stanford-ssi/Aerolotl_AV/floorplan_before_after.png

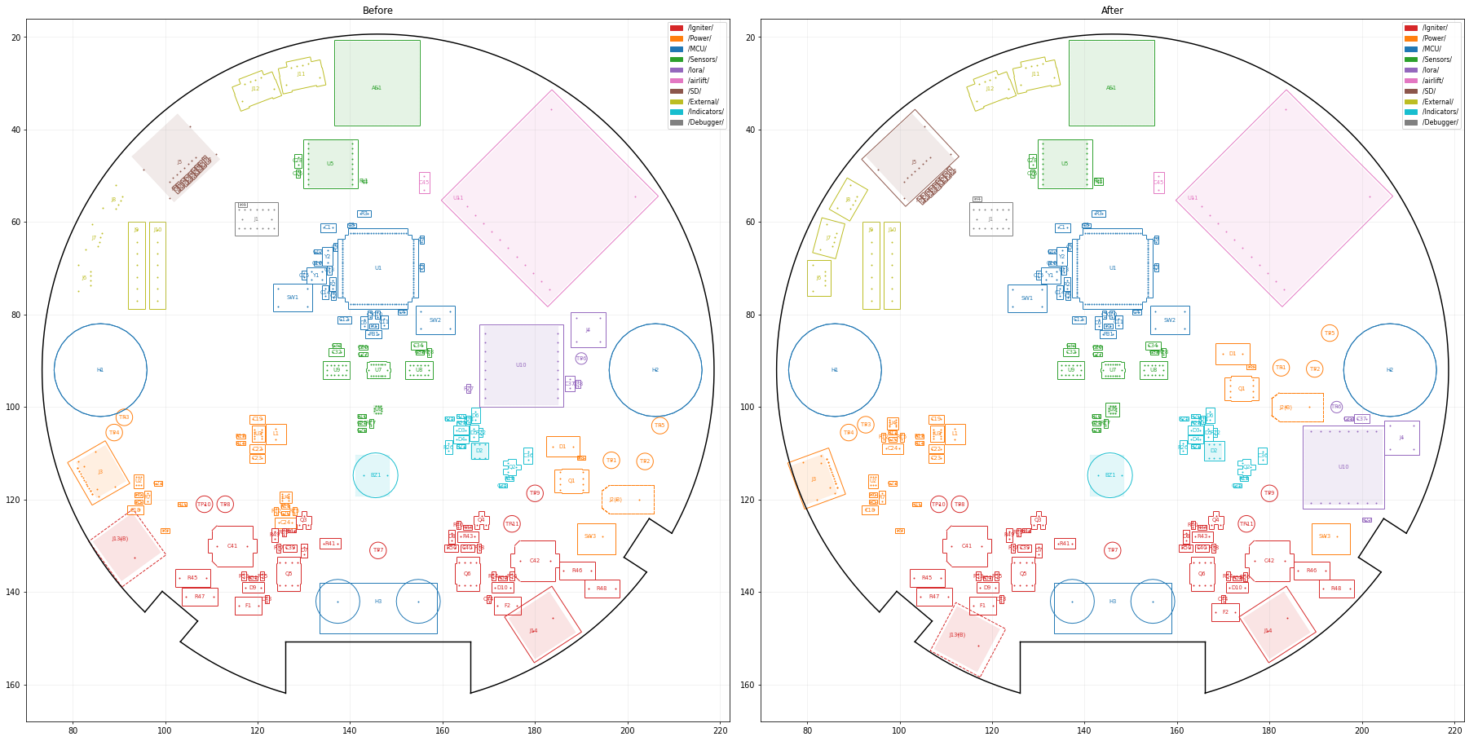
floorplan_before_after.png
