stanford-ssi/Aerolotl_AV/routing_overview.png

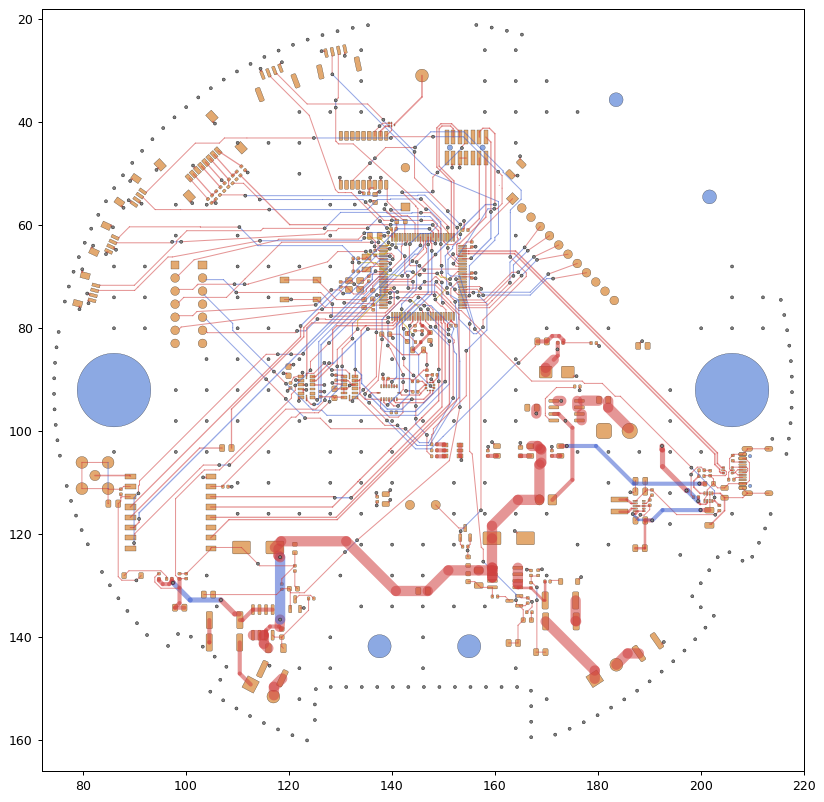
routing_overview.png
