stanford-ssi/Aerolotl_AV/aerolotl_av_BOM.xlsx

Sheet: BOM
Designators | Qty | Value | Footprint | LCSC Part | MPN | Manufacturer | Voltage | Dielectric | Tolerance | ESR / DCR | Power | JLC library | JLC stock (checked 2026-10-02 / 10-06) | Assembly | Side | Sheet | Notes / datasheet check
BZ1 |  | HNB09A03 | BUZ-TH_BD9.0-P5.00-D0.6-FD | C96102 | HNB09A03 | Huaneng |  |  |  |  |  | Extended | 44983 | JLC THT | Top | indicators | Active buzzer (internal oscillator): drive it on/off. PWM is only useful for beep patterns
C1 |  | 4u7 | C_0805_2012Metric | C98195 | CL21B475KAFNNNE | Samsung Electro-Mechanics | 25V | X7R | 10% |  |  | Extended | 311410 | JLC SMT | Top | mcu | STM32G474 DS12288 Fig.16: VDD n x 100nF + 1 x 4.7uF
C2, C3, C4, C5, C7, C8, C9, C25, C26, C27, C29, C30, C31, C33, C35, C38, C43, C44 |  | 100n | C_0402_1005Metric | C1525 | CL05B104KO5NNNC | Samsung Electro-Mechanics | 16V | X7R | 10% |  |  | Basic | 21581667 | JLC SMT | Top | mcu | ADXL345 DS: 0.1uF ceramic at VDD I/O; ADXL375 DS: 0.1uF ceramic at VDD I/O; Ra-01H supply decoupling (TX burst ~120mA); place at module pin 3; STM32G474 DS12288 Fig.16: VREF+ 100nF + 1uF
C6, C11, C12 |  | 1u | C_0603_1608Metric | C29936 | CL10B105KA8NNNC | Samsung Electro-Mechanics | 25V | X7R | 10% |  |  | Extended | 266599 | JLC SMT | Top | mcu | STM32G474 DS12288 Fig.16: VDDA 1uF; STM32G474 DS12288 Fig.16: VREF+ 100nF + 1uF
C10 |  | 10n | C_0402_1005Metric | C15195 | CL05B103KB5NNNC | Samsung Electro-Mechanics | 50V | X7R | 10% |  |  | Basic | 4033054 | JLC SMT | Top | mcu | STM32G474 DS12288 Fig.16: VDDA = 10nF + 1uF (was 100nF)
C13, C15 |  | 15p | C_0402_1005Metric | C1548 | 0402CG150J500NT | FH (Guangdong Fenghua) | 50V | C0G | 5% |  |  | Basic | 1431860 | JLC SMT | Top | mcu | HSE load cap, 12pF crystal: 2 x (12pF - ~4.5pF stray) = ~15pF
C14 |  | 100n | C_0603_1608Metric | C14663 | CC0603KRX7R9BB104 | YAGEO | 50V | X7R | 10% |  |  | Basic | 58141193 | JLC SMT | Top | mcu
C16, C17 |  | 4.7p | C_0402_1005Metric | C1569 | 0402CG4R7C500NT | FH (Guangdong Fenghua) | 50V | C0G | 0.25pF |  |  | Extended (preferred) | 597482 | JLC SMT | Top | mcu | LSE load cap for 6pF crystal: CL = C/2 + Cs (Cs ~3.5-4pF)
C18, C19, C37 |  | 10u | C_0805_2012Metric | C15850 | CL21A106KAYNNNE | Samsung Electro-Mechanics | 25V | X5R | 10% |  |  | Basic | 4951626 | JLC SMT | Top | power | Ra-01H supply decoupling (TX burst ~120mA); place at module pin 3; TPS63802 CIN: 10uF X5R/X7R at VIN-GND (DS 10.2.2.4). 25V 0805 keeps >5uF at 5V bias.; USB 2.0 allows at most 10uF on VBUS at attach (was 22uF)
C20, C21 |  | 1u | C_0402_1005Metric | C52923 | CL05A105KA5NQNC | Samsung Electro-Mechanics | 25V | X5R | 10% |  |  | Basic | 5613299 | JLC SMT | Top | power | TPS2116 VIN1 (VBUS) bypass; TPS2116 VIN2 (+VBAT) bypass
C22, C23, C36 |  | 22u | C_0805_2012Metric | C45783 | CL21A226MAQNNNE | Samsung Electro-Mechanics | 25V | X5R | 20% |  |  | Basic | 3990887 | JLC SMT | Top | power | TPS63802 COUT (DS 10.2.2.3: 22uF nominal, effective >= 10uF after DC bias). Two 0805 25V parts give ~24uF effective at 3.3V.
C24 |  | 100u | C_1206_3216Metric | C15008 | CL31A107MQHNNNE | Samsung Electro-Mechanics | 6.3V | X5R | 20% |  |  | Basic | 1940643 | JLC SMT | Top | power | TPS2116 DS 7.3.4: bulk on VOUT (VSYS) rides through the break-before-make switchover. Also the TPS63802 input bulk.
C28 |  | 10u | C_0603_1608Metric | C19702 | CL10A106KP8NNNC | Samsung Electro-Mechanics | 10V | X5R | 10% |  |  | Basic | 10315650 | JLC SMT | Top | sensors
C32, C34 |  | 1u | CP_EIA-2012-12_Kemet-R | C444768 | TAJR105K010RNJ | Kyocera AVX | 10V | Tantalum (MnO2) | 10% | 25R @100kHz |  | Extended | 2570 | JLC SMT | Top | sensors | ADXL345 DS p.28: 1uF tantalum at VS; ADXL375 DS: 1uF tantalum at VS
C39, C40 |  | 150n | C_0603_1608Metric | C513735 | CC0603KRX7R9BB154 | YAGEO | 50V | X7R | 10% |  |  | Extended | 607110 | JLC SMT | Top | igniter | PMOS gate slow-turn-on cap across +VBAT_ARM (gate-source): 50V part, >10x margin
C41, C42 |  | 330u | CP_Elec_8x10 | C970701 | RVT1E331M0810 | DMBJ | 25V | Aluminum electrolytic | 20% | not specified (standard 105C SMD Al-El) |  | Extended | 1527 | JLC SMT | Top | igniter | Igniter reservoir on +VBAT_ARM (1S, 4.2V max). 25V part kept (already on order list); 6.3V+ would do.
C45 |  | 47u | C_1206_3216Metric | C96123 | CL31A476MPHNNNE | Samsung Electro-Mechanics | 10V | X5R | 20% |  |  | Basic | 296901 | JLC SMT | Top | airlift | Bulk for AirLift (ESP32) Wi-Fi TX current spikes. Place at U11 pin 1 (VIN) / pin 3 (GND). 10V 1206 keeps ~25uF at 3.3V.
D1 |  | SMBJ5.0A | D_SMB | C78423 | SMBJ5.0A | Brightking |  |  |  |  |  | Extended | 113601 | JLC SMT | Top | power | ESD / small-transient TVS only. Breakdown 6.4-7.07V is ABOVE the 6V abs max of U3/U4, so it does not protect them from a surge or a wrong (2S/3S) pack; a wrong pack makes it conduct continuously. Real over-voltage protection needs an OVP switch (open item).
D2 |  | RS-3535MWAR-2JYJY-J | LED-SMD_RS-3535MWAR-2JYJY-J | C110402 | RS-3535MWAR | NATIONSTAR |  |  |  |  |  | Extended | 460049 | JLC SMT | Top | indicators | RS-3535MWAR common anode on +3V3. Resistors set from the datasheet V-I curve: R 270R, G 330R, B 100R
D3 |  | STM LED | LED_0805_2012Metric | C2296 | KT-0805Y | Hubei KENTO |  |  |  |  |  | Basic | 389526 | JLC SMT | Top | indicators
D4 |  | 3V3 LED | LED_0805_2012Metric | C2296 | KT-0805Y | Hubei KENTO |  |  |  |  |  | Basic | 389526 | JLC SMT | Top | indicators
D5 |  | USB LED | LED_0805_2012Metric | C2296 | KT-0805Y | Hubei KENTO |  |  |  |  |  | Basic | 389526 | JLC SMT | Top | indicators
D6 |  | ARM LED | LED_0805_2012Metric | C2296 | KT-0805Y | Hubei KENTO |  |  |  |  |  | Basic | 389526 | JLC SMT | Top | indicators
D7, D8 |  | LED red | LED_0603_1608Metric | C2286 | KT-0603R | Hubei KENTO |  |  |  |  |  | Basic | 4815898 | JLC SMT | Top | igniter
D9, D10 |  | 1N4148W | D_SOD-123 | C81598 | 1N4148W | ST(Semtech) |  |  |  |  |  | Basic | 5168664 | JLC SMT | Top | igniter
F1, F2 |  | 1812L150/24MR | Fuse_1812_4532Metric | C142805 | 1812L150/24MR | Littelfuse |  |  |  |  |  | Extended | 14071 | JLC SMT | Top | igniter
FB1 |  | 100 | L_0805_2012Metric | C1015 | GZ2012D101TF | Sunlord |  |  |  |  |  | Basic | 2341388 | JLC SMT | Top | mcu
FL1 |  | B39162B4300F210 | FILTER-SMD_5P-L1.4-W1.1_RSFPXXXXD | C2650962 | B39162B4300F210 | Qualcomm (RF360) |  |  |  |  |  | Extended | 4559 | JLC SMT | Top | sensors
J1 |  | FTSH-107-STDC14 | STDC14_SAMTEC_FTSH-107-01-L-DV-K-A | C5563894 | FTSH-107-01-L-DV-K-A | Samtec |  |  |  |  |  | Extended | 540 | JLC SMT | Top | swd
J2 |  | Battery (ext.) | AMASS_XT30UPB-M_1x02_P5.0mm_Vertical | C428721 | XT30UPB-M | Changzhou Amass Elec |  |  |  |  |  | Extended | re-check | Hand-solder (bottom side) | Bottom | power | External 1S battery (+BATT pin 1 / GND pin 2), bottom side, hand-solder. AMASS XT30UPB-M vertical male PCB connector, 15A continuous. Mates XT30U-F on the battery lead. Check +/- marking on the housing matches pin 1 = +BATT before soldering.
J3 |  | USB_C_Receptacle_USB2.0_16P | USB_C_Receptacle_HRO_TYPE-C-31-M-12 | C165948 | TYPE-C-31-M-12 | Korean Hroparts |  |  |  |  |  | Extended | 426143 | JLC THT | Top | power
J4 |  | SMA | SMA_BAT-Wireless_BWSMA-KE-Z001_Vertical | C496549 | BWSMA-KE-Z001 | BAT WIRELESS |  |  |  |  |  | Extended | 137898 | JLC THT | Top | lora | 50 ohm. Route ANT-SMA as a short 50R coplanar trace over solid GND.
J5 |  | TF-102-15_SD_read | TF-SMD_TF-102-15 | C266609 | TF-102-15 | XUNPU |  |  |  |  |  | Extended | 19063 | JLC SMT | Top | sd
J6, J8 |  | StemmaQT | StemmaQT | C160390 | BM04B-SRSS-TB(LF)(SN) | JST |  |  |  |  |  | Extended | 52346 | JLC SMT | Top | external
J7 |  | Conn_01x04_Pin | JST_GH_BM04B-GHS-TBT_1x04-1MP_P1.25mm_Vertical | C161692 | BM04B-GHS-TBT(LF)(SN) | JST |  |  |  |  |  | Extended | 14065 | JLC SMT | Top | external
J9 |  | GPIO_PE2-PE6 | PinHeader_1x07_P2.54mm_Vertical | C492406 | PZ254V-11-07P | XFCN |  |  |  |  |  | Extended | 50677 | JLC THT | Top | external
J10 |  | GPIO_PE7-PE11 | PinHeader_1x07_P2.54mm_Vertical | C492406 | PZ254V-11-07P | XFCN |  |  |  |  |  | Extended | 50677 | JLC THT | Top | external
J11 |  | USART3 | JST_GH_BM04B-GHS-TBT_1x04-1MP_P1.25mm_Vertical | C161692 | BM04B-GHS-TBT(LF)(SN) | JST |  |  |  |  |  | Extended | 14065 | JLC SMT | Top | external
J12 |  | LPUART1 | JST_GH_BM04B-GHS-TBT_1x04-1MP_P1.25mm_Vertical | C161692 | BM04B-GHS-TBT(LF)(SN) | JST |  |  |  |  |  | Extended | 14065 | JLC SMT | Top | external
J13 |  | Screw_Terminal_01x02 | TerminalBlock_Kangnex_WJ128V-5.0-2P_C8269 | C8269 | WJ128V-5.0-02P-14-00A | KANGNEX |  |  |  |  |  | Unverified |  | Hand-solder (bottom side) | Bottom | igniter | DROGUE (CH0), bottom side, hand-solder. Fixed 2-pin screw terminal, 5.0 mm pitch; no mating plug. Datasheet: https://www.lcsc.com/datasheet/C8269.pdf
J14 |  | Screw_Terminal_01x02 | TerminalBlock_Kangnex_WJ128V-5.0-2P_C8269 | C8269 | WJ128V-5.0-02P-14-00A | KANGNEX |  |  |  |  |  | Unverified |  | JLC THT | Top | igniter | MAIN (CH1), top side. Fixed 2-pin screw terminal, 5.0 mm pitch; no mating plug. Datasheet: https://www.lcsc.com/datasheet/C8269.pdf
L1 |  | 0.47u | L_Coilcraft_XxL4020 | C18221164 | XFL4015-471MEC | Coilcraft |  |  | 20% | 7.6mR |  | Extended | 2804 | JLC SMT | Top | power | TI-recommended inductor (TPS63802 DS Table 10-2): 0.47uH, Isat 5.4A, 7.6mR, 4x4x1.5mm
Q1, Q5, Q6 |  | DMP2022LSS-13 | SOIC-8_3.9x4.9mm_P1.27mm | C154919 | DMP2022LSS-13 | Diodes Incorporated |  |  |  |  |  | Extended | 651 | JLC SMT | Top | power | High-side igniter PMOS. 1S: Vgs = -VBAT (3.0-4.2V), so Rds(on) must be specified at -2.5V (22mR). FDS6673BZ is specified from -4.5V.; Reverse-polarity PMOS. 1S: Vgs only -3.0 to -4.2V, so a part with Rds(on) specified at -2.5V (22mR) is needed. AO4407A is specified from -4.5V.
Q2, Q3, Q4 |  | AO3400A | SOT-23 | C20917 | AO3400A | AOS |  |  |  |  |  | Basic | 958459 | JLC SMT | Top | indicators
R1 |  | 47 | R_0402_1005Metric | C25118 | 0402WGF470JTCE | UNI-ROYAL | 50V |  | 1% |  | 62.5mW | Extended (preferred) | 391677 | JLC SMT | Top | mcu
R2, R3 |  | 10k | R_0603_1608Metric | C25804 | 0603WAF1002T5E | UNI-ROYAL | 75V |  | 1% |  | 100mW | Basic | 23037967 | JLC SMT | Top | mcu
R4, R22, R42, R44 |  | 100 | R_0402_1005Metric | C25076 | 0402WGF1000TCE | UNI-ROYAL | 50V |  | 1% |  | 62.5mW | Basic | 4080693 | JLC SMT | Top | swd | RGB blue: ~5.5mA typ, 9.5mA worst-case low Vf (<25mA max)
R5, R6 |  | 5k1 | R_0402_1005Metric | C25905 | 0402WGF5101TCE | UNI-ROYAL | 50V |  | 1% |  | 62.5mW | Basic | 6009635 | JLC SMT | Top | power
R7 |  | 0R | R_0603_1608Metric | C21189 | 0603WAF0000T5E | UNI-ROYAL | 75V |  | 1% |  | 100mW | Basic | 23746831 | JLC SMT | Top | power
R8 |  | 100k | R_0402_1005Metric | C25741 | 0402WGF1003TCE | UNI-ROYAL | 50V |  | 1% |  | 62.5mW | Basic | 8233229 | JLC SMT | Top | power
R9, R12, R15, R27, R32, R33, R34, R35, R36, R51, R52, R55, R56 |  | 10k | R_0402_1005Metric | C25744 | 0402WGF1002TCE | UNI-ROYAL | 50V |  | 1% |  | 62.5mW | Basic | 21738660 | JLC SMT | Top | power | Keeps the radio deselected before firmware runs; PR1 divider bottom; VOLT_SENSE divider top
R10 |  | 22k | R_0402_1005Metric | C25768 | 0402WGF2202TCE | UNI-ROYAL | 50V |  | 1% |  | 62.5mW | Basic | 799355 | JLC SMT | Top | power | VOLT_SENSE = VBAT x 22k/32k: 4.2V -> 2.89V, 3.0V -> 2.06V
R11 |  | 33k | R_0402_1005Metric | C25779 | 0402WGF3302TCE | UNI-ROYAL | 50V |  | 1% |  | 62.5mW | Basic | 1209063 | JLC SMT | Top | power | PR1 divider top (from VBUS). VBUS x 10k/43k crosses VREF 1.0V (0.92-1.08) at 4.3V (3.96-4.64V).
R13 |  | 511k | R_0402_1005Metric | C64042 | 0402WGF5113TCE | UNI-ROYAL | 50V |  | 1% |  | 62.5mW | Extended | 175055 | JLC SMT | Top | power | FB top. VOUT = 0.5V x (1 + 511k/91k) = 3.31V (TI DS Table 10-1 values for 3.3V)
R14 |  | 91k | R_0402_1005Metric | C4147 | 0402WGF9102TCE | UNI-ROYAL | 50V |  | 1% |  | 62.5mW | Extended | 12190 | JLC SMT | Top | power | FB bottom
R16, R17, R18, R28, R29, R30, R31 |  | 10 | R_0402_1005Metric | C25077 | 0402WGF100JTCE | UNI-ROYAL | 50V |  | 1% |  | 62.5mW | Basic | 1753546 | JLC SMT | Top | sensors
R19 |  | 3k3 | R_0402_1005Metric | C25890 | 0402WGF3301TCE | UNI-ROYAL | 50V |  | 1% |  | 62.5mW | Basic | 2084377 | JLC SMT | Top | indicators
R20 |  | 270 | R_0402_1005Metric | C25099 | 0402WGF2700TCE | UNI-ROYAL | 50V |  | 1% |  | 62.5mW | Extended | 39060 | JLC SMT | Top | indicators | RGB red: ~5mA (Vf ~1.85V at 5mA, 3.3V anode, MCU sink)
R21, R37, R38 |  | 330 | R_0402_1005Metric | C25104 | 0402WGF3300TCE | UNI-ROYAL | 50V |  | 1% |  | 62.5mW | Basic | 1195841 | JLC SMT | Top | indicators | RGB green: ~2.6mA (green is ~4x brighter than blue per datasheet)
R23, R24 |  | 470 | R_0402_1005Metric | C25117 | 0402WGF4700TCE | UNI-ROYAL | 50V |  | 1% |  | 62.5mW | Basic | 840845 | JLC SMT | Top | indicators
R25 |  | 910 | R_0402_1005Metric | C44933 | 0402WGF9100TCE | UNI-ROYAL | 50V |  | 1% |  | 62.5mW | Extended | 60782 | JLC SMT | Top | indicators
R26 |  | 330 | R_0603_1608Metric | C23138 | 0603WAF3300T5E | UNI-ROYAL | 75V |  | 1% |  | 100mW | Basic | 3256483 | JLC SMT | Top | indicators | ARM LED from +VBAT_ARM: (4.2-2.0)/330 = 6.7mA, 3.0V -> 3mA
R39, R40 |  | 8k2 | R_0402_1005Metric | C25924 | 0402WGF8201TCE | UNI-ROYAL | 50V |  | 1% |  | 62.5mW | Extended (preferred) | 54795 | JLC SMT | Top | igniter
R41, R43 |  | 10k | R_1206_3216Metric | C17902 | 1206W4F1002T5E | UNI-ROYAL | 200V |  | 1% |  | 250mW | Basic | 3041326 | JLC SMT | Top | igniter | PMOS gate pull-up to +VBAT_ARM. 10k: 0.42mA while firing (4.2V). 1206 kept so the footprint does not change.
R45, R46, R47, R48 |  | 1 | R_2512_6332Metric | C840604 | CRM2512-FX-1R00ELF | Bourns | 300V |  | 1% |  | 2W (pulse: ~6W/1s) | Extended | 1117 | JLC SMT | Top | igniter | Igniter series current limit, 2 x 1R in series per channel (3R total with the 1R e-match: ~0.86A at 3.0V, ~1.27A at 4.2V; MJG BP starter all-fire 0.60A, recommended 0.75-1.0A). Per resistor: 1.6W while the match is intact (ms), 3.4W into a shorted output (4.2V/2.3R = 1.83A). Bourns CRM2512 pulse curve (>=1R): ~6W for a 1s single pulse, ~27W for 0.1s. Limit firmware fire time to <= 1s.
R49, R50 |  | 3k3 | R_0603_1608Metric | C22978 | 0603WAF3301T5E | UNI-ROYAL | 75V |  | 1% |  | 100mW | Basic | 5690986 | JLC SMT | Top | igniter | Bleeder: 4.2V^2/3.3k = 5mW
R53, R54 |  | 4.7k | R_0402_1005Metric | C25900 | 0402WGF4701TCE | UNI-ROYAL | 50V |  | 1% |  | 62.5mW | Basic | 15376968 | JLC SMT | Top | igniter | Sense divider top. Firing at 4.2V -> 4.2 x 10k/14.7k = 2.86V at the ADC (was 33k for 12.6V).
SW1 |  | SW_Push | SW_SPST_TL3342 | C2886898 | TL3342F160QG | E-Switch |  |  |  |  |  | Extended | 1892 | JLC SMT | Top | mcu
SW2 |  | SW_SPST | SW_SPST_TL3342 | C2886898 | TL3342F160QG | E-Switch |  |  |  |  |  | Extended | 1892 | JLC SMT | Top | mcu
SW3 |  | SW_SPST | JST_XH_B2B-XH-A_1x02_P2.50mm_Vertical | C158012 | B2B-XH-A(LF)(SN) | JST |  |  |  |  |  | Extended | 305696 | JLC THT | Top | power
U1 |  | STM32G473VET6 | LQFP-100_14x14mm_P0.5mm | C730122 | STM32G473VET6 | STMicroelectronics |  |  |  |  |  | Extended | 99 | JLC SMT | Top | mcu | STM32G473VET6 = G474 without HRTIM (not used here); same die/pinout/LQFP-100. 99 at JLC (G474: 39). Same symbol (STM32G474VETx) is used for the pin map.
U2 |  | USBLC6-2P6 | SOT-666 | C15999 | USBLC6-2P6 | STMicroelectronics |  |  |  |  |  | Extended | 2734 | JLC SMT | Top | power
U3 |  | TPS63802DLAR | TI_VSON-HR-10_2x3mm_P0.5mm_DLA0010A | C2845237 | TPS63802DLAR | Texas Instruments |  |  |  |  |  | Extended | 16686 | JLC SMT | Top | power | 1S buck-boost, VIN 1.3-5.5V, 2A. EN and MODE tied to VIN (always on, forced PWM: lowest ripple for the radio/GPS). Layout per TI DS sec. 12: CIN/COUT next to VIN/VOUT-GND, short L1/L2 loop.
U4 |  | TPS2116DRL | SOT-583-8 | C3235557 | TPS2116DRLR | Texas Instruments |  |  |  |  |  | Extended | 79374 | JLC SMT | Top | power
U5 |  | MAX-M10S | ublox_MAX | C4153167 | MAX-M10S-00B | u-blox |  |  |  |  |  | Extended | 661 | JLC SMT | Top | sensors
U6 |  | BMP581 | LGA-10_L2.0-W2.0-P0.50-TL_BMP581 | C5362283 | BMP581 | Bosch Sensortec |  |  |  |  |  | Extended | 3323 | JLC SMT | Top | sensors
U7 |  | BMI088 | Bosch_LGA-16_4.5x3mm_P0.5mm_LayoutBorder7x1y_ClockwisePinNumbering | C194919 | BMI088 | Bosch Sensortec |  |  |  |  |  | Extended | 4466 | JLC SMT | Top | sensors
U8 |  | ADXL345BCCZ-RL7 | ADI_LGA-14_3x5mm_P0.8mm | C9667 | ADXL345BCCZ-RL7 | Analog Devices |  |  |  |  |  | Extended | 10579 | JLC SMT | Top | sensors
U9 |  | ADXL375BCCZ-RL7 | ADI_LGA-14_3x5mm_P0.8mm | C481898 | ADXL375BCCZ-RL7 | Analog Devices |  |  |  |  |  | Extended | 74 | JLC SMT | Top | sensors | Low stock (74 at JLC)
U10 |  | Ra-01H | Ai-Thinker_Ra-01H_SMD-16_17x16mm | C503593 | Ra-01H | Ai-Thinker |  |  |  |  |  | Extended | 835 | JLC SMT | Top | lora | SX1276 LoRa, 803-930MHz. IREC SRAD band 913.0-917.0MHz, <=500mW, no hopping. Keep NSS high / put in sleep if unused; never TX without an antenna or 50R load. RESET is open-drain (drive low or Hi-Z only).
U11 |  | Airlift | Ada_Airlift | C2897375 | PM254-1-12-Z-8.5 | HCTL |  |  |  |  |  | Extended | 9922 | Optional (not in JLC BOM) | Top | airlift | The board-side part is the 1x12 female socket. The Airlift module (Adafruit 4201) plugs in; Also: Adafruit AirLift ESP32 breakout PID 4201 (plugs in, not from LCSC)
Y1 |  | 25MHz | Crystal_SMD_3225-4Pin_3.2x2.5mm | C9006 | X322525MOB4SI | YXC |  |  |  |  |  | Basic | 198173 | JLC SMT | Top | mcu | 25MHz 12pF crystal
Y2 |  | 32.768kHz | Crystal_SMD_3215-2Pin_3.2x1.5mm | C20340322 | FC-135 32.7680KA-E | Seiko Epson |  |  |  |  |  | Extended | 4075 | JLC SMT | Top | mcu | 6pF / 70k ESR crystal: gm_crit ~0.6uA/V. Use LSEDRV = medium-high (1.7uA/V max) for >2x margin
Total placements
BOM lines missing an LCSC number
Not in BOM (no part to buy): TP1-TP11 test points, H1/H2 (3/8in rod holes), H3 (TeleMetrum sled holes).

Sheet: JLC_BOM
Comment | Designator | Footprint | LCSC Part #
HNB09A03 | BZ1 | BUZ-TH_BD9.0-P5.00-D0.6-FD | C96102
CL21B475KAFNNNE | C1 | C_0805_2012Metric | C98195
CL05B104KO5NNNC | C2,C3,C4,C5,C7,C8,C9,C25,C26,C27,C29,C30,C31,C33,C35,C38,C43,C44 | C_0402_1005Metric | C1525
CL10B105KA8NNNC | C6,C11,C12 | C_0603_1608Metric | C29936
CL05B103KB5NNNC | C10 | C_0402_1005Metric | C15195
0402CG150J500NT | C13,C15 | C_0402_1005Metric | C1548
CC0603KRX7R9BB104 | C14 | C_0603_1608Metric | C14663
0402CG4R7C500NT | C16,C17 | C_0402_1005Metric | C1569
CL21A106KAYNNNE | C18,C19,C37 | C_0805_2012Metric | C15850
CL05A105KA5NQNC | C20,C21 | C_0402_1005Metric | C52923
CL21A226MAQNNNE | C22,C23,C36 | C_0805_2012Metric | C45783
CL31A107MQHNNNE | C24 | C_1206_3216Metric | C15008
CL10A106KP8NNNC | C28 | C_0603_1608Metric | C19702
TAJR105K010RNJ | C32,C34 | CP_EIA-2012-12_Kemet-R | C444768
CC0603KRX7R9BB154 | C39,C40 | C_0603_1608Metric | C513735
RVT1E331M0810 | C41,C42 | CP_Elec_8x10 | C970701
CL31A476MPHNNNE | C45 | C_1206_3216Metric | C96123
SMBJ5.0A | D1 | D_SMB | C78423
RS-3535MWAR | D2 | LED-SMD_RS-3535MWAR-2JYJY-J | C110402
KT-0805Y | D3,D4,D5,D6 | LED_0805_2012Metric | C2296
KT-0603R | D7,D8 | LED_0603_1608Metric | C2286
1N4148W | D9,D10 | D_SOD-123 | C81598
1812L150/24MR | F1,F2 | Fuse_1812_4532Metric | C142805
GZ2012D101TF | FB1 | L_0805_2012Metric | C1015
B39162B4300F210 | FL1 | FILTER-SMD_5P-L1.4-W1.1_RSFPXXXXD | C2650962
FTSH-107-01-L-DV-K-A | J1 | STDC14_SAMTEC_FTSH-107-01-L-DV-K-A | C5563894
TYPE-C-31-M-12 | J3 | USB_C_Receptacle_HRO_TYPE-C-31-M-12 | C165948
BWSMA-KE-Z001 | J4 | SMA_BAT-Wireless_BWSMA-KE-Z001_Vertical | C496549
TF-102-15 | J5 | TF-SMD_TF-102-15 | C266609
BM04B-SRSS-TB(LF)(SN) | J6,J8 | StemmaQT | C160390
BM04B-GHS-TBT(LF)(SN) | J7,J11,J12 | JST_GH_BM04B-GHS-TBT_1x04-1MP_P1.25mm_Vertical | C161692
PZ254V-11-07P | J9,J10 | PinHeader_1x07_P2.54mm_Vertical | C492406
WJ128V-5.0-02P-14-00A | J14 | TerminalBlock_Kangnex_WJ128V-5.0-2P_C8269 | C8269
XFL4015-471MEC | L1 | L_Coilcraft_XxL4020 | C18221164
DMP2022LSS-13 | Q1,Q5,Q6 | SOIC-8_3.9x4.9mm_P1.27mm | C154919
AO3400A | Q2,Q3,Q4 | SOT-23 | C20917
0402WGF470JTCE | R1 | R_0402_1005Metric | C25118
0603WAF1002T5E | R2,R3 | R_0603_1608Metric | C25804
0402WGF1000TCE | R4,R22,R42,R44 | R_0402_1005Metric | C25076
0402WGF5101TCE | R5,R6 | R_0402_1005Metric | C25905
0603WAF0000T5E | R7 | R_0603_1608Metric | C21189
0402WGF1003TCE | R8 | R_0402_1005Metric | C25741
0402WGF1002TCE | R9,R12,R15,R27,R32,R33,R34,R35,R36,R51,R52,R55,R56 | R_0402_1005Metric | C25744
0402WGF2202TCE | R10 | R_0402_1005Metric | C25768
0402WGF3302TCE | R11 | R_0402_1005Metric | C25779
0402WGF5113TCE | R13 | R_0402_1005Metric | C64042
0402WGF9102TCE | R14 | R_0402_1005Metric | C4147
0402WGF100JTCE | R16,R17,R18,R28,R29,R30,R31 | R_0402_1005Metric | C25077
0402WGF3301TCE | R19 | R_0402_1005Metric | C25890
0402WGF2700TCE | R20 | R_0402_1005Metric | C25099
0402WGF3300TCE | R21,R37,R38 | R_0402_1005Metric | C25104
0402WGF4700TCE | R23,R24 | R_0402_1005Metric | C25117
0402WGF9100TCE | R25 | R_0402_1005Metric | C44933
0603WAF3300T5E | R26 | R_0603_1608Metric | C23138
0402WGF8201TCE | R39,R40 | R_0402_1005Metric | C25924
1206W4F1002T5E | R41,R43 | R_1206_3216Metric | C17902
CRM2512-FX-1R00ELF | R45,R46,R47,R48 | R_2512_6332Metric | C840604
0603WAF3301T5E | R49,R50 | R_0603_1608Metric | C22978
0402WGF4701TCE | R53,R54 | R_0402_1005Metric | C25900
TL3342F160QG | SW1,SW2 | SW_SPST_TL3342 | C2886898
B2B-XH-A(LF)(SN) | SW3 | JST_XH_B2B-XH-A_1x02_P2.50mm_Vertical | C158012
STM32G473VET6 | U1 | LQFP-100_14x14mm_P0.5mm | C730122
USBLC6-2P6 | U2 | SOT-666 | C15999
TPS63802DLAR | U3 | TI_VSON-HR-10_2x3mm_P0.5mm_DLA0010A | C2845237
TPS2116DRLR | U4 | SOT-583-8 | C3235557
MAX-M10S-00B | U5 | ublox_MAX | C4153167
BMP581 | U6 | LGA-10_L2.0-W2.0-P0.50-TL_BMP581 | C5362283
BMI088 | U7 | Bosch_LGA-16_4.5x3mm_P0.5mm_LayoutBorder7x1y_ClockwisePinNumbering | C194919
ADXL345BCCZ-RL7 | U8 | ADI_LGA-14_3x5mm_P0.8mm | C9667
ADXL375BCCZ-RL7 | U9 | ADI_LGA-14_3x5mm_P0.8mm | C481898
Ra-01H | U10 | Ai-Thinker_Ra-01H_SMD-16_17x16mm | C503593
X322525MOB4SI | Y1 | Crystal_SMD_3225-4Pin_3.2x2.5mm | C9006
FC-135 32.7680KA-E | Y2 | Crystal_SMD_3215-2Pin_3.2x1.5mm | C20340322

Sheet: Hand assembly & loose
Item | Designator | LCSC Part | MPN | Qty | Why / how
Drogue screw terminal (bottom side) | J13 | C8269 | WJ128V-5.0-02P-14-00A | 1 | Fixed terminal on B.Cu; hand-solder after top-side assembly. No mating plug.
Battery connector (bottom side) | J2 | C428721 | XT30UPB-M | 1 | AMASS XT30 vertical male, THT on B.Cu, hand-solder. Pin 1 = +BATT, pin 2 = GND. Check the +/- moulding on the housing against the footprint silk before soldering.
Obsolete terminal plugs — do not purchase | Former mates for J13, J14 |  |  | 0 | C8269 is a fixed screw terminal. Separate C63303 plugs are no longer required.
Battery cable connector | mates J2 |  | AMASS XT30U-F (female, on the battery lead) | 1 | Make the harness to the CamControl battery board. AWG22 for the 3A rating.
GPS patch antenna (NOT in JLC BOM) | AE1 | Mouser 960-GP1575184A02 | Taoglas GP.1575.18.4.A.02 | 1 | Order from Mouser (214 in stock on 2026-10-05, $4.72). Hand-place: feed pin through the board + adhesive. LCSC C7281913 has 0 stock.
Radio antenna + coax | J4 |  | 915MHz SMA antenna, SMA-SMA RG-316 cable | 1 | Mount the antenna on a bracket away from the board and ground plane. Never transmit with J4 open.
Adafruit AirLift breakout | U11 | C2897375 (socket) | Adafruit PID 4201 + PM254-1-12-Z-8.5 | 1 | Optional (U11 is in_bom=no). Socket is THT, can go in JLC THT if wanted.
M4 screws, washers, nuts for TeleMetrum sled | H3 |  | M4x0.7 SHCS x10/x12 (Onshape BOM) | 2 | Through H3 into the sled nut traps.
3/8-16 threaded rod hardware | H1, H2 |  | Hex nut 3/8-16 + 3/8 washers | 4 | Clamp the board on the rods. 9.6mm keepout ring on both sides.

Sheet: Changes
Area | Change | Reason / source
1S battery | Pack is now 1S Li-ion (3.0-4.2V), external on J2 (JST PH, bottom). Removed the LMR51430 buck (old U2, L1, C18, C21, C22, C23, R8, R9) and the AMS1117 USB LDO (old U3, C20). New path: TPS2116 mux U4 with VIN1 = USB VBUS (priority) and VIN2 = +VBAT, output VSYS, then a TPS63802 buck-boost U3 makes +3V3. | User request (3S -> 1S). A 1S cell sits below 3.3V for most of its discharge (3.7V nominal, 3.0V empty), so a buck or LDO cannot hold 3.3V; a buck-boost can.
TPS63802 | U3 TPS63802DLAR (C2845237). L1 0.47uH Coilcraft XFL4015-471MEC (C18221164, Isat 5.4A, 7.6mR). C19 10uF/25V X5R 0805 in, C22 + C23 22uF/25V X5R 0805 out. FB R13 511k / R14 91k -> 3.31V. EN and MODE tied to VIN (always on, forced PWM). PG not used. | TPS63802 DS (SLVSEU9D) sec. 10.2: Table 10-1 (511k/91k for 3.3V), Table 10-2 (XFL4015-471ME), 10uF CIN, 22uF COUT (effective >= 10uF after DC bias; two 25V 0805 parts give margin).
TPS63802 footprint | New aerolotl_custom:TI_VSON-HR-10_2x3mm_P0.5mm_DLA0010A. Pads 1-5 0.6x0.25 at x=-0.9; 6,7,9,10 0.9x0.25 at x=+0.75; pin 8 (GND) 1.3x0.25 running under the body; 0.5mm pitch. | TI DLA0010A example board layout (4223750/D). KiCad has no footprint for this package.
Power mux | U4 TPS2116: VIN1 = P_VBUS with MODE tied to VIN1 (priority mode), PR1 divider R11 33k / R12 10k -> USB selected when VBUS > 4.3V (VREF 0.92-1.08V -> 3.96-4.64V). VIN2 = +VBAT. VOUT = VSYS, C24 100uF bulk kept. | TPS2116 DS sec. 7.6.1: priority mode = MODE tied to VIN1 + divider to PR1. USB VBUS minimum 4.75V clears the worst-case threshold.
Net names | +12V -> +VBAT and +12V_ARM -> +VBAT_ARM (new aerolotl_custom power symbols; old +12V_ARM symbol renamed). TP2 +VBAT, TP7 +VBAT_ARM. Netclass patterns and the In2 zone follow. Removed patterns for nets that no longer exist (+3V3_BAT, USB_3V3, BUCK_SW, VBAT_PACK, BAT_TAP_*). Added VSYS, BB_SW1, BB_SW2 to PWR_LO. | User request. "VBAT" is the reverse-protected battery rail (after Q1); +BATT is the raw connector side.
PMOS | Q1 (reverse polarity), Q5 and Q6 (igniter high-side) -> DMP2022LSS-13 (C154919), same SO-8 pinout. | At 1S the gate sees only -3.0 to -4.2V. DMP2022LSS is specified 22mR at Vgs -2.5V. AO4407A and FDS6673BZ are specified from -4.5V.
D1 TVS | D1 SMBJ15A -> SMBJ5.0A (C78423). | Standoff 5.0V clears the 4.2V full charge. CORRECTION: its 6.4-7.07V breakdown is above the 6V abs max of U3/U4, so it is ESD/small-transient protection only, not surge or wrong-pack protection. See open items.
J2 battery connector | J2 JST PH -> JST XH B2B-XH-A (C158012), 3A per contact with AWG22. Same bottom-side position (moved 0.5mm to clear). | Battery current budget: avionics ~1.3A at 3.0V plus e-match firing current share J2.
Igniter series R | R45 + R47 (drogue) and R46 + R48 (main): 2 x 1R Bourns CRM2512-FX-1R00ELF (C840604, 2W, 2512) in series per channel, between the PMOS drain (IGNx_HS, where the continuity/fire sense taps) and the terminal (IGNx_OUT). Nets IGNx_RLIM/IGNx_OUT added to PWR_HI. Terminal blocks moved right on the schematic. | MJG BP starter: 1.0R, all-fire 0.60A, recommended 0.75-1.0A. Loop ~3.3-3.5R gives ~0.86A at 3.0V, ~0.94A at 3.3V, ~1.27A at 4.2V. Per resistor: 1.6W while the match is intact, 3.4W into a shorted output (1.83A); Bourns pulse curve allows ~6W for 1s, ~27W for 0.1s, so two 1R parts (not one 2R) with a <=1s firmware fire pulse. Sense thresholds unchanged because the sense tap stays on the drain side.
U11 bulk cap | Added C45 47uF/10V X5R 1206 (C96123) at U11 VIN/GND. | AirLift VIN allows 3.3-5V but the ESP32 Wi-Fi TX spikes (~0.5A) need local bulk.
Battery sense | R10 3k3 -> 22k. VOLT_SENSE = VBAT x 22k/32k (4.2V -> 2.89V, 3.0V -> 2.06V). | Uses most of the 3.3V ADC range for a 1S cell. Firmware scale: VBAT = V_adc x 1.4545.
Igniters | Gate pull-ups R41/R43 1k -> 10k 1206 (C17902). Fire-sense dividers R53/R54 33k -> 4.7k 0402 (C25900). Notes and the sense text block updated. | At 4.2V the old 33k/10k divider gave only 1V while firing. 4.7k/10k gives 2.86V. Firmware thresholds: open ~1.0V, e-match present ~0V, firing ~2.9V.
ARM LED | R26 3k3 -> 330R 0603 (C23138). | (4.2V - 2.0V) / 330R = 6.7mA, 3mA at 3.0V. 3k3 would leave the LED dark on 1S.
MCU | U1 -> STM32G473VET6 (C730122). PA4 (pin 26) is now no-connect. The SPARE_ADC1 sheet pin was removed. | G473 = G474 without HRTIM, which this board does not use. Same die, pinout and LQFP-100. 99 in stock at JLC vs 39 for the G474.
ERC | Cleared every item in ERC.rpt: SPARE_ADC1 sheet pin and the U1 pin 26 error; refreshed Device:C_Polarized, Device:D and Connector:Conn_01x07_Pin to the KiCad 10.0.6 library copies (C41/C42, D9/D10, J9/J10); unspecified pins -> passive in all custom symbols (AO4407A, FDS6673BZ, RS-3535MWAR, 17-21SUYC, HNB09A03, SMBJ15A, PTC fuse, GX2512, SEA-12095, ADXL375 INT2/NC); U7 BMI088 moved to aerolotl_custom:BMI088 with SDO1/SDO2 as tri-state (it shares SPI1 MISO with the ADXL parts); removed the duplicate IGN0_CONT/IGN1_CONT labels (nets keep IGN0_HS/IGN1_HS); renamed U11 fields "Mfr. " / "Mfr. Part No." to "Module Mfr" / "Module PN". | ERC.rpt from 2026-10-06 02:16. The BMI088 SDO pins really are tri-state in SPI mode, so the KiCad library pin type was the wrong one.
Re-annotation | Every reference renumbered in sheet page order (MCU, Debugger, Power, Sensors, Indicators, lora, SD, External, Igniter, airlift), then by X then Y on the sheet (KiCad "sort by X"). Power symbols and flags too. The PCB was updated by symbol path, so placement is unchanged. See the "Ref map" sheet. | User request: numbering had gaps after deleting parts. Re-run after adding the igniter resistors (igniter R45-R56 shifted). Rows below this one use the old numbering.
PCB | Deleted old U2, U3, L1, C18, C20, C21, C22, C23. Placed the TPS63802 block in the old buck area: U3 with L1 on the L1/L2 side, C20 at VIN, C22/C23 at VOUT, FB resistors R13/R14 on the FB side. Every pad net now follows the schematic (my netlist check matches pad-for-pad). | Board is unrouted. Review placement before routing.
(older rows: old refs)
LoRa radio | Added U12 Ai-Thinker Ra-01H (SX1276, 915MHz) on its own SPI4 bus, J16 vertical SMA (BWSMA-KE-Z001), C45 10u + C46 100n decoupling, R52 10k NSS pull-up, TP11 scope pad on DIO0. J5 SPI4 header removed. NSS=PD1, RESET=PD2 (open-drain), DIO0=PC3 (EXTI3), DIO1=PF10 (EXTI10), DIO3=PC13 (EXTI13), DIO2=PC2 and DIO4=PF2 (polled), DIO5 not connected. | Telemetry hardware ready for later. Only PC3/PF10/PC13 have free EXTI lines. SDSPI.MOSI bus breakout moved one row on the MCU sheet to make room for PC13.
RGB LED | R19 270R (C25099), R20 330R, R21 100R (C25076) | RS-3535MWAR datasheet V-I curve on a 3.3V common anode
AE1 | Excluded from BOM; order from Mouser 960-GP1575184A02 | No LCSC/JLC stock
Board outline | Outline changed from a 152.4mm circle to the lower (CamControl) PCB outline from Onshape: 145.29mm dia, a 40mm-wide TeleMetrum notch at the bottom (inner edge 14mm in), and two 10mm x 6mm radial wire slots at 130 and 33 deg. | Onshape AV Bay - Parametric, CamControl battery PCB top face. The coupler inner disc is 147.3mm, so the old 152.4mm board would not fit. Removed the "add cutouts" text from Edge.Cuts.
Threaded rods | H1/H2 moved to exactly (center +/-60mm, center), symmetric on the horizontal center line. Hole is 10.32mm NPTH, with a 9.6mm-radius courtyard and copper keepout on both sides for the washer and nut. | Onshape rod holes r=5.159 at x=+/-60. Old holes were M6 (6.4mm), too small for 3/8" rod, and off-center (65.8 / 65.45mm, y +0.25).
TeleMetrum | Added H3: 2x 4.5mm M4 holes 17.4mm apart, 50mm below center. M4 washer keepout on top, sled-body keepout on the bottom. | Onshape TeleMetrum sled (3D print) bolt holes r=2.25 at (+/-8.7, -50). The sled stands between this board and the lower PCB.
J10 / J11 | JST GH 7-pin replaced by 2.54mm 1x7 pin headers (PZ254V-11-07P). Moved to the left side next to the other external connectors. GPIO names added on silkscreen. | Request. The MPN field said SM07B (horizontal) while the footprint was BM07B (vertical), which was also inconsistent.
U11 Airlift | New Ada_Airlift footprint built from the Adafruit Eagle board: 1x12 header with correct pin order, 31.75x33.02mm outline, two M2.5 holes, and a copper keepout under the ESP32 antenna. Placed on the right side, clear of the rod. Updated in both aerolotl_av and aerolotl libraries. | github.com/adafruit/Adafruit-AirLift-Breakout-PCB. The old footprint had no pads, and the board used a plain 1x12 socket.
Igniter terminals | J15 MAIN (top) and J14 DROGUE (bottom) are now vertical pluggable headers (Kangnex WJ2EDGVM-5.08, screw-flange) with WJ2EDGKM screw plugs, so the wires leave perpendicular to the board. J14 sits next to slot A so drogue wires drop through the lower PCB slot. | Request: main routes upward, drogue underneath and hand-soldered. JLC has no stock of a one-piece vertical screw terminal.
Battery | BT1-BT3 18650 holders removed. J3 (was XT30 pin-switch) is now the external battery input: JST PH 2-pin on the bottom (+BATT / GND). Removed the leftover VBAT_PACK label that tied J3 pin 2 to GND. | Request: batteries are external. Matches your edit that rewired J3 to +BATT/GND.
Re-placement | Moved edge connectors 3.6mm in (J2, J4, J5, J6, J9, J12) and AE1 2.6mm in, both igniter channels up and outward away from the sled washers and notch, indicators and the buzzer into the free right-middle area, SW3, TP3 and TP6, plus small nudges to clear new courtyards. The buck inductor moved for the larger part. | The new outline, holes and keepouts. The board is unrouted, so nothing was ripped up. Review the placement.
MCU | Every used U1 pin now shows its function (KiCad pin alternates: USART2_TX, SPI1_SCK, ADC1_IN1 and so on). Added GPIO_Output, GPIO_Input and GPIO_EXTIx alternates for plain-GPIO pins to the symbol, both embedded and in the library. | Request. All 42 AF functions in AV_PINMAP.md exist as G474 alternates, which confirms the pin map.
C9 | 100nF -> 10nF (VDDA HF cap) | STM32G474 DS12288 Fig.16: VDDA 10nF + 1uF
Y2, C16, C17 | LSE crystal Epson FC-135 32.7680KA-E (6pF, 70k). Load caps 15pF -> 4.7pF C0G. | 15pF caps on a 6-12.5pF crystal pull the frequency. A 6pF crystal keeps gm_crit at about 0.6uA/V, under the 1.7uA/V of LSEDRV medium-high.
C19 | 22uF -> 10uF on VBUS | USB 2.0 limits capacitance on VBUS at attach to 10uF
C20 | 22uF MLCC -> 22uF/16V tantalum (2.3R ESR), case B | AMS1117 datasheet: 22uF solid tantalum on the output for stability. A low-ESR MLCC alone can oscillate.
C21 | 4.7uF 0805 -> 10uF/50V X7R 1206 | LMR51430 DS 9.2.2.6: CIN >= 4.7uF, rated about 2x VIN max (12.6V)
L1 | 4.7uH 4030 (Isat ~2A) -> 5.6uH FXL0630 (Isat 5.5A, 42mR) | LMR51430 Table 9-1 (500kHz, 3.3V) calls for 5.6uH, and Isat must exceed the 4.76A typ HS current limit
C30, C34 | 1uF 0402 MLCC -> 1uF/10V tantalum (case R) | ADXL345 / ADXL375 datasheets: 1uF tantalum at VS, 0.1uF ceramic at VDD I/O
U7, U9 | Both now use ADI_LGA-14_3x5mm_P0.8mm (ADI recommended land pattern). Pin orientation is preserved. | ADXL345 DS Fig.59. The two old footprints for the same package disagreed, and the ADXL375 one had 1.77mm hand-solder pads.
U2 | Footprint SOT-23-6 -> TSOT-23-6 | LMR51430XFDDCR is the DDC (thin SOT) package. The pads are identical.
R12 | 5k -> 4.99k | 5k is not a stocked 1% value. PR1 threshold 1.134V vs 1.136V.
AE1 | Footprint field had no library nickname (it would fail to resolve) | Fixed to aerolotl_custom:ANT_GP.1575.18.4.A.02_TAL
Test points | TP1-TP10 excluded from BOM | Plated holes with no part to buy
All parts | LCSC Part, MPN, Manufacturer, Voltage, Dielectric, Tolerance, ESR/DCR and Power fields filled on every symbol (and mirrored into the PCB). The duplicate "LCSC" field was merged into "LCSC Part". | LCSC/JLC part data checked 2026-10-02
D9 | Removed an orphan duplicate D9 footprint (no schematic link). The linked D9 now sits in its place. | PCB vs schematic sync
J2 | JST XH B2B-XH-A (C158012) -> AMASS XT30UPB-M (C428721), KiCad Connector_AMASS footprint + model. Same position, bottom side; pad 1 stays put. | Higher current, polarized battery connector
J13, J14 | PCB footprint now TerminalBlock_Kangnex_WJ128V-5.0-2P_C8269 (5.00mm pitch, fixed screw terminal) with its LCSC 3D mesh. Courtyard tightened to body + 0.5mm. | Schematic already specified C8269; PCB was still on the pluggable WJ2EDGVM
H1, H2 | New footprint MountingHole_3-8in_Grommet_Heyco_G1123_D14.3mm: 14.3mm NPTH, keepout/courtyard 20.1mm dia (19.1mm flange + 0.5mm). | Heyco G1123 / RG562-14-2 grommet on the 3/8in rods
Q1, Q5, Q6, D1, D3-D6, F1, F2, Y1 | Custom EasyEDA footprints/models -> KiCad library (SOIC-8_3.9x4.9mm_P1.27mm, D_SMB, LED_0805_2012Metric, Fuse_1812_4532Metric, Crystal_SMD_3225-4Pin_3.2x2.5mm). LCSC/MPN unchanged. | Use stock KiCad footprints + 3D models
D3-D6 symbol | 17-21SUYC_TR8 pin numbers swapped (K = pin 1, A = pin 2) to match the KiCad LED footprint convention. Wiring and nets unchanged. | KiCad LED_0805 pad 1 is the cathode

Sheet: Open items
# | Item | Suggested action
1 | Open KiCad, run Tools > Update PCB from Schematic (F8), then ERC and DRC. I could not run KiCad from here. My own netlist and ERC-style checks are clean. | F8 should show only net renames (KiCad names some nets differently from my sync). Re-pour zones. The In2 split (+VBAT right, +3V3 rest) was drawn for the old layout, so redraw it.
2 | 1S ONLY on J2. Everything after Q1 is rated about 5.5-6V (TPS2116, TPS63802, SMBJ5.0A clamps at 9.2V). | Consider a "1S Li-ion ONLY" silkscreen next to J2 and a keyed harness.
3 | TPS63802 layout (TI DS sec. 12) | Keep the CIN-VIN-GND and COUT-VOUT-GND loops tight on the top layer, short wide L1/L2 traces, GND pin 8 straight into the In1 plane with several vias, FB trace away from L1.
4 | Firmware constants changed | VOLT_SENSE x 1.4545 = VBAT. Igniter sense: open ~1.0V, e-match ~0V, firing ~2.9V. Low-battery cutoff around 3.3-3.4V at the cell.
5 | E-match: MJG BP Rocket Starter, 1.0 +/-0.2 ohm, no-fire 0.30A, all-fire 0.60A, recommended min 0.75A, nominal 1.0A, max test 40mA (electricmatch.com). 0.5A is BELOW the all-fire current. | Design and test for >= 0.75A at the lowest cell voltage, coldest temperature and longest leads. Continuity bias is ~0.26mA, well under the 40mA test limit.
6 | Firing current is now set by R45+R47 / R46+R48 (2R per channel): ~0.86A at 3.0V to ~1.27A at 4.2V with a 1.0R match and ~0.3R of wiring/PTC/FET/cell. | Firmware: fire pulse <= 1s (resistor pulse rating). Measure the real loop resistance with the actual leads (3 ft leads add resistance); at a 3.0V cutoff it must stay under ~0.5R for >= 0.75A. J2 peak ~1.3A avionics + ~1.3A firing = ~2.6A, inside the XH 3A rating; the 1812L150 PTC (1.5A hold) no longer trips on a normal fire but does on a shorted output.
7 | Wrong-pack / surge protection is not solved by D1. | Add an OVP switch after Q1 (TPS25947 eFuse or LTC4365 + 2 N-FETs), put the TVS on its input sized to its abs max, add a gate-source zener on Q1, and a bulk electrolytic at J2 to damp hot-plug ringing.
8 | BZ1 HNB09A03 is an active buzzer (it has its own oscillator). The MCU net is BUZZER_PWM on TIM1_CH1. | Drive it on/off. It is a 3V part, so 3V3 is fine.
9 | U1 STM32G473VET6: 99 at JLC. DMP2022LSS-13: 651 at JLC (3 per board). ADXL375: low stock. | Reserve parts on JLC before you submit.
10 | AE1 Taoglas GP.1575.18.4.A.02 is not in the JLC BOM. | Order from Mouser (960-GP1575184A02) and hand-place.
11 | LoRa RF trace U10 pin 1 -> J4 is about 6.7mm. | Route it as 50R grounded coplanar waveguide over the In1 GND plane with via fencing. Keep other traces out from under the module.
12 | Standard-library footprints I added (L_Coilcraft_XxL4020 for the new L1, PinHeader_1x07, JST_PH_B2B, CP_EIA tantalum) came from an older copy of the KiCad library. | In KiCad: Tools > Update Footprints from Library on those refs.

Sheet: Ref map
Old ref | New ref | Sheet
(new part) | C45 | airlift
U11 | U11 | airlift
C45 | C37 | lora
C46 | C38 | lora
J16 | J4 | lora
R52 | R27 | lora
TP11 | TP6 | lora
U12 | U10 | lora
J7 | J6 | external
J9 | J7 | external
J8 | J8 | external
J10 | J9 | external
J11 | J10 | external
J6 | J11 | external
J12 | J12 | external
C39 | C39 | igniter
C42 | C40 | igniter
C40 | C41 | igniter
C43 | C42 | igniter
C41 | C43 | igniter
C44 | C44 | igniter
D7 | D7 | igniter
D10 | D8 | igniter
D8 | D9 | igniter
D9 | D10 | igniter
F1 | F1 | igniter
F2 | F2 | igniter
J14 | J13 | igniter
J15 | J14 | igniter
Q4 | Q3 | igniter
Q6 | Q4 | igniter
Q3 | Q5 | igniter
Q5 | Q6 | igniter
R40 | R37 | igniter
R51 | R38 | igniter
R39 | R39 | igniter
R50 | R40 | igniter
R37 | R41 | igniter
R38 | R42 | igniter
R45 | R43 | igniter
R46 | R44 | igniter
(new part) | R45 | igniter
(new part) | R46 | igniter
(new part) | R47 | igniter
(new part) | R48 | igniter
R36 | R49 | igniter
R43 | R50 | igniter
R41 | R51 | igniter
R47 | R52 | igniter
R42 | R53 | igniter
R48 | R54 | igniter
R44 | R55 | igniter
R49 | R56 | igniter
TP6 | TP7 | igniter
TP7 | TP8 | igniter
TP8 | TP9 | igniter
TP9 | TP10 | igniter
TP10 | TP11 | igniter
BZ1 | BZ1 | indicators
C37 | C35 | indicators
C38 | C36 | indicators
D2 | D2 | indicators
D3 | D3 | indicators
D4 | D4 | indicators
D5 | D5 | indicators
D6 | D6 | indicators
Q2 | Q2 | indicators
R26 | R19 | indicators
R19 | R20 | indicators
R20 | R21 | indicators
R21 | R22 | indicators
R22 | R23 | indicators
R23 | R24 | indicators
R24 | R25 | indicators
R25 | R26 | indicators
C2 | C1 | mcu
C3 | C2 | mcu
C4 | C3 | mcu
C5 | C4 | mcu
C12 | C5 | mcu
C13 | C6 | mcu
C6 | C7 | mcu
C7 | C8 | mcu
C8 | C9 | mcu
C9 | C10 | mcu
C10 | C11 | mcu
C11 | C12 | mcu
C14 | C13 | mcu
C1 | C14 | mcu
C15 | C15 | mcu
C16 | C16 | mcu
C17 | C17 | mcu
FB1 | FB1 | mcu
H1 | H1 | mcu
H2 | H2 | mcu
H3 | H3 | mcu
R3 | R1 | mcu
R1 | R2 | mcu
R2 | R3 | mcu
SW2 | SW1 | mcu
SW1 | SW2 | mcu
U1 | U1 | mcu
Y1 | Y1 | mcu
Y2 | Y2 | mcu
C19 | C18 | power
(new part) | C19 | power
C24 | C20 | power
C26 | C21 | power
(new part) | C22 | power
(new part) | C23 | power
C25 | C24 | power
D1 | D1 | power
J3 | J2 | power
J2 | J3 | power
(new part) | L1 | power
Q1 | Q1 | power
R6 | R5 | power
R7 | R6 | power
R5 | R7 | power
R13 | R8 | power
R14 | R9 | power
R15 | R10 | power
R10 | R11 | power
R12 | R12 | power
(new part) | R13 | power
(new part) | R14 | power
R11 | R15 | power
SW3 | SW3 | power
TP1 | TP1 | power
TP2 | TP2 | power
TP3 | TP3 | power
TP4 | TP4 | power
TP5 | TP5 | power
U4 | U2 | power
(new part) | U3 | power
U5 | U4 | power
J4 | J5 | sd
R33 | R28 | sd
R32 | R29 | sd
R34 | R30 | sd
R35 | R31 | sd
R27 | R32 | sd
R28 | R33 | sd
R29 | R34 | sd
R30 | R35 | sd
R31 | R36 | sd
AE1 | AE1 | sensors
C36 | C25 | sensors
C31 | C26 | sensors
C27 | C27 | sensors
C32 | C28 | sensors
C35 | C29 | sensors
C29 | C30 | sensors
C33 | C31 | sensors
C34 | C32 | sensors
C28 | C33 | sensors
C30 | C34 | sensors
FL1 | FL1 | sensors
R17 | R16 | sensors
R18 | R17 | sensors
R16 | R18 | sensors
U8 | U5 | sensors
U10 | U6 | sensors
U6 | U7 | sensors
U7 | U8 | sensors
U9 | U9 | sensors
J1 | J1 | swd
R4 | R4 | swd
U2 | (deleted) | power: LMR51430 buck
L1 | (deleted) | power: 5.6uH buck inductor
C18 | (deleted) | power: buck CBOOT
C21 | (deleted) | power: buck CIN 10u/50V
C22 | (deleted) | power: buck CIN 100n
C23 | (deleted) | power: buck COUT 100u
R8 | (deleted) | power: buck FB 100k
R9 | (deleted) | power: buck FB 22k1
U3 | (deleted) | power: AMS1117-3.3
C20 | (deleted) | power: AMS1117 22u tantalum
