stanford-ssi/Aerolotl_AV/pre-lora-backup/aerolotl_av_BOM.xlsx

Sheet: BOM
Designators | Qty | Value | Footprint | LCSC Part | MPN | Manufacturer | Voltage | Dielectric | Tolerance | ESR / DCR | Power | JLC library | JLC stock (2026-10-02) | Assembly | Side | Sheet | Notes / datasheet check
AE1 | 1 | GP.1575.18.4.A.02 | ANT_GP.1575.18.4.A.02_TAL | C7281913 | GP.1575.18.4.A.02 | Taoglas |  |  |  |  |  | Extended | 0 | Hand-place (no LCSC stock) | Top | sensors | Taoglas patch has an LCSC number but 0 stock. Order from Digikey/Mouser and hand-place
BZ1 | 1 | HNB09A03 | BUZ-TH_BD9.0-P5.00-D0.6-FD | C96102 | HNB09A03 | Huaneng |  |  |  |  |  | Extended | 44983 | JLC THT | Top | indicators | Active buzzer (internal oscillator): drive it on/off. PWM is only useful for beep patterns
C1, C18, C22 | 3 | 100n | C_0603_1608Metric | C14663 | CC0603KRX7R9BB104 | YAGEO | 50V | X7R | 10% |  |  | Basic | 58141193 | JLC SMT | Top | mcu | LMR51430: 0.1uF HF bypass at VIN, 50V; LMR51430: CBOOT 0.1uF X7R >= 16V
C2 | 1 | 4u7 | C_0805_2012Metric | C98195 | CL21B475KAFNNNE | Samsung Electro-Mechanics | 25V | X7R | 10% |  |  | Extended | 311410 | JLC SMT | Top | mcu | STM32G474 DS12288 Fig.16: VDD n x 100nF + 1 x 4.7uF
C3, C4, C5, C6, C7, C8, C12, C27, C28, C29, C31, C33, C35, C36, C37, C41, C44 | 17 | 100n | C_0402_1005Metric | C1525 | CL05B104KO5NNNC | Samsung Electro-Mechanics | 16V | X7R | 10% |  |  | Basic | 21581667 | JLC SMT | Top | mcu | ADXL345 DS: 0.1uF ceramic at VDD I/O; ADXL375 DS: 0.1uF ceramic at VDD I/O; STM32G474 DS12288 Fig.16: VREF+ 100nF + 1uF
C9 | 1 | 10n | C_0402_1005Metric | C15195 | CL05B103KB5NNNC | Samsung Electro-Mechanics | 50V | X7R | 10% |  |  | Basic | 4033054 | JLC SMT | Top | mcu | STM32G474 DS12288 Fig.16: VDDA = 10nF + 1uF (was 100nF)
C10, C11, C13 | 3 | 1u | C_0603_1608Metric | C29936 | CL10B105KA8NNNC | Samsung Electro-Mechanics | 25V | X7R | 10% |  |  | Extended | 266599 | JLC SMT | Top | mcu | STM32G474 DS12288 Fig.16: VDDA 1uF; STM32G474 DS12288 Fig.16: VREF+ 100nF + 1uF
C14, C15 | 2 | 15p | C_0402_1005Metric | C1548 | 0402CG150J500NT | FH (Guangdong Fenghua) | 50V | C0G | 5% |  |  | Basic | 1431860 | JLC SMT | Top | mcu | HSE load cap, 12pF crystal: 2 x (12pF - ~4.5pF stray) = ~15pF
C16, C17 | 2 | 4.7p | C_0402_1005Metric | C1569 | 0402CG4R7C500NT | FH (Guangdong Fenghua) | 50V | C0G | 0.25pF |  |  | Extended (preferred) | 597482 | JLC SMT | Top | mcu | LSE load cap for 6pF crystal: CL = C/2 + Cs (Cs ~3.5-4pF)
C19 | 1 | 10u | C_0805_2012Metric | C15850 | CL21A106KAYNNNE | Samsung Electro-Mechanics | 25V | X5R | 10% |  |  | Basic | 4951626 | JLC SMT | Top | power | USB 2.0 allows at most 10uF on VBUS at attach (was 22uF)
C20 | 1 | 22u | CP_EIA-3528-21_Kemet-B | C8020 | TAJB226K016RNJ | Kyocera AVX | 16V | Tantalum (MnO2) | 10% | 2.3R @100kHz |  | Extended | 81310 | JLC SMT | Top | power | AMS1117 datasheet: 22uF solid tantalum on output for stability, needs its ESR (was a 22uF MLCC)
C21 | 1 | 10u | C_1206_3216Metric | C89632 | CL31B106KBHNNNE | Samsung Electro-Mechanics | 50V | X7R | 10% |  |  | Extended | 109372 | JLC SMT | Top | power | LMR51430 DS 9.2.2.6: CIN >= 4.7uF X5R/X7R, rated about 2x VIN max (12.6V) -> 50V. 10uF/50V X7R 1206 (was 4u7 0805)
C23, C25 | 2 | 100u | C_1206_3216Metric | C15008 | CL31A107MQHNNNE | Samsung Electro-Mechanics | 6.3V | X5R | 20% |  |  | Basic | 1940643 | JLC SMT | Top | power | LMR51430 Table 9-1 (500kHz, 3.3V) asks for 2x22uF/25V. 100uF/6.3V X5R 1206 derates to ~40-50uF at 3.3V, about the same; TPS2116 DS 7.3.4: about 100uF on VOUT if reverse-current blocking can occur
C24, C26 | 2 | 1u | C_0402_1005Metric | C52923 | CL05A105KA5NQNC | Samsung Electro-Mechanics | 25V | X5R | 10% |  |  | Basic | 5613299 | JLC SMT | Top | power
C30, C34 | 2 | 1u | CP_EIA-2012-12_Kemet-R | C444768 | TAJR105K010RNJ | Kyocera AVX | 10V | Tantalum (MnO2) | 10% | 25R @100kHz |  | Extended | 2570 | JLC SMT | Top | sensors | ADXL345 DS p.28: 1uF tantalum at VS; ADXL375 DS: 1uF tantalum at VS
C32 | 1 | 10u | C_0603_1608Metric | C19702 | CL10A106KP8NNNC | Samsung Electro-Mechanics | 10V | X5R | 10% |  |  | Basic | 10315650 | JLC SMT | Top | sensors
C38 | 1 | 22u | C_0805_2012Metric | C45783 | CL21A226MAQNNNE | Samsung Electro-Mechanics | 25V | X5R | 20% |  |  | Basic | 3990887 | JLC SMT | Top | indicators
C39, C42 | 2 | 150n | C_0603_1608Metric | C513735 | CC0603KRX7R9BB154 | YAGEO | 50V | X7R | 10% |  |  | Extended | 607110 | JLC SMT | Top | igniter | PMOS gate slow-turn-on cap across +12V_ARM: 50V
C40, C43 | 2 | 330u | CP_Elec_8x10 | C970701 | RVT1E331M0810 | DMBJ | 25V | Aluminum electrolytic | 20% | not specified (standard 105C SMD Al-El) |  | Extended | 1527 | JLC SMT | Top | igniter | Igniter reservoir on +12V_ARM (3S, 12.6V max): 25V rating
D1 | 1 | SMBJ15A | SMB_L4.6-W3.6-LS5.3-RD | C83846 | SMBJ15A | Littelfuse |  |  |  |  |  | Extended | 11134 | JLC SMT | Top | power
D2 | 1 | RS-3535MWAR-2JYJY-J | LED-SMD_RS-3535MWAR-2JYJY-J | C110402 | RS-3535MWAR | NATIONSTAR |  |  |  |  |  | Extended | 460049 | JLC SMT | Top | indicators | Check: G/B Vf ~2.8-3.2V on a 3.3V anode leaves <1mA through 330R (dim)
D3 | 1 | STM LED | LED0805-R-RD | C2296 | KT-0805Y | Hubei KENTO |  |  |  |  |  | Basic | 389526 | JLC SMT | Top | indicators
D4 | 1 | 3V3 LED | LED0805-R-RD | C2296 | KT-0805Y | Hubei KENTO |  |  |  |  |  | Basic | 389526 | JLC SMT | Top | indicators
D5 | 1 | USB LED | LED0805-R-RD | C2296 | KT-0805Y | Hubei KENTO |  |  |  |  |  | Basic | 389526 | JLC SMT | Top | indicators
D6 | 1 | ARM LED | LED0805-R-RD | C2296 | KT-0805Y | Hubei KENTO |  |  |  |  |  | Basic | 389526 | JLC SMT | Top | indicators
D7, D10 | 2 | LED red | LED_0603_1608Metric | C2286 | KT-0603R | Hubei KENTO |  |  |  |  |  | Basic | 4815898 | JLC SMT | Top | igniter
D8, D9 | 2 | 1N4148W | D_SOD-123 | C81598 | 1N4148W | ST(Semtech) |  |  |  |  |  | Basic | 5168664 | JLC SMT | Top | igniter
F1, F2 | 2 | 1812L150/24MR | FUSE_1812L150&slash_24_LTF | C142805 | 1812L150/24MR | Littelfuse |  |  |  |  |  | Extended | 14071 | JLC SMT | Top | igniter
FB1 | 1 | 100 | L_0805_2012Metric | C1015 | GZ2012D101TF | Sunlord |  |  |  |  |  | Basic | 2341388 | JLC SMT | Top | mcu
FL1 | 1 | B39162B4300F210 | FILTER-SMD_5P-L1.4-W1.1_RSFPXXXXD | C2650962 | B39162B4300F210 | Qualcomm (RF360) |  |  |  |  |  | Extended | 4559 | JLC SMT | Top | sensors
J1 | 1 | FTSH-107-STDC14 | STDC14_SAMTEC_FTSH-107-01-L-DV-K-A | C5563894 | FTSH-107-01-L-DV-K-A | Samtec |  |  |  |  |  | Extended | 540 | JLC SMT | Top | swd
J2 | 1 | USB_C_Receptacle_USB2.0_16P | USB_C_Receptacle_HRO_TYPE-C-31-M-12 | C165948 | TYPE-C-31-M-12 | Korean Hroparts |  |  |  |  |  | Extended | 426143 | JLC THT | Top | power
J3 | 1 | Battery (ext.) | JST_PH_B2B-PH-K_1x02_P2.00mm_Vertical | C131337 | B2B-PH-K-S(LF)(SN) | JST |  |  |  |  |  | Extended | 63611 | Hand-solder (bottom side) | Bottom | power | External battery input (+BATT / GND) on the bottom side, hand-solder. JST PH is rated 2A per contact
J4 | 1 | TF-102-15_SD_read | TF-SMD_TF-102-15 | C266609 | TF-102-15 | XUNPU |  |  |  |  |  | Extended | 19063 | JLC SMT | Top | sd
J5 | 1 | Conn_01x05_Pin | JST_GH_BM05B-GHS-TBT_1x05-1MP_P1.25mm_Vertical | C189891 | BM05B-GHS-TBT(LF)(SN)(N) | JST |  |  |  |  |  | Extended | 9667 | JLC SMT | Top | external
J6 | 1 | USART3 | JST_GH_BM04B-GHS-TBT_1x04-1MP_P1.25mm_Vertical | C161692 | BM04B-GHS-TBT(LF)(SN) | JST |  |  |  |  |  | Extended | 14065 | JLC SMT | Top | external
J7, J8 | 2 | StemmaQT | StemmaQT | C160390 | BM04B-SRSS-TB(LF)(SN) | JST |  |  |  |  |  | Extended | 52346 | JLC SMT | Top | external
J9 | 1 | Conn_01x04_Pin | JST_GH_BM04B-GHS-TBT_1x04-1MP_P1.25mm_Vertical | C161692 | BM04B-GHS-TBT(LF)(SN) | JST |  |  |  |  |  | Extended | 14065 | JLC SMT | Top | external
J10 | 1 | GPIO_PE2-PE6 | PinHeader_1x07_P2.54mm_Vertical | C492406 | PZ254V-11-07P | XFCN |  |  |  |  |  | Extended | 50677 | JLC THT | Top | external
J11 | 1 | GPIO_PE7-PE11 | PinHeader_1x07_P2.54mm_Vertical | C492406 | PZ254V-11-07P | XFCN |  |  |  |  |  | Extended | 50677 | JLC THT | Top | external
J12 | 1 | LPUART1 | JST_GH_BM04B-GHS-TBT_1x04-1MP_P1.25mm_Vertical | C161692 | BM04B-GHS-TBT(LF)(SN) | JST |  |  |  |  |  | Extended | 14065 | JLC SMT | Top | external
J14 | 1 | Screw_Terminal_01x02 | TerminalBlock_Kangnex_WJ2EDGVM-5.08-02P_1x02_P5.08mm_Vertical | C193973 | WJ2EDGVM-5.08-02P-14-00A | KANGNEX |  |  |  |  |  | Extended | 1218 | Hand-solder (bottom side) | Bottom | igniter | DROGUE (CH0) on the bottom side, hand-solder. Vertical pluggable header + screw plug C63303; Also: WJ2EDGKM-5.08-02P-14-00A (LCSC C63303)
J15 | 1 | Screw_Terminal_01x02 | TerminalBlock_Kangnex_WJ2EDGVM-5.08-02P_1x02_P5.08mm_Vertical | C193973 | WJ2EDGVM-5.08-02P-14-00A | KANGNEX |  |  |  |  |  | Extended | 1218 | JLC THT | Top | igniter | MAIN (CH1) on the top side. Vertical pluggable header + screw plug C63303; Also: WJ2EDGKM-5.08-02P-14-00A (LCSC C63303)
L1 | 1 | 5.6u | L_Cjiang_FXL0630_7.0x6.6mm | C475914 | FXL0630-5R6-M | cjiang (Changjiang Microelectronics) |  |  | 20% | 42mR max |  | Extended | 12392 | JLC SMT | Top | power | LMR51430 Table 9-1: 5.6uH at 500kHz/3.3V. Isat must exceed the HS current limit (4.76A typ) -> FXL0630 (was 4.7uH 4030, Isat ~2A)
Q1 | 1 | AO4407A | SOIC-8_L4.9-W3.9-P1.27-LS6.0-BL | C16072 | AO4407A | AOS |  |  |  |  |  | Extended | 23546 | JLC SMT | Top | power
Q2, Q4, Q6 | 3 | AO3400A | SOT-23 | C20917 | AO3400A | AOS |  |  |  |  |  | Basic | 958459 | JLC SMT | Top | indicators
Q3, Q5 | 2 | FDS6673BZ_C467780 | SOIC-8_L4.9-W3.9-P1.27-LS6.0-BL | C467780 | FDS6673BZ | onsemi |  |  |  |  |  | Extended | 2359 | JLC SMT | Top | igniter
R1, R2 | 2 | 10k | R_0603_1608Metric | C25804 | 0603WAF1002T5E | UNI-ROYAL | 75V |  | 1% |  | 100mW | Basic | 23037967 | JLC SMT | Top | mcu
R3 | 1 | 47 | R_0402_1005Metric | C25118 | 0402WGF470JTCE | UNI-ROYAL | 50V |  | 1% |  | 62.5mW | Extended (preferred) | 391677 | JLC SMT | Top | mcu
R4, R38, R46 | 3 | 100 | R_0402_1005Metric | C25076 | 0402WGF1000TCE | UNI-ROYAL | 50V |  | 1% |  | 62.5mW | Basic | 4080693 | JLC SMT | Top | swd
R5 | 1 | 0R | R_0603_1608Metric | C21189 | 0603WAF0000T5E | UNI-ROYAL | 75V |  | 1% |  | 100mW | Basic | 23746831 | JLC SMT | Top | power
R6, R7 | 2 | 5k1 | R_0402_1005Metric | C25905 | 0402WGF5101TCE | UNI-ROYAL | 50V |  | 1% |  | 62.5mW | Basic | 6009635 | JLC SMT | Top | power
R8, R13 | 2 | 100k | R_0402_1005Metric | C25741 | 0402WGF1003TCE | UNI-ROYAL | 50V |  | 1% |  | 62.5mW | Basic | 8233229 | JLC SMT | Top | power | LMR51430 FB top 100k (Vout = 0.6 x (1 + 100/22.1) = 3.315V)
R9 | 1 | 22k1 | R_0402_1005Metric | C43473 | 0402WGF2212TCE | UNI-ROYAL | 50V |  | 1% |  | 62.5mW | Extended | 105905 | JLC SMT | Top | power | LMR51430 FB bottom 22.1k
R10 | 1 | 9k53 | R_0402_1005Metric | C96273 | 0402WGF9531TCE | UNI-ROYAL | 50V |  | 1% |  | 62.5mW | Extended | 8817 | JLC SMT | Top | power
R11, R14, R27, R28, R29, R30, R31, R41, R44, R47, R49 | 11 | 10k | R_0402_1005Metric | C25744 | 0402WGF1002TCE | UNI-ROYAL | 50V |  | 1% |  | 62.5mW | Basic | 21738660 | JLC SMT | Top | power
R12 | 1 | 4k99 | R_0402_1005Metric | C25903 | 0402WGF4991TCE | UNI-ROYAL | 50V |  | 1% |  | 62.5mW | Extended | 168245 | JLC SMT | Top | power | 5k is not a standard value. 4.99k (E96) gives PR1 = 1.134V (was 1.136V)
R15, R26 | 2 | 3k3 | R_0402_1005Metric | C25890 | 0402WGF3301TCE | UNI-ROYAL | 50V |  | 1% |  | 62.5mW | Basic | 2084377 | JLC SMT | Top | power
R16, R17, R18, R32, R33, R34, R35 | 7 | 10 | R_0402_1005Metric | C25077 | 0402WGF100JTCE | UNI-ROYAL | 50V |  | 1% |  | 62.5mW | Basic | 1753546 | JLC SMT | Top | sensors
R19, R20, R21, R40, R51 | 5 | 330 | R_0402_1005Metric | C25104 | 0402WGF3300TCE | UNI-ROYAL | 50V |  | 1% |  | 62.5mW | Basic | 1195841 | JLC SMT | Top | indicators
R22, R23 | 2 | 470 | R_0402_1005Metric | C25117 | 0402WGF4700TCE | UNI-ROYAL | 50V |  | 1% |  | 62.5mW | Basic | 840845 | JLC SMT | Top | indicators
R24 | 1 | 910 | R_0402_1005Metric | C44933 | 0402WGF9100TCE | UNI-ROYAL | 50V |  | 1% |  | 62.5mW | Extended | 60782 | JLC SMT | Top | indicators
R25, R36, R43 | 3 | 3k3 | R_0603_1608Metric | C22978 | 0603WAF3301T5E | UNI-ROYAL | 75V |  | 1% |  | 100mW | Basic | 5690986 | JLC SMT | Top | indicators | ARM LED from +12V_ARM: ~3.2mA, 34mW -> 0603; Bleeder 12.6V^2/3.3k = 48mW -> 0603 100mW
R37, R45 | 2 | 1k | R_1206_3216Metric | C4410 | 1206W4F1001T5E | UNI-ROYAL | 200V |  | 1% |  | 250mW | Basic | 2447130 | JLC SMT | Top | igniter | P = 0.13W while firing (12.6V / 1.1k) -> 1206 0.25W
R39, R50 | 2 | 8k2 | R_0402_1005Metric | C25924 | 0402WGF8201TCE | UNI-ROYAL | 50V |  | 1% |  | 62.5mW | Extended (preferred) | 54795 | JLC SMT | Top | igniter
R42, R48 | 2 | 33k | R_0402_1005Metric | C25779 | 0402WGF3302TCE | UNI-ROYAL | 50V |  | 1% |  | 62.5mW | Basic | 1209063 | JLC SMT | Top | igniter
SW1 | 1 | SW_SPST | SW_SPST_TL3342 | C2886898 | TL3342F160QG | E-Switch |  |  |  |  |  | Extended | 1892 | JLC SMT | Top | mcu
SW2 | 1 | SW_Push | SW_SPST_TL3342 | C2886898 | TL3342F160QG | E-Switch |  |  |  |  |  | Extended | 1892 | JLC SMT | Top | mcu
SW3 | 1 | SW_SPST | JST_XH_B2B-XH-A_1x02_P2.50mm_Vertical | C158012 | B2B-XH-A(LF)(SN) | JST |  |  |  |  |  | Extended | 305696 | JLC THT | Top | power
U1 | 1 | STM32G474VETx | LQFP-100_14x14mm_P0.5mm | C431632 | STM32G474VET6 | STMicroelectronics |  |  |  |  |  | Extended | 39 | JLC SMT | Top | mcu | Low stock (9 at LCSC / 39 at JLC). Reserve parts before ordering
U2 | 1 | LMR51430XFDDCR | TSOT-23-6 | C5219260 | LMR51430XFDDCR | Texas Instruments |  |  |  |  |  | Extended | 1457 | JLC SMT | Top | power
U3 | 1 | AMS1117-3.3 | SOT-223-3_TabPin2 | C6186 | AMS1117-3.3 | Advanced Monolithic Systems |  |  |  |  |  | Basic | 1069998 | JLC SMT | Top | power
U4 | 1 | USBLC6-2P6 | SOT-666 | C15999 | USBLC6-2P6 | STMicroelectronics |  |  |  |  |  | Extended | 2734 | JLC SMT | Top | power
U5 | 1 | TPS2116DRL | SOT-583-8 | C3235557 | TPS2116DRLR | Texas Instruments |  |  |  |  |  | Extended | 79374 | JLC SMT | Top | power
U6 | 1 | BMI088 | Bosch_LGA-16_4.5x3mm_P0.5mm_LayoutBorder7x1y_ClockwisePinNumbering | C194919 | BMI088 | Bosch Sensortec |  |  |  |  |  | Extended | 4466 | JLC SMT | Top | sensors
U7 | 1 | ADXL345BCCZ-RL7 | ADI_LGA-14_3x5mm_P0.8mm | C9667 | ADXL345BCCZ-RL7 | Analog Devices |  |  |  |  |  | Extended | 10579 | JLC SMT | Top | sensors
U8 | 1 | MAX-M10S | ublox_MAX | C4153167 | MAX-M10S-00B | u-blox |  |  |  |  |  | Extended | 661 | JLC SMT | Top | sensors
U9 | 1 | ADXL375BCCZ-RL7 | ADI_LGA-14_3x5mm_P0.8mm | C481898 | ADXL375BCCZ-RL7 | Analog Devices |  |  |  |  |  | Extended | 74 | JLC SMT | Top | sensors | Low stock (74 at JLC)
U10 | 1 | BMP581 | LGA-10_L2.0-W2.0-P0.50-TL_BMP581 | C5362283 | BMP581 | Bosch Sensortec |  |  |  |  |  | Extended | 3323 | JLC SMT | Top | sensors
U11 | 1 | Airlift | Ada_Airlift | C2897375 | PM254-1-12-Z-8.5 | HCTL |  |  |  |  |  | Extended | 9922 | Optional (not in JLC BOM) | Top | airlift | The board-side part is the 1x12 female socket. The Airlift module (Adafruit 4201) plugs in; Also: Adafruit AirLift ESP32 breakout PID 4201 (plugs in, not from LCSC)
Y1 | 1 | 25MHz | CRYSTAL-SMD_4P-L3.2-W2.5-BL | C9006 | X322525MOB4SI | YXC |  |  |  |  |  | Basic | 198173 | JLC SMT | Top | mcu | 25MHz 12pF crystal
Y2 | 1 | 32.768kHz | Crystal_SMD_3215-2Pin_3.2x1.5mm | C20340322 | FC-135 32.7680KA-E | Seiko Epson |  |  |  |  |  | Extended | 4075 | JLC SMT | Top | mcu | 6pF / 70k ESR crystal: gm_crit ~0.6uA/V. Use LSEDRV = medium-high (1.7uA/V max) for >2x margin
Total placements | 148
BOM lines missing an LCSC number | 0
Not in BOM (no part to buy): TP1-TP10 plated-hole test points, H1/H2 (3/8in rod holes), H3 (TeleMetrum sled holes).

Sheet: JLC_BOM
Comment | Designator | Footprint | LCSC Part #
HNB09A03 | BZ1 | BUZ-TH_BD9.0-P5.00-D0.6-FD | C96102
CC0603KRX7R9BB104 | C1,C18,C22 | C_0603_1608Metric | C14663
CL21B475KAFNNNE | C2 | C_0805_2012Metric | C98195
CL05B104KO5NNNC | C3,C4,C5,C6,C7,C8,C12,C27,C28,C29,C31,C33,C35,C36,C37,C41,C44 | C_0402_1005Metric | C1525
CL05B103KB5NNNC | C9 | C_0402_1005Metric | C15195
CL10B105KA8NNNC | C10,C11,C13 | C_0603_1608Metric | C29936
0402CG150J500NT | C14,C15 | C_0402_1005Metric | C1548
0402CG4R7C500NT | C16,C17 | C_0402_1005Metric | C1569
CL21A106KAYNNNE | C19 | C_0805_2012Metric | C15850
TAJB226K016RNJ | C20 | CP_EIA-3528-21_Kemet-B | C8020
CL31B106KBHNNNE | C21 | C_1206_3216Metric | C89632
CL31A107MQHNNNE | C23,C25 | C_1206_3216Metric | C15008
CL05A105KA5NQNC | C24,C26 | C_0402_1005Metric | C52923
TAJR105K010RNJ | C30,C34 | CP_EIA-2012-12_Kemet-R | C444768
CL10A106KP8NNNC | C32 | C_0603_1608Metric | C19702
CL21A226MAQNNNE | C38 | C_0805_2012Metric | C45783
CC0603KRX7R9BB154 | C39,C42 | C_0603_1608Metric | C513735
RVT1E331M0810 | C40,C43 | CP_Elec_8x10 | C970701
SMBJ15A | D1 | SMB_L4.6-W3.6-LS5.3-RD | C83846
RS-3535MWAR | D2 | LED-SMD_RS-3535MWAR-2JYJY-J | C110402
KT-0805Y | D3,D4,D5,D6 | LED0805-R-RD | C2296
KT-0603R | D7,D10 | LED_0603_1608Metric | C2286
1N4148W | D8,D9 | D_SOD-123 | C81598
1812L150/24MR | F1,F2 | FUSE_1812L150&slash_24_LTF | C142805
GZ2012D101TF | FB1 | L_0805_2012Metric | C1015
B39162B4300F210 | FL1 | FILTER-SMD_5P-L1.4-W1.1_RSFPXXXXD | C2650962
FTSH-107-01-L-DV-K-A | J1 | STDC14_SAMTEC_FTSH-107-01-L-DV-K-A | C5563894
TYPE-C-31-M-12 | J2 | USB_C_Receptacle_HRO_TYPE-C-31-M-12 | C165948
TF-102-15 | J4 | TF-SMD_TF-102-15 | C266609
BM05B-GHS-TBT(LF)(SN)(N) | J5 | JST_GH_BM05B-GHS-TBT_1x05-1MP_P1.25mm_Vertical | C189891
BM04B-GHS-TBT(LF)(SN) | J6,J9,J12 | JST_GH_BM04B-GHS-TBT_1x04-1MP_P1.25mm_Vertical | C161692
BM04B-SRSS-TB(LF)(SN) | J7,J8 | StemmaQT | C160390
PZ254V-11-07P | J10,J11 | PinHeader_1x07_P2.54mm_Vertical | C492406
WJ2EDGVM-5.08-02P-14-00A | J15 | TerminalBlock_Kangnex_WJ2EDGVM-5.08-02P_1x02_P5.08mm_Vertical | C193973
FXL0630-5R6-M | L1 | L_Cjiang_FXL0630_7.0x6.6mm | C475914
AO4407A | Q1 | SOIC-8_L4.9-W3.9-P1.27-LS6.0-BL | C16072
AO3400A | Q2,Q4,Q6 | SOT-23 | C20917
FDS6673BZ | Q3,Q5 | SOIC-8_L4.9-W3.9-P1.27-LS6.0-BL | C467780
0603WAF1002T5E | R1,R2 | R_0603_1608Metric | C25804
0402WGF470JTCE | R3 | R_0402_1005Metric | C25118
0402WGF1000TCE | R4,R38,R46 | R_0402_1005Metric | C25076
0603WAF0000T5E | R5 | R_0603_1608Metric | C21189
0402WGF5101TCE | R6,R7 | R_0402_1005Metric | C25905
0402WGF1003TCE | R8,R13 | R_0402_1005Metric | C25741
0402WGF2212TCE | R9 | R_0402_1005Metric | C43473
0402WGF9531TCE | R10 | R_0402_1005Metric | C96273
0402WGF1002TCE | R11,R14,R27,R28,R29,R30,R31,R41,R44,R47,R49 | R_0402_1005Metric | C25744
0402WGF4991TCE | R12 | R_0402_1005Metric | C25903
0402WGF3301TCE | R15,R26 | R_0402_1005Metric | C25890
0402WGF100JTCE | R16,R17,R18,R32,R33,R34,R35 | R_0402_1005Metric | C25077
0402WGF3300TCE | R19,R20,R21,R40,R51 | R_0402_1005Metric | C25104
0402WGF4700TCE | R22,R23 | R_0402_1005Metric | C25117
0402WGF9100TCE | R24 | R_0402_1005Metric | C44933
0603WAF3301T5E | R25,R36,R43 | R_0603_1608Metric | C22978
1206W4F1001T5E | R37,R45 | R_1206_3216Metric | C4410
0402WGF8201TCE | R39,R50 | R_0402_1005Metric | C25924
0402WGF3302TCE | R42,R48 | R_0402_1005Metric | C25779
TL3342F160QG | SW1,SW2 | SW_SPST_TL3342 | C2886898
B2B-XH-A(LF)(SN) | SW3 | JST_XH_B2B-XH-A_1x02_P2.50mm_Vertical | C158012
STM32G474VET6 | U1 | LQFP-100_14x14mm_P0.5mm | C431632
LMR51430XFDDCR | U2 | TSOT-23-6 | C5219260
AMS1117-3.3 | U3 | SOT-223-3_TabPin2 | C6186
USBLC6-2P6 | U4 | SOT-666 | C15999
TPS2116DRLR | U5 | SOT-583-8 | C3235557
BMI088 | U6 | Bosch_LGA-16_4.5x3mm_P0.5mm_LayoutBorder7x1y_ClockwisePinNumbering | C194919
ADXL345BCCZ-RL7 | U7 | ADI_LGA-14_3x5mm_P0.8mm | C9667
MAX-M10S-00B | U8 | ublox_MAX | C4153167
ADXL375BCCZ-RL7 | U9 | ADI_LGA-14_3x5mm_P0.8mm | C481898
BMP581 | U10 | LGA-10_L2.0-W2.0-P0.50-TL_BMP581 | C5362283
X322525MOB4SI | Y1 | CRYSTAL-SMD_4P-L3.2-W2.5-BL | C9006
FC-135 32.7680KA-E | Y2 | Crystal_SMD_3215-2Pin_3.2x1.5mm | C20340322

Sheet: Hand assembly & loose
Item | Designator | LCSC Part | MPN | Qty | Why / how
Drogue terminal header (bottom side) | J14 | C193973 | WJ2EDGVM-5.08-02P-14-00A | 1 | THT on B.Cu. JLC will not assemble the second side, so hand-solder.
Battery connector (bottom side) | J3 | C131337 | B2B-PH-K-S(LF)(SN) | 1 | JST PH 2-pin, THT on B.Cu, hand-solder. Pin 1 = +BATT, pin 2 = GND.
Terminal plugs (screw, flange-locked, top wire entry) | mates J14, J15 | C63303 | WJ2EDGKM-5.08-02P-14-00A | 2 | Loose parts, not placed. The flange screws lock the plug to the header.
Battery cable housing | mates J3 |  | PHR-2 + SPH-002T-P0.5S | 1 | Make the harness to the CamControl battery board.
GPS patch antenna | AE1 | C7281913 | GP.1575.18.4.A.02 | 1 | LCSC/JLC stock is 0: buy from Digikey/Mouser, hand-place.
Adafruit AirLift breakout | U11 | C2897375 (socket) | Adafruit PID 4201 + PM254-1-12-Z-8.5 | 1 | Optional (U11 is in_bom=no). Socket is THT, can go in JLC THT if wanted.
M4 screws, washers, nuts for TeleMetrum sled | H3 |  | M4x0.7 SHCS x10/x12 (Onshape BOM) | 2 | Through H3 into the sled nut traps.
3/8-16 threaded rod hardware | H1, H2 |  | Hex nut 3/8-16 + 3/8 washers | 4 | Clamp the board on the rods. 9.6mm keepout ring on both sides.

Sheet: Changes
Area | Change | Reason / source
Board outline | Outline changed from a 152.4mm circle to the lower (CamControl) PCB outline from Onshape: 145.29mm dia, a 40mm-wide TeleMetrum notch at the bottom (inner edge 14mm in), and two 10mm x 6mm radial wire slots at 130 and 33 deg. | Onshape AV Bay - Parametric, CamControl battery PCB top face. The coupler inner disc is 147.3mm, so the old 152.4mm board would not fit. Removed the "add cutouts" text from Edge.Cuts.
Threaded rods | H1/H2 moved to exactly (center +/-60mm, center), symmetric on the horizontal center line. Hole is 10.32mm NPTH, with a 9.6mm-radius courtyard and copper keepout on both sides for the washer and nut. | Onshape rod holes r=5.159 at x=+/-60. Old holes were M6 (6.4mm), too small for 3/8" rod, and off-center (65.8 / 65.45mm, y +0.25).
TeleMetrum | Added H3: 2x 4.5mm M4 holes 17.4mm apart, 50mm below center. M4 washer keepout on top, sled-body keepout on the bottom. | Onshape TeleMetrum sled (3D print) bolt holes r=2.25 at (+/-8.7, -50). The sled stands between this board and the lower PCB.
J10 / J11 | JST GH 7-pin replaced by 2.54mm 1x7 pin headers (PZ254V-11-07P). Moved to the left side next to the other external connectors. GPIO names added on silkscreen. | Request. The MPN field said SM07B (horizontal) while the footprint was BM07B (vertical), which was also inconsistent.
U11 Airlift | New Ada_Airlift footprint built from the Adafruit Eagle board: 1x12 header with correct pin order, 31.75x33.02mm outline, two M2.5 holes, and a copper keepout under the ESP32 antenna. Placed on the right side, clear of the rod. Updated in both aerolotl_av and aerolotl libraries. | github.com/adafruit/Adafruit-AirLift-Breakout-PCB. The old footprint had no pads, and the board used a plain 1x12 socket.
Igniter terminals | J15 MAIN (top) and J14 DROGUE (bottom) are now vertical pluggable headers (Kangnex WJ2EDGVM-5.08, screw-flange) with WJ2EDGKM screw plugs, so the wires leave perpendicular to the board. J14 sits next to slot A so drogue wires drop through the lower PCB slot. | Request: main routes upward, drogue underneath and hand-soldered. JLC has no stock of a one-piece vertical screw terminal.
Battery | BT1-BT3 18650 holders removed. J3 (was XT30 pin-switch) is now the external battery input: JST PH 2-pin on the bottom (+BATT / GND). Removed the leftover VBAT_PACK label that tied J3 pin 2 to GND. | Request: batteries are external. Matches your edit that rewired J3 to +BATT/GND.
Re-placement | Moved edge connectors 3.6mm in (J2, J4, J5, J6, J9, J12) and AE1 2.6mm in, both igniter channels up and outward away from the sled washers and notch, indicators and the buzzer into the free right-middle area, SW3, TP3 and TP6, plus small nudges to clear new courtyards. The buck inductor moved for the larger part. | The new outline, holes and keepouts. The board is unrouted, so nothing was ripped up. Review the placement.
MCU | Every used U1 pin now shows its function (KiCad pin alternates: USART2_TX, SPI1_SCK, ADC1_IN1 and so on). Added GPIO_Output, GPIO_Input and GPIO_EXTIx alternates for plain-GPIO pins to the symbol, both embedded and in the library. | Request. All 42 AF functions in AV_PINMAP.md exist as G474 alternates, which confirms the pin map.
C9 | 100nF -> 10nF (VDDA HF cap) | STM32G474 DS12288 Fig.16: VDDA 10nF + 1uF
Y2, C16, C17 | LSE crystal Epson FC-135 32.7680KA-E (6pF, 70k). Load caps 15pF -> 4.7pF C0G. | 15pF caps on a 6-12.5pF crystal pull the frequency. A 6pF crystal keeps gm_crit at about 0.6uA/V, under the 1.7uA/V of LSEDRV medium-high.
C19 | 22uF -> 10uF on VBUS | USB 2.0 limits capacitance on VBUS at attach to 10uF
C20 | 22uF MLCC -> 22uF/16V tantalum (2.3R ESR), case B | AMS1117 datasheet: 22uF solid tantalum on the output for stability. A low-ESR MLCC alone can oscillate.
C21 | 4.7uF 0805 -> 10uF/50V X7R 1206 | LMR51430 DS 9.2.2.6: CIN >= 4.7uF, rated about 2x VIN max (12.6V)
L1 | 4.7uH 4030 (Isat ~2A) -> 5.6uH FXL0630 (Isat 5.5A, 42mR) | LMR51430 Table 9-1 (500kHz, 3.3V) calls for 5.6uH, and Isat must exceed the 4.76A typ HS current limit
C30, C34 | 1uF 0402 MLCC -> 1uF/10V tantalum (case R) | ADXL345 / ADXL375 datasheets: 1uF tantalum at VS, 0.1uF ceramic at VDD I/O
U7, U9 | Both now use ADI_LGA-14_3x5mm_P0.8mm (ADI recommended land pattern). Pin orientation is preserved. | ADXL345 DS Fig.59. The two old footprints for the same package disagreed, and the ADXL375 one had 1.77mm hand-solder pads.
U2 | Footprint SOT-23-6 -> TSOT-23-6 | LMR51430XFDDCR is the DDC (thin SOT) package. The pads are identical.
R12 | 5k -> 4.99k | 5k is not a stocked 1% value. PR1 threshold 1.134V vs 1.136V.
AE1 | Footprint field had no library nickname (it would fail to resolve) | Fixed to aerolotl_custom:ANT_GP.1575.18.4.A.02_TAL
Test points | TP1-TP10 excluded from BOM | Plated holes with no part to buy
All parts | LCSC Part, MPN, Manufacturer, Voltage, Dielectric, Tolerance, ESR/DCR and Power fields filled on every symbol (and mirrored into the PCB). The duplicate "LCSC" field was merged into "LCSC Part". | LCSC/JLC part data checked 2026-10-02
D9 | Removed an orphan duplicate D9 footprint (no schematic link). The linked D9 now sits in its place. | PCB vs schematic sync

Sheet: Open items
# | Item | Suggested action
1 | Open KiCad and run Tools > Update PCB from Schematic (F8), then ERC and DRC. I could not run KiCad from here. My own netlist check matches every pad net to the schematic. | Expect only field/value updates. Re-pour zones. The inner-layer +12V/+3V3 split on In2 was drawn for the old layout, so redraw it.
2 | RGB LED D2: the green/blue Vf (about 2.8-3.2V) is too close to the 3.3V anode, so G/B will be very dim or off with 330R. | Run the anode from +5V/USB or a higher rail, or drop G/B to about 47-68R. Check the RS-3535MWAR datasheet Vf.
3 | BZ1 HNB09A03 is an active buzzer (it has its own oscillator). The MCU net is BUZZER_PWM on TIM1_CH1. | Drive it as on/off. If you want tone control, swap to a passive/magnetic transducer and add a flyback diode.
4 | JST PH (J3) is rated 2A per contact. The igniter pulses come from +BATT through this connector. | Fine for e-matches with the 330uF reservoirs. Use JST XH/XT30 if you add higher-current loads.
5 | U1 STM32G474VET6 stock is very low (9 at LCSC, 39 at JLC). ADXL375 has 74 at JLC. | Pre-order/reserve on JLC before submitting.
6 | AE1 Taoglas GP.1575.18.4.A.02 has 0 stock at LCSC/JLC. | Buy from Digikey/Mouser, or pick an in-stock 18x18 patch with the same feed position.
7 | Placement was re-done around the new outline and keepouts with a scripted legalizer, so it is overlap-free but not optimized. | Review the bottom half (igniter channels) and the GPS/Airlift antenna clearances before routing.
8 | Standard-library footprints I added (PinHeader_1x07, JST_PH_B2B, CP_EIA tantalum, TSOT-23-6) were generated from an older copy of the KiCad library. | In KiCad: Tools > Update Footprints from Library on those refs to pull the current KiCad 10 versions.
