stanford-ssi/Aerolotl_AV/aerolotl_av.step

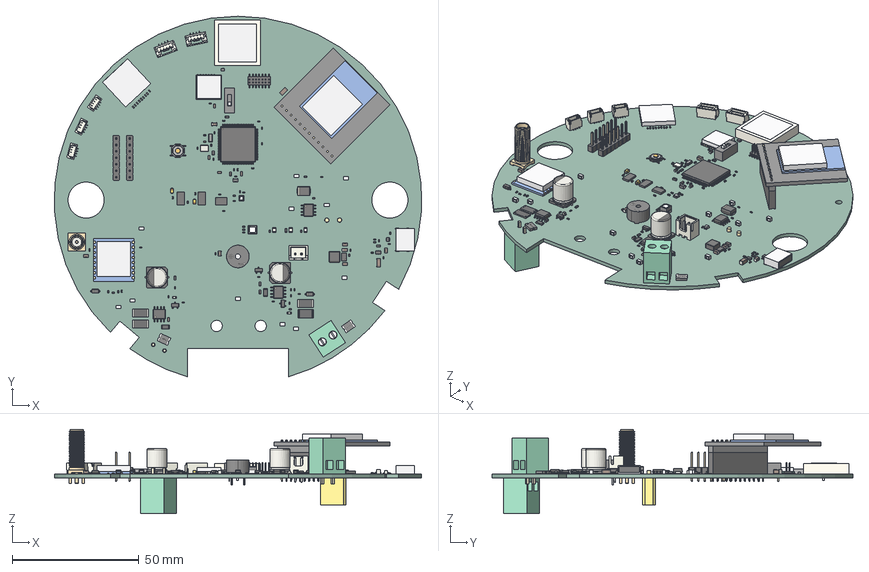
[picture p3: CAD file, 2026-10-09]
aerolotl_av.step
145.0 x 142.5 x 33.4 mm
C_0805_2012Metric x 7
R_0603_1608Metric x 6
C_0402_1005Metric x 25
F1812_L4.5-W3.2-H1.0 x 2
C_0603_1608Metric x 7
JST_SH_BM04B-SRSS-TB_1x04-1MP_P1.00mm_Vertical x 3
MAX-M10S_green
MAX-M10S_silver
MAX-M10S_gold
L_0805_2012Metric
R_0402_1005Metric x 43
SOT-23 x 3
KOA_RCTCTE_2.0x1.25x1.45mm_0_part x 11
USB-C_silver
USB-C_dark
USB-C_black
D_SOD-123 x 2
LED-SMD_L3.7-W3.5-H2.8
LED_0805_2012Metric x 3
housing_part x 2
screws_part x 2
pins_part x 2
SOT-583-8
FILTER-SMD_5P-L1.4-W1.1_RSFPXXXXD
GP1575_ceramic
GP1575_silver
DFN-10-1EP_2x3mm_Pitch0.5mm
Kingtek_DSWB01LHGET_0_part
Kingtek_DSWB01LHGET_1_part
Kingtek_DSWB01LHGET_2_part
R_1206_3216Metric x 2
R_2512_6332Metric x 4
SOIC-8_3.9x4.9mm_P1.27mm x 3
SMA_Amphenol_132291_Vertical
LGA_14_3x5mm_P08mm_LayoutBorder1x6y x 2
PinHeader_2x07_P127mm_Vertical_SMD
D_SMB
SOT_666
JST_B2B_XH_A
BMP581
LED_0603_1608Metric x 2
Crystal_SMD_3215-2Pin_3.2x1.5mm
BUZ-TH_D9.0-H5.5-P5.0
LQFP-100_14x14mm_P0.5mm
C_1206_3216Metric x 2
CP_Elec_8x10 x 2
Ra-01H_blue
Ra-01H_silver
Ra-01H_gold
JST_BM04B_GHS_TBT x 2
L_Coilcraft_XAL4020-XXX
Bosch_LGA-16_4.5x3mm_P0.5mm_LayoutBorder7x1y_ClockwisePinNumbering
Crystal_SMD_3225-4Pin_3.2x2.5mm
PinSocket_1x12_P2.54mm_Vertical
AirLift_black
AirLift_blue
AirLift_silver
AirLift_gold
PinHeader_1x07_P254mm_Vertical x 2
CP_EIA_2012_12_Kemet_R x 2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
