stanford-ssi/Aerolotl_AV/Heyco_G1123_grommet.step

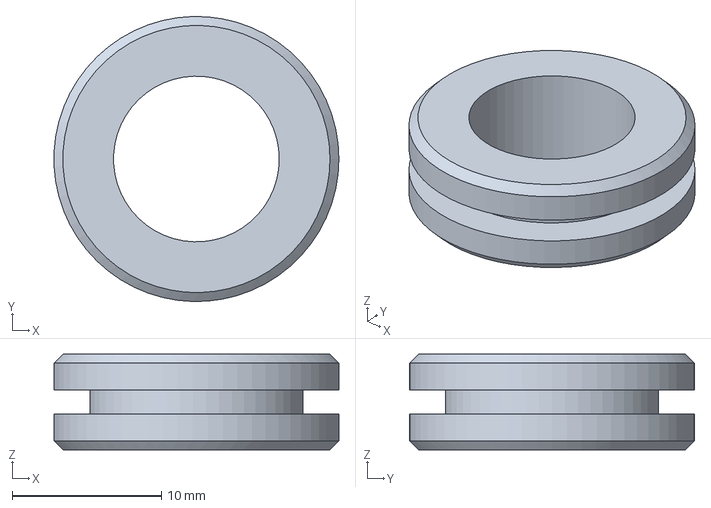
[picture p4: CAD file, 2026-10-09]
Heyco_G1123_grommet.step
19.1 x 19.1 x 6.40 mm
