stanford-ssi/Aerolotl_AV/pre-silk-backup/aerolotl_av.kicad_pcb

## KiCad design pre-silk-backup/aerolotl_av.kicad_pcb (2026-10-09)

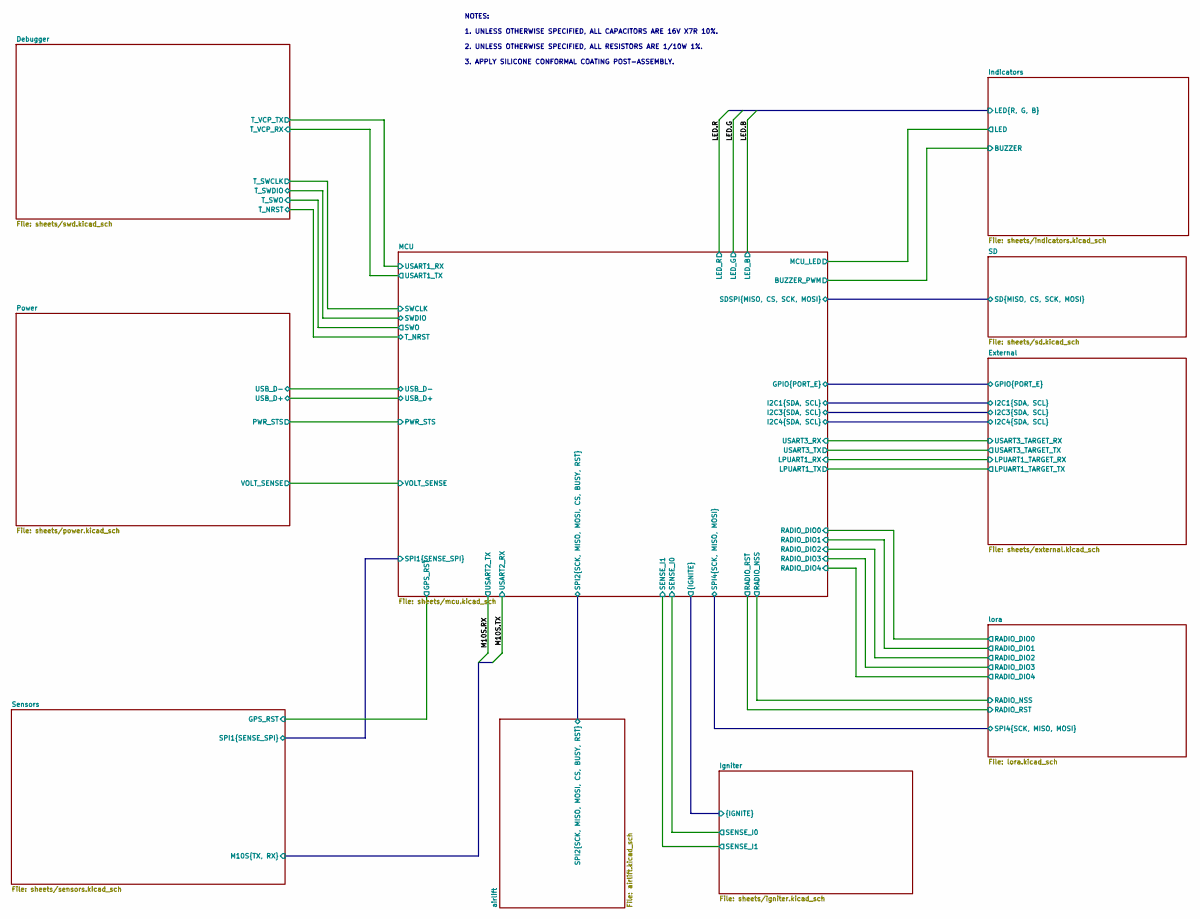
[picture p5: schematic aerolotl_av.kicad_sch, AEROLOTL AVIONICS FLIGHT COMPUTER]

Notes on the sheet:
NOTES: 1. UNLESS OTHERWISE SPECIFIED, ALL CAPACITORS ARE 16V X7R 10%. 2. UNLESS OTHERWISE SPECIFIED, ALL RESISTORS ARE 1/10W 1%. 3. APPLY SILICONE CONFORMAL COATING POST-ASSEMBLY.

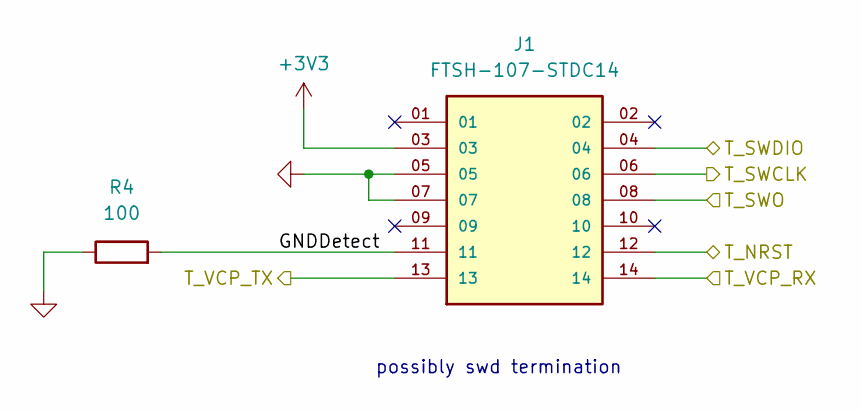
[picture p6: schematic swd.kicad_sch]

Parts:
J1: FTSH-107-STDC14; STDC14_SAMTEC_FTSH-107-01-L-DV-K-A; PARTREV H; LCSC Part C5563894
R4: 100; R_0402_1005Metric; Tolerance 1%; Voltage 50V; MPN 0402WGF1000TCE; LCSC Part C25076

Connections:
+3V3: J1.03; also elsewhere on the board
/Debugger/GNDDetect: J1.11, R4.2
/Debugger/T_NRST: J1.12; also elsewhere on the board
/Debugger/T_SWCLK: J1.06; also elsewhere on the board
/Debugger/T_SWDIO: J1.04; also elsewhere on the board
/Debugger/T_SWO: J1.08; also elsewhere on the board
/Debugger/T_VCP_RX: J1.14; also elsewhere on the board
/Debugger/T_VCP_TX: J1.13; also elsewhere on the board
GND: J1.05, J1.07, R4.1; also elsewhere on the board

Notes on the sheet:
possibly swd termination

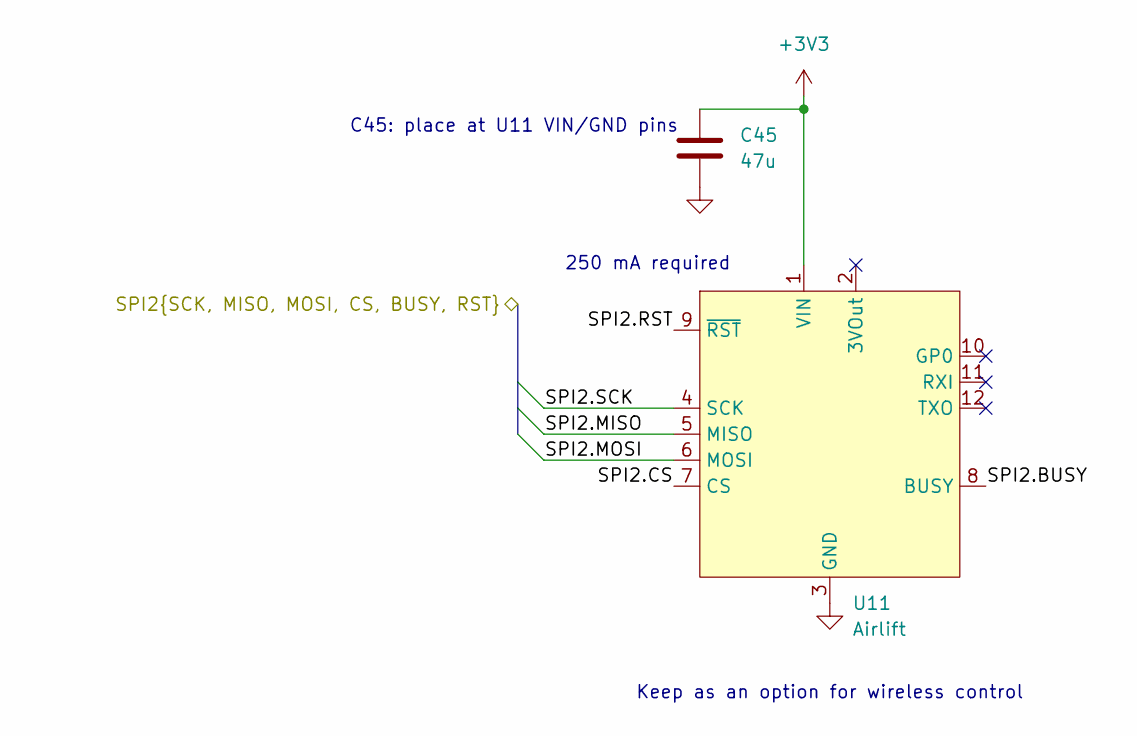
[picture p7: schematic airlift.kicad_sch]

Parts:
C45: 47u; C_1206_3216Metric; Voltage 10V; Tolerance 20%; MPN CL31A476MPHNNNE; LCSC Part C96123
U11: Airlift; Ada_Airlift; MPN PM254-1-12-Z-8.5; LCSC Part C2897375

Connections:
+3V3: C45.1, U11.1 (VIN); also elsewhere on the board
/MCU/SPI2.BUSY: U11.8 (BUSY); also elsewhere on the board
/MCU/SPI2.CS: U11.7 (CS); also elsewhere on the board
/MCU/SPI2.MISO: U11.5 (MISO); also elsewhere on the board
/MCU/SPI2.MOSI: U11.6 (MOSI); also elsewhere on the board
/MCU/SPI2.RST: U11.9 (~RST); also elsewhere on the board
/MCU/SPI2.SCK: U11.4 (SCK); also elsewhere on the board
GND: C45.2, U11.3 (GND); also elsewhere on the board

Notes on the sheet:
250 mA required
Keep as an option for wireless control
C45: place at U11 VIN/GND pins

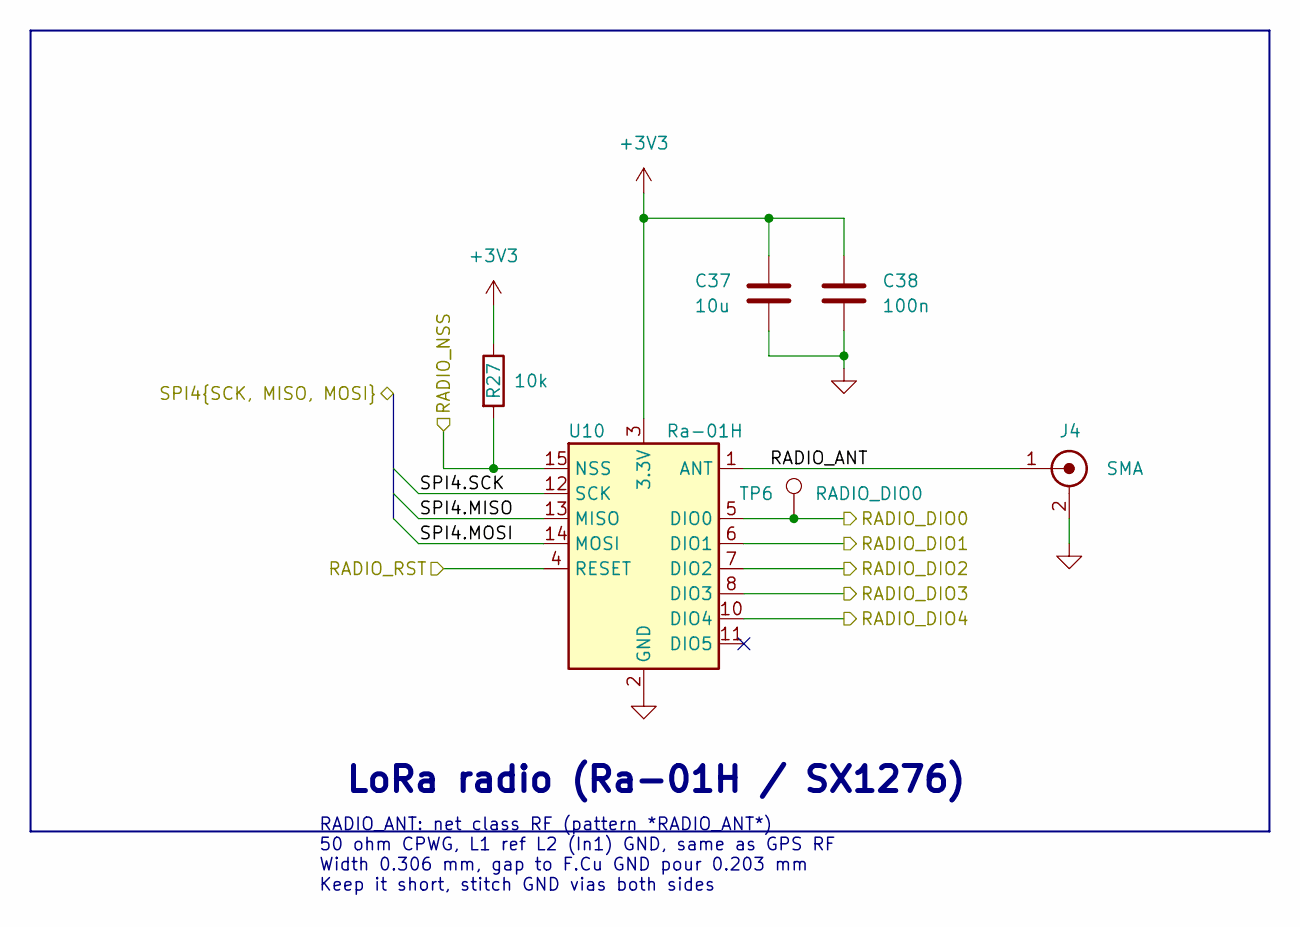
[picture p8: schematic lora.kicad_sch]

Parts:
C37: 10u; C_0805_2012Metric; Voltage 25V; Tolerance 10%; MPN CL21A106KAYNNNE; LCSC Part C15850
C38: 100n; C_0402_1005Metric; Voltage 16V; Tolerance 10%; MPN CL05B104KO5NNNC; LCSC Part C1525
J4: SMA; SMA_BAT-Wireless_BWSMA-KE-Z001_Vertical; MPN BWSMA-KE-Z001; LCSC Part C496549
R27: 10k; R_0402_1005Metric; Tolerance 1%; Voltage 50V; MPN 0402WGF1002TCE; LCSC Part C25744
TP6: RADIO_DIO0; TestPoint_Pad_D1.5mm
U10: Ra-01H; Ai-Thinker_Ra-01H_SMD-16_17x16mm; MPN Ra-01H; LCSC Part C503593

Connections:
+3V3: C37.1, C38.1, R27.1, U10.3 (3.3V); also elsewhere on the board
/MCU/RADIO_DIO0: TP6.1 (1_1), U10.5 (DIO0); also elsewhere on the board
/MCU/RADIO_DIO1: U10.6 (DIO1); also elsewhere on the board
/MCU/RADIO_DIO2: U10.7 (DIO2); also elsewhere on the board
/MCU/RADIO_DIO3: U10.8 (DIO3); also elsewhere on the board
/MCU/RADIO_DIO4: U10.10 (DIO4); also elsewhere on the board
/MCU/RADIO_NSS: R27.2, U10.15 (NSS); also elsewhere on the board
/MCU/RADIO_RST: U10.4 (RESET); also elsewhere on the board
/MCU/SPI4.MISO: U10.13 (MISO); also elsewhere on the board
/MCU/SPI4.MOSI: U10.14 (MOSI); also elsewhere on the board
/MCU/SPI4.SCK: U10.12 (SCK); also elsewhere on the board
/lora/RADIO_ANT: J4.1, U10.1 (ANT)
GND: C37.2, C38.2, J4.2, U10.2 (GND), U10.9 (GND), U10.16 (GND); also elsewhere on the board

Notes on the sheet:
LoRa radio (Ra-01H / SX1276)
RADIO_ANT: net class RF (pattern *RADIO_ANT*) 50 ohm CPWG, L1 ref L2 (In1) GND, same as GPS RF Width 0.306 mm, gap to F.Cu GND pour 0.203 mm Keep it short, stitch GND vias both sides

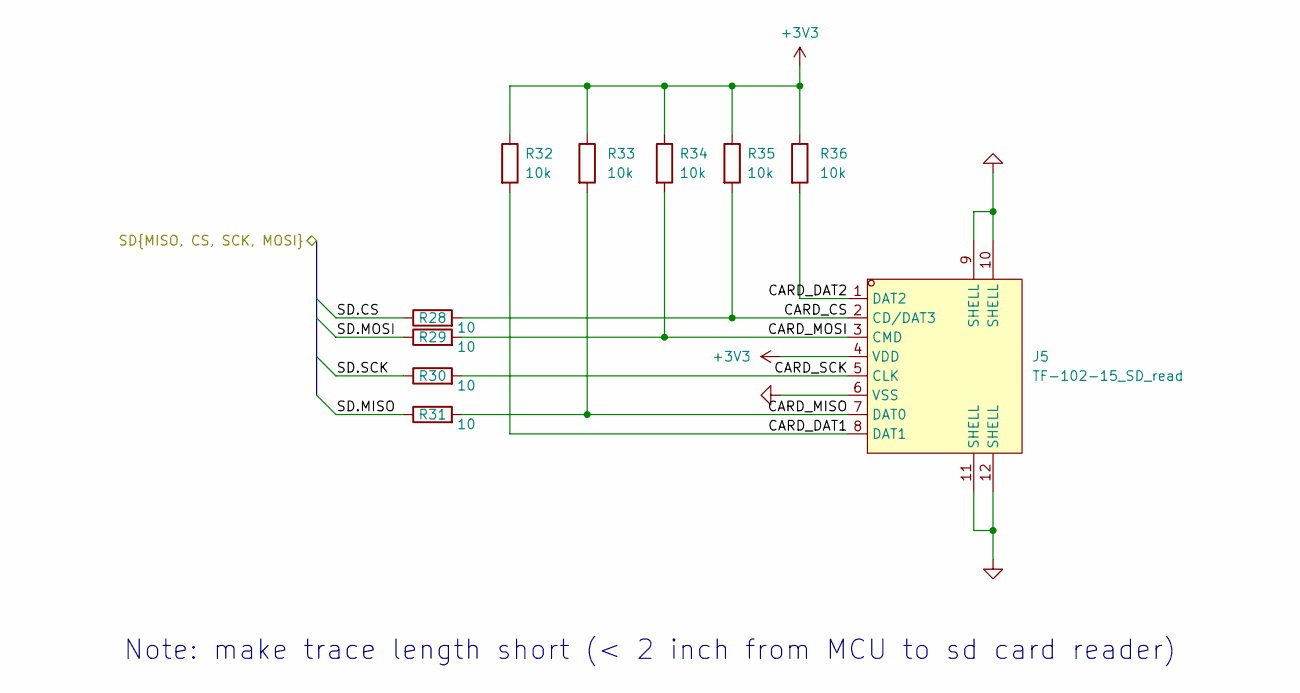
[picture p9: schematic sd.kicad_sch]

Parts:
J5: TF-102-15_SD_read; TF-SMD_TF-102-15; MPN TF-102-15; LCSC Part C266609
R28, R29, R30, R31: 10; R_0402_1005Metric; Tolerance 1%; Voltage 50V; MPN 0402WGF100JTCE; LCSC Part C25077
R32, R33, R34, R35, R36: 10k; R_0402_1005Metric; Tolerance 1%; Voltage 50V; MPN 0402WGF1002TCE; LCSC Part C25744

Connections:
+3V3: J5.4 (VDD), R32.1, R33.1, R34.1, R35.1, R36.1; also elsewhere on the board
/MCU/SDSPI.CS: R28.1; also elsewhere on the board
/MCU/SDSPI.MISO: R31.1; also elsewhere on the board
/MCU/SDSPI.MOSI: R29.1; also elsewhere on the board
/MCU/SDSPI.SCK: R30.1; also elsewhere on the board
/SD/CARD_CS: J5.2 (CD/DAT3), R28.2, R35.2
/SD/CARD_DAT1: J5.8 (DAT1), R32.2
/SD/CARD_DAT2: J5.1 (DAT2), R36.2
/SD/CARD_MISO: J5.7 (DAT0), R31.2, R33.2
/SD/CARD_MOSI: J5.3 (CMD), R29.2, R34.2
/SD/CARD_SCK: J5.5 (CLK), R30.2
GND: J5.6 (VSS), J5.9 (SHELL), J5.10 (SHELL), J5.11 (SHELL), J5.12 (SHELL); also elsewhere on the board

Notes on the sheet:
Note: make trace length short (< 2 inch from MCU to sd card reader)

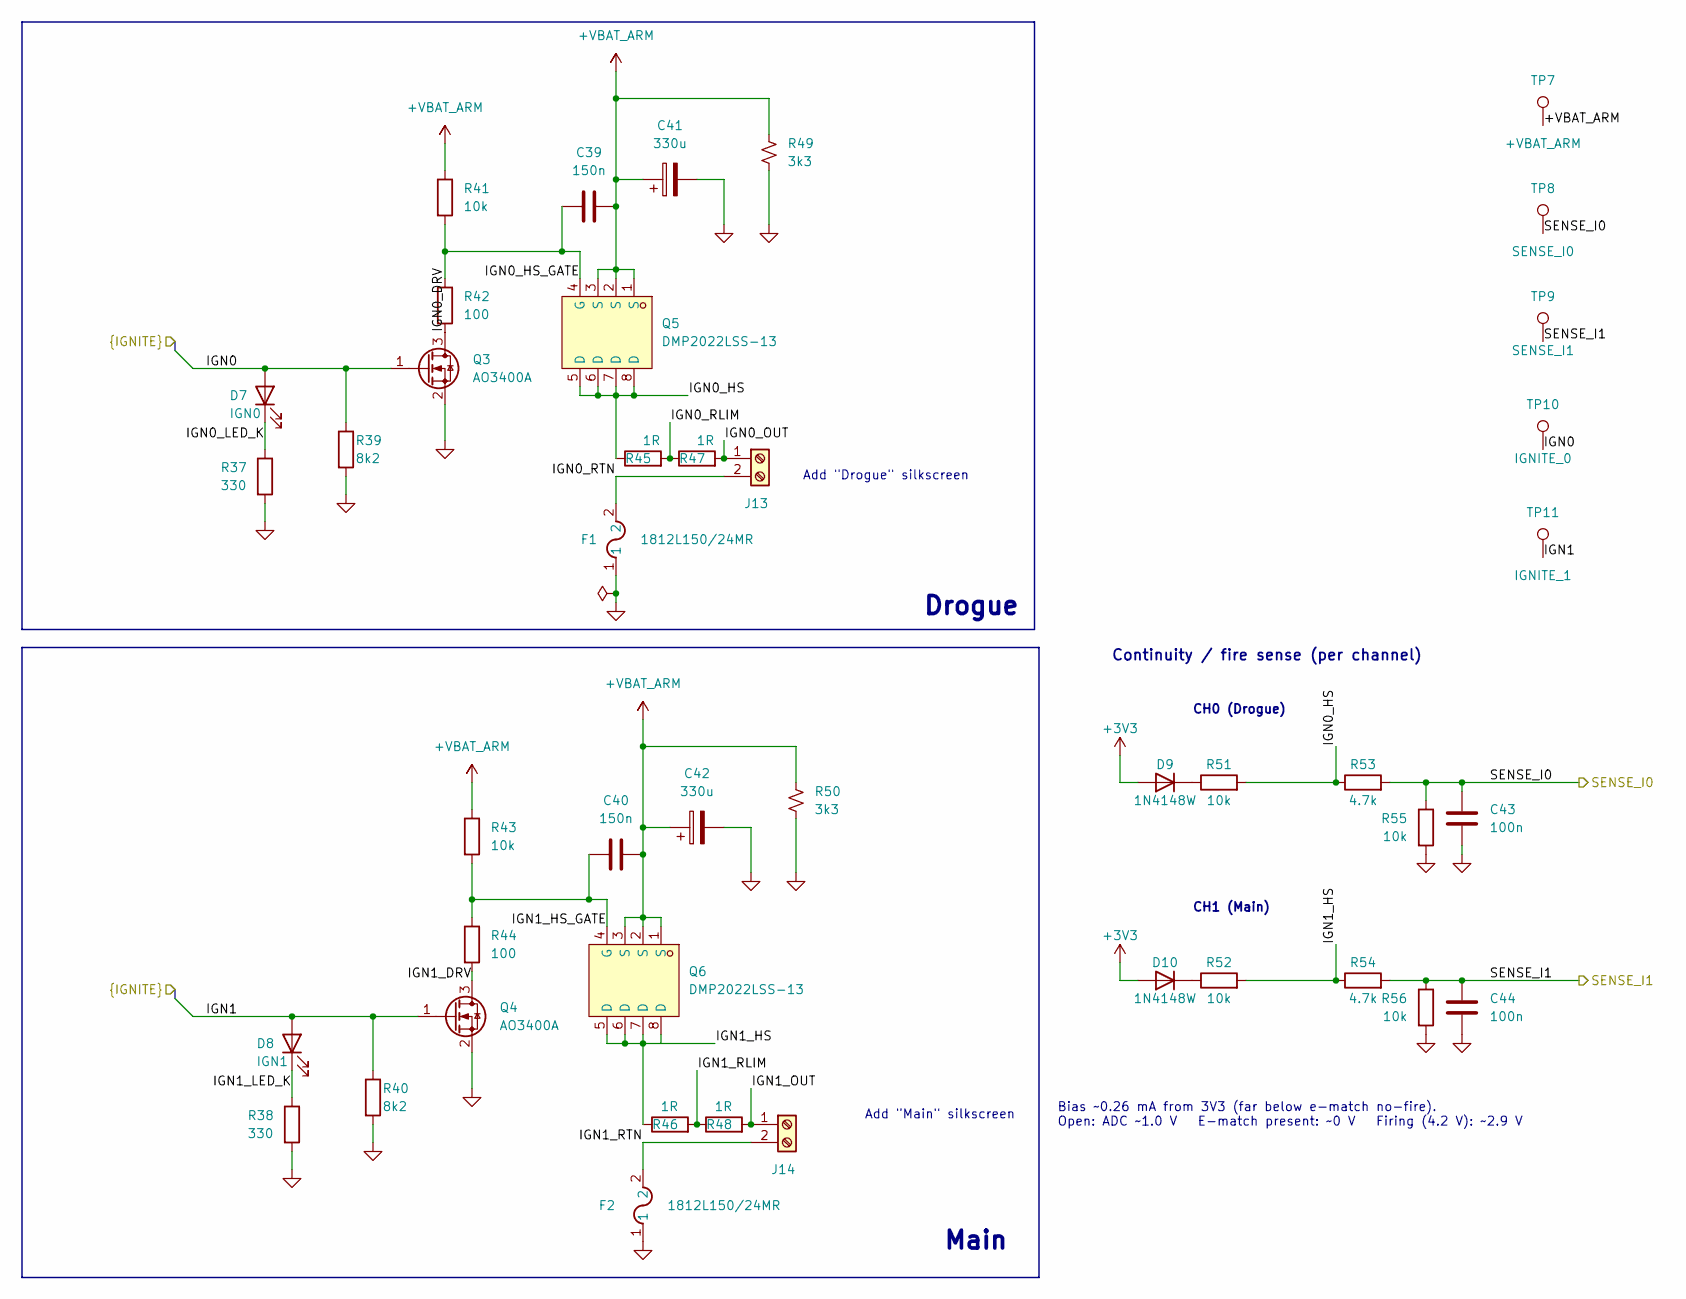
[picture p10: schematic igniter.kicad_sch]

Parts:
C39, C40: 150n; C_0603_1608Metric; Tolerance 10%; Voltage 50V; MPN CC0603KRX7R9BB154; LCSC Part C513735
C41, C42: 330u; CP_Elec_8x10; Tolerance 20%; Voltage 25V; MPN RVT1E331M0810; LCSC Part C970701
C43, C44: 100n; C_0402_1005Metric; Voltage 16V; Tolerance 10%; MPN CL05B104KO5NNNC; LCSC Part C1525
D7: IGN0; LED_0603_1608Metric; MPN KT-0603R; LCSC Part C2286
D8: IGN1; LED_0603_1608Metric; MPN KT-0603R; LCSC Part C2286
D9, D10: 1N4148W; D_SOD-123; MPN 1N4148W; LCSC Part C81598
F1, F2: 1812L150/24MR; Fuse_1812_4532Metric; MPN 1812L150/24MR; LCSC Part C142805
J13, J14: WJ128V-5.0-2P; TerminalBlock_Kangnex_WJ128V-5.0-2P_C8269; MPN WJ128V-5.0-02P-14-00A; LCSC Part C8269
Q3, Q4: AO3400A; SOT-23; MPN AO3400A; LCSC Part C20917
Q5, Q6: DMP2022LSS-13; SOIC-8_3.9x4.9mm_P1.27mm; MPN DMP2022LSS-13; LCSC Part C154919
R37, R38: 330; R_0402_1005Metric; Tolerance 1%; Voltage 50V; MPN 0402WGF3300TCE; LCSC Part C25104
R39, R40: 8k2; R_0402_1005Metric; Tolerance 1%; Voltage 50V; MPN 0402WGF8201TCE; LCSC Part C25924
R41, R43: 10k; R_1206_3216Metric; Tolerance 1%; Voltage 200V; MPN 1206W4F1002T5E; LCSC Part C17902
R42, R44: 100; R_0402_1005Metric; Tolerance 1%; Voltage 50V; MPN 0402WGF1000TCE; LCSC Part C25076
R45, R46, R47, R48: 1R; R_2512_6332Metric; Tolerance 1%; Voltage 300V; MPN CRM2512-FX-1R00ELF; LCSC Part C840604
R49, R50: 3k3; R_0603_1608Metric; Voltage 75V; Tolerance 1%; MPN 0603WAF3301T5E; LCSC Part C22978
R51, R52, R55, R56: 10k; R_0402_1005Metric; Voltage 50V; Tolerance 1%; MPN 0402WGF1002TCE; LCSC Part C25744
R53, R54: 4.7k; R_0402_1005Metric; Voltage 50V; Tolerance 1%; MPN 0402WGF4701TCE; LCSC Part C25900
TP7: +VBAT_ARM; TestPoint_Plated_Hole_D2.0mm
TP8: SENSE_I0; TestPoint_Plated_Hole_D2.0mm
TP9: SENSE_I1; TestPoint_Plated_Hole_D2.0mm
TP10: IGNITE_0; TestPoint_Plated_Hole_D2.0mm
TP11: IGNITE_1; TestPoint_Plated_Hole_D2.0mm

Connections:
+3V3: D9.2 (A), D10.2 (A); also elsewhere on the board
+VBAT_ARM: C39.1, C40.1, C41.1, C42.1, Q5.1 (S), Q5.2 (S), Q5.3 (S), Q6.1 (S), Q6.2 (S), Q6.3 (S), R41.1, R43.1, R49.2, R50.2, TP7.1 (1_1); also elsewhere on the board
/Igniter/IGN0: D7.2 (A), Q3.1 (G), R39.1, TP10.1 (1_1); also elsewhere on the board
/Igniter/IGN0_DRV: Q3.3 (D), R42.2
/Igniter/IGN0_HS: Q5.5 (D), Q5.6 (D), Q5.7 (D), Q5.8 (D), R45.1, R51.2, R53.1
/Igniter/IGN0_HS_GATE: C39.2, Q5.4 (G), R41.2, R42.1
/Igniter/IGN0_LED_K: D7.1 (K), R37.1
/Igniter/IGN0_OUT: J13.1, R47.2
/Igniter/IGN0_RLIM: R45.2, R47.1
/Igniter/IGN0_RTN: F1.2, J13.2
/Igniter/IGN1: D8.2 (A), Q4.1 (G), R40.1, TP11.1 (1_1); also elsewhere on the board
/Igniter/IGN1_DRV: Q4.3 (D), R44.2
/Igniter/IGN1_HS: Q6.5 (D), Q6.6 (D), Q6.7 (D), Q6.8 (D), R46.1, R52.2, R54.1
/Igniter/IGN1_HS_GATE: C40.2, Q6.4 (G), R43.2, R44.1
/Igniter/IGN1_LED_K: D8.1 (K), R38.1
/Igniter/IGN1_OUT: J14.1, R48.2
/Igniter/IGN1_RLIM: R46.2, R48.1
/Igniter/IGN1_RTN: F2.2, J14.2
/Igniter/SENSE_I0: C43.1, R53.2, R55.1, TP8.1 (1_1); also elsewhere on the board
/Igniter/SENSE_I1: C44.1, R54.2, R56.1, TP9.1 (1_1); also elsewhere on the board
GND: C41.2, C42.2, C43.2, C44.2, F1.1, F2.1, Q3.2 (S), Q4.2 (S), R37.2, R38.2, R39.2, R40.2, R49.1, R50.1, R55.2, R56.2; also elsewhere on the board
unnamed: D9.1 (K), R51.1
unnamed: D10.1 (K), R52.1

Notes on the sheet:
CH1 (Main)
Bias ~0.26 mA from 3V3 (far below e-match no-fire). Open: ADC ~1.0 V E-match present: ~0 V Firing (4.2 V): ~2.9 V
Add "Drogue" silkscreen
Add "Main" silkscreen
Continuity / fire sense (per channel)
Drogue
Main
CH0 (Drogue)

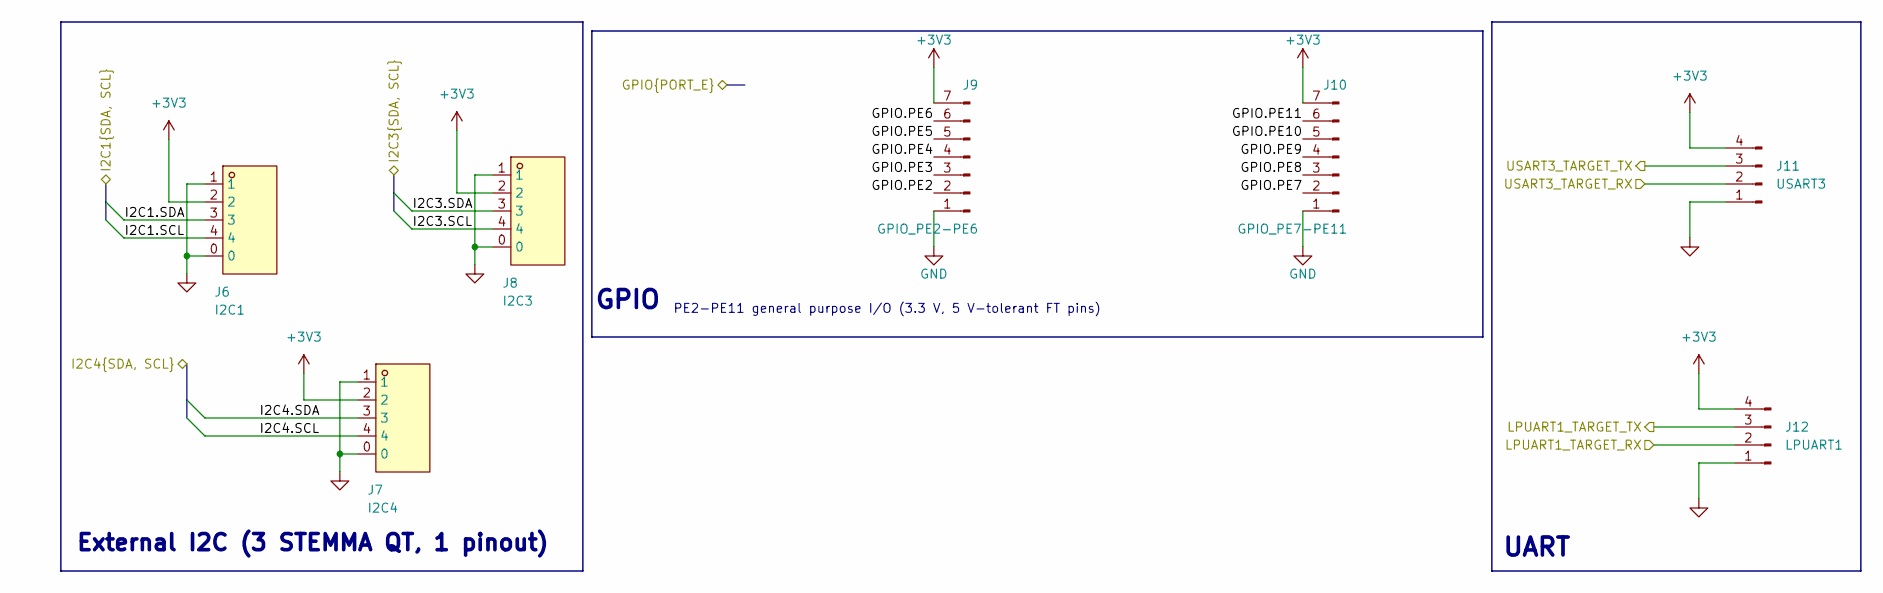
[picture p11: schematic external.kicad_sch]

Parts:
J6: I2C1; StemmaQT; MPN BM04B-SRSS-TB(LF)(SN); LCSC Part C160390
J7: I2C4; StemmaQT; MPN BM04B-SRSS-TB(LF)(SN); LCSC Part C160390
J8: I2C3; StemmaQT; MPN BM04B-SRSS-TB(LF)(SN); LCSC Part C160390
J9: GPIO_PE2-PE6; PinHeader_1x07_P2.54mm_Vertical; MPN PZ254V-11-07P; LCSC Part C492406
J10: GPIO_PE7-PE11; PinHeader_1x07_P2.54mm_Vertical; MPN PZ254V-11-07P; LCSC Part C492406
J11: USART3; JST_GH_BM04B-GHS-TBT_1x04-1MP_P1.25mm_Vertical; MPN BM04B-GHS-TBT(LF)(SN); LCSC Part C161692
J12: LPUART1; JST_GH_BM04B-GHS-TBT_1x04-1MP_P1.25mm_Vertical; MPN BM04B-GHS-TBT(LF)(SN); LCSC Part C161692

Connections:
+3V3: J6.2, J7.2, J8.2, J9.7, J10.7, J11.4, J12.4; also elsewhere on the board
/External/GPIO.PE2: J9.2; also elsewhere on the board
/External/GPIO.PE3: J9.3; also elsewhere on the board
/External/GPIO.PE4: J9.4; also elsewhere on the board
/External/GPIO.PE5: J9.5; also elsewhere on the board
/External/GPIO.PE6: J9.6; also elsewhere on the board
/External/GPIO.PE7: J10.2; also elsewhere on the board
/External/GPIO.PE8: J10.3; also elsewhere on the board
/External/GPIO.PE9: J10.4; also elsewhere on the board
/External/GPIO.PE10: J10.5; also elsewhere on the board
/External/GPIO.PE11: J10.6; also elsewhere on the board
/External/I2C1.SCL: J6.4; also elsewhere on the board
/External/I2C1.SDA: J6.3; also elsewhere on the board
/External/I2C3.SCL: J8.4; also elsewhere on the board
/External/I2C3.SDA: J8.3; also elsewhere on the board
/External/I2C4.SCL: J7.4; also elsewhere on the board
/External/I2C4.SDA: J7.3; also elsewhere on the board
/External/LPUART1_TARGET_RX: J12.2; also elsewhere on the board
/External/LPUART1_TARGET_TX: J12.3; also elsewhere on the board
/External/USART3_TARGET_RX: J11.2; also elsewhere on the board
/External/USART3_TARGET_TX: J11.3; also elsewhere on the board
GND: J6.0, J6.1, J7.0, J7.1, J8.0, J8.1, J9.1, J10.1, J11.1, J12.1; also elsewhere on the board

Notes on the sheet:
External I2C (3 STEMMA QT, 1 pinout)
PE2-PE11 general purpose I/O (3.3 V, 5 V-tolerant FT pins)
GPIO
UART

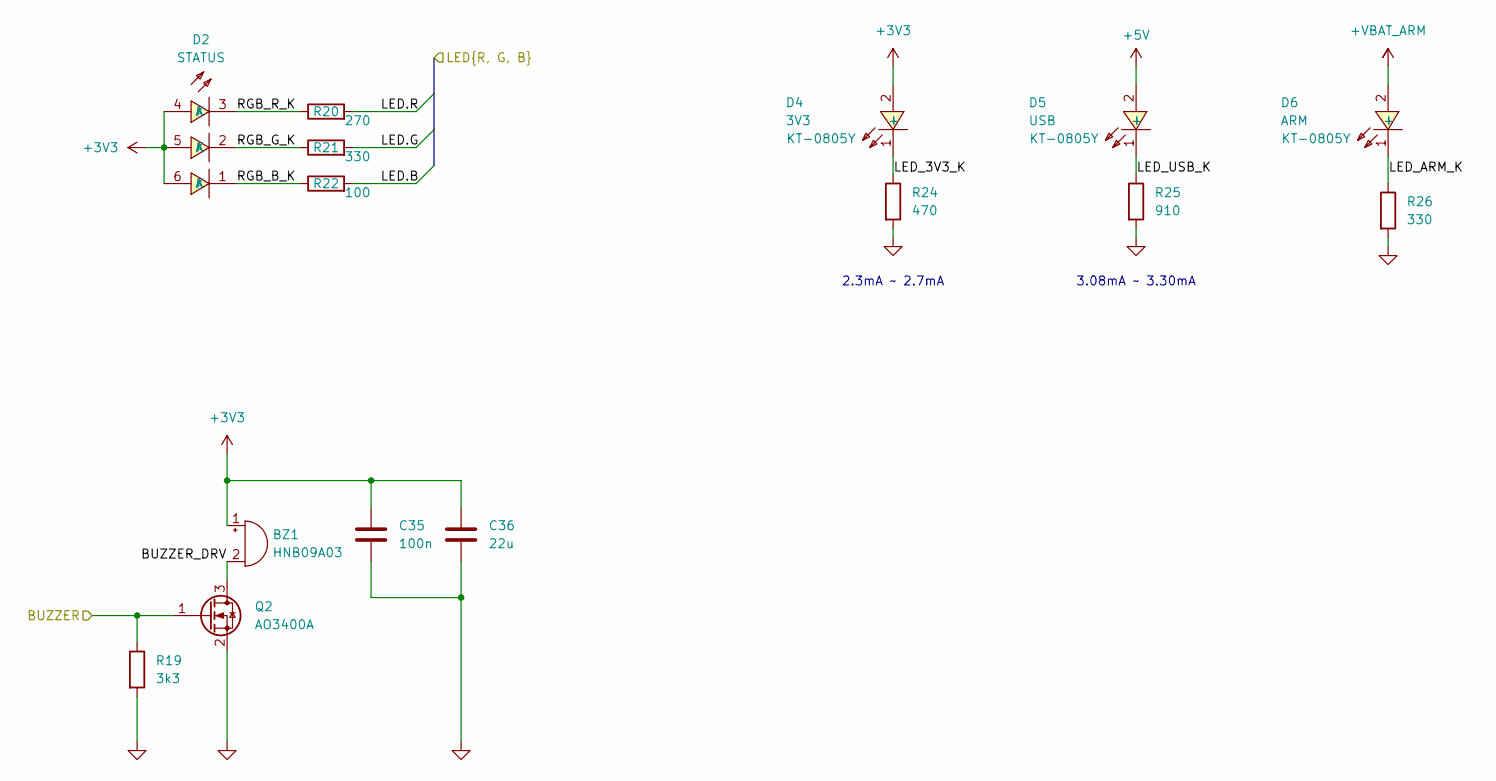
[picture p12: schematic indicators.kicad_sch, AEROLOTL NEW COLLINS FLIGHT COMPUTER]

Parts:
BZ1: HNB09A03; BUZ-TH_BD9.0-P5.00-D0.6-FD; MPN HNB09A03; LCSC Part C96102
C35: 100n; C_0402_1005Metric; Tolerance 10%; Voltage 16V; MPN CL05B104KO5NNNC; LCSC Part C1525
C36: 22u; C_0805_2012Metric; Tolerance 20%; Voltage 25V; MPN CL21A226MAQNNNE; LCSC Part C45783
D2: STATUS; LED-SMD_RS-3535MWAR-2JYJY-J; MPN RS-3535MWAR; LCSC Part C110402
D4: 3V3; LED_0805_2012Metric; MPN KT-0805Y; LCSC Part C2296
D5: USB; LED_0805_2012Metric; MPN KT-0805Y; LCSC Part C2296
D6: ARM; LED_0805_2012Metric; MPN KT-0805Y; LCSC Part C2296
Q2: AO3400A; SOT-23; MPN AO3400A; LCSC Part C20917
R19: 3k3; R_0402_1005Metric; Tolerance 1%; Voltage 50V; MPN 0402WGF3301TCE; LCSC Part C25890
R20: 270; R_0402_1005Metric; Tolerance 1%; Voltage 50V; MPN 0402WGF2700TCE; LCSC Part C25099
R21: 330; R_0402_1005Metric; Tolerance 1%; Voltage 50V; MPN 0402WGF3300TCE; LCSC Part C25104
R22: 100; R_0402_1005Metric; Tolerance 1%; Voltage 50V; MPN 0402WGF1000TCE; LCSC Part C25076
R24: 470; R_0402_1005Metric; Tolerance 1%; Voltage 50V; MPN 0402WGF4700TCE; LCSC Part C25117
R25: 910; R_0402_1005Metric; Tolerance 1%; Voltage 50V; MPN 0402WGF9100TCE; LCSC Part C44933
R26: 330; R_0603_1608Metric; Tolerance 1%; Voltage 75V; MPN 0603WAF3300T5E; LCSC Part C23138

Connections:
+3V3: BZ1.1 (+), C35.1, C36.1, D2.4 (A), D2.5 (A), D2.6 (A), D4.2 (+); also elsewhere on the board
+5V: D5.2 (+); also elsewhere on the board
+VBAT_ARM: D6.2 (+); also elsewhere on the board
/Indicators/BUZZER: Q2.1 (G), R19.1; also elsewhere on the board
/Indicators/BUZZER_DRV: BZ1.2 (-), Q2.3 (D)
/Indicators/LED.B: R22.2; also elsewhere on the board
/Indicators/LED.G: R21.2; also elsewhere on the board
/Indicators/LED.R: R20.2; also elsewhere on the board
/Indicators/LED_3V3_K: D4.1 (-), R24.1
/Indicators/LED_ARM_K: D6.1 (-), R26.1
/Indicators/LED_USB_K: D5.1 (-), R25.1
/Indicators/RGB_B_K: D2.1 (K), R22.1
/Indicators/RGB_G_K: D2.2 (K), R21.1
/Indicators/RGB_R_K: D2.3 (K), R20.1
GND: C35.2, C36.2, Q2.2 (S), R19.2, R24.2, R25.2, R26.2; also elsewhere on the board

Notes on the sheet:
3.08mA ~ 3.30mA
2.3mA ~ 2.7mA

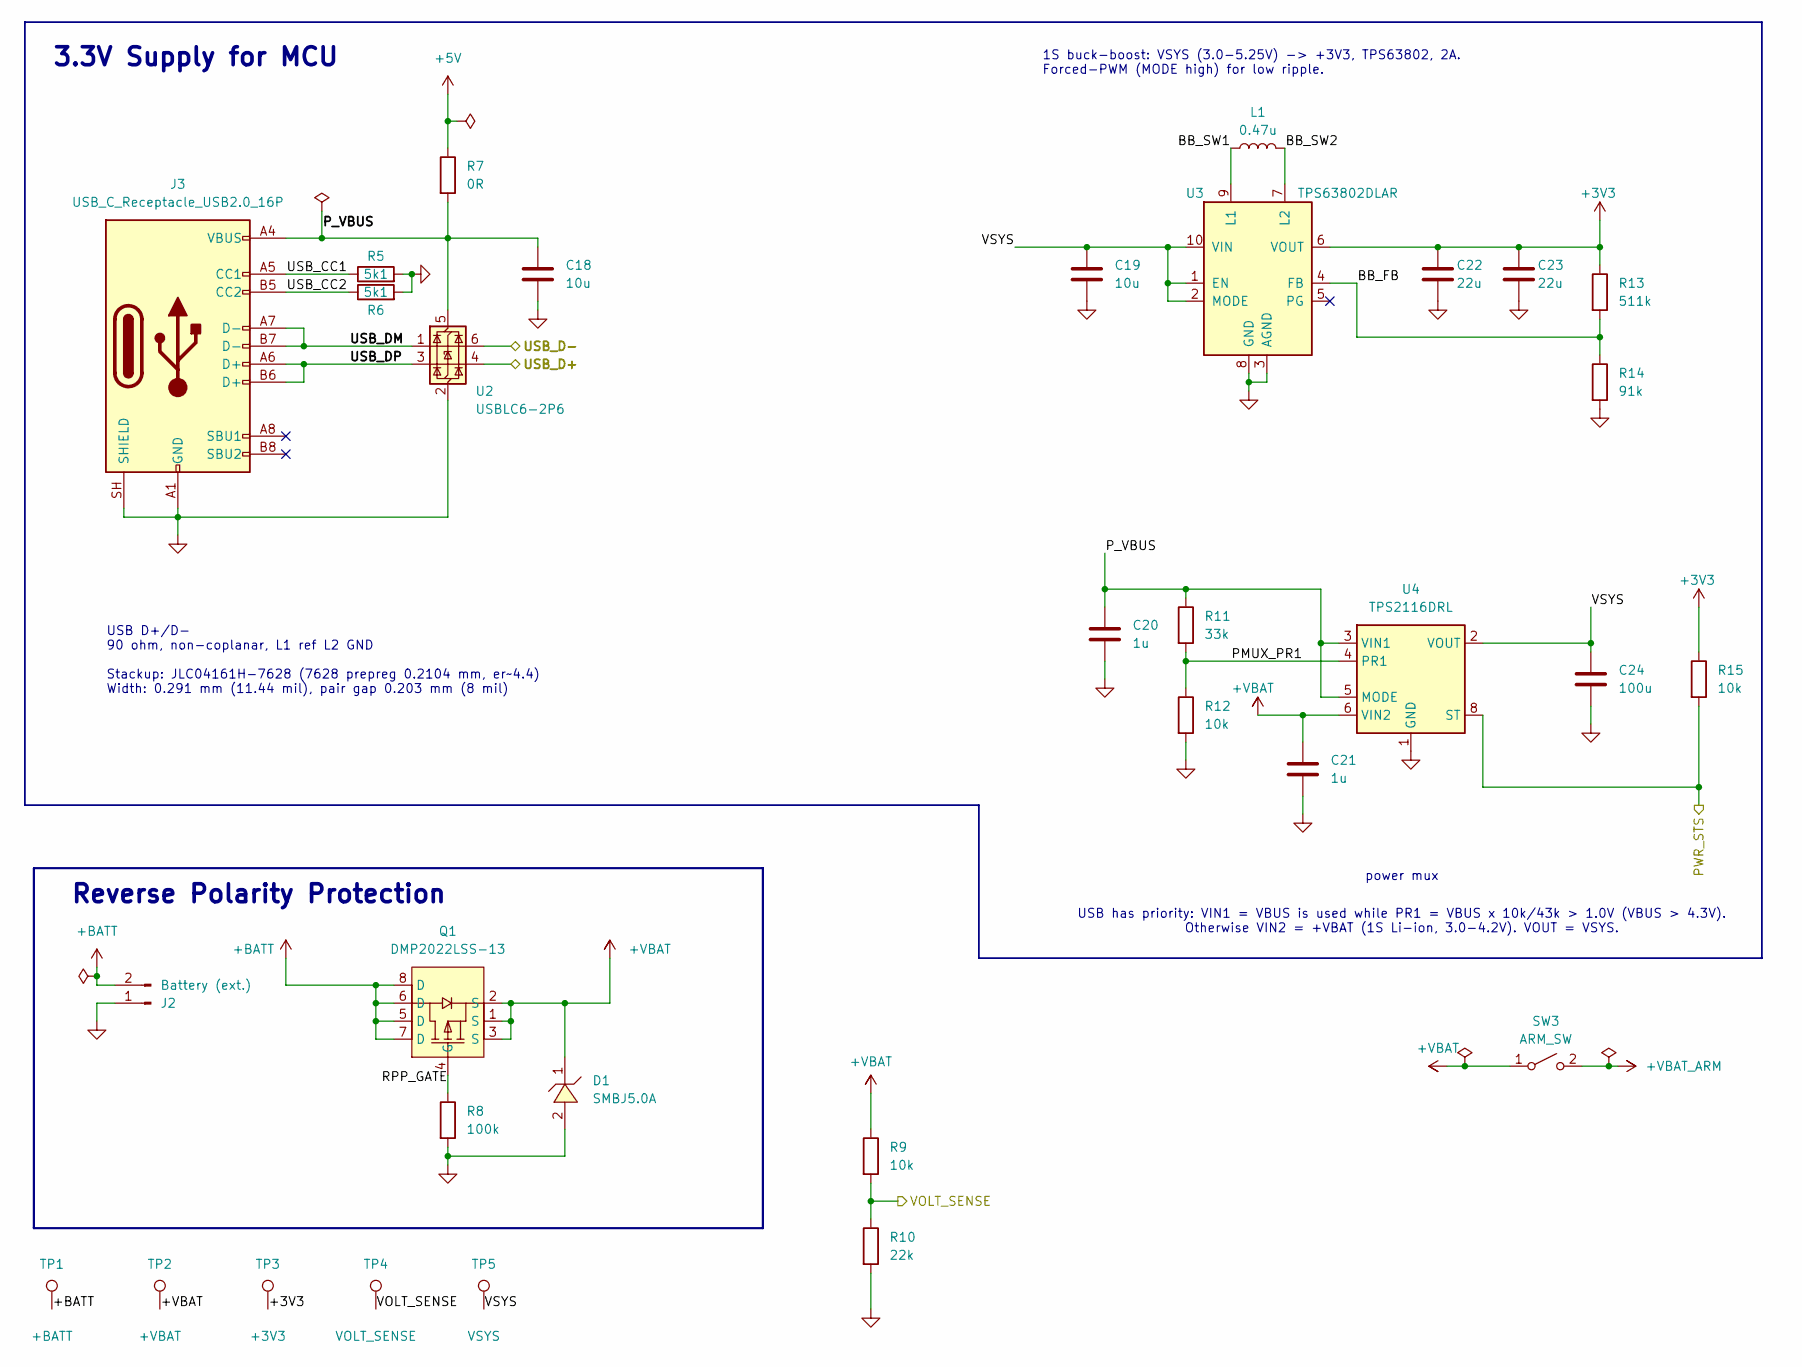
[picture p13: schematic power.kicad_sch]

Parts:
C18: 10u; C_0805_2012Metric; Tolerance 10%; Voltage 25V; MPN CL21A106KAYNNNE; LCSC Part C15850
C19: 10u; C_0805_2012Metric; Voltage 25V; Tolerance 10%; MPN CL21A106KAYNNNE; LCSC Part C15850
C20, C21: 1u; C_0402_1005Metric; Voltage 25V; Tolerance 10%; MPN CL05A105KA5NQNC; LCSC Part C52923
C22, C23: 22u; C_0805_2012Metric; Voltage 25V; Tolerance 20%; MPN CL21A226MAQNNNE; LCSC Part C45783
C24: 100u; C_1206_3216Metric; Voltage 6.3V; Tolerance 20%; MPN CL31A107MQHNNNE; LCSC Part C15008
D1: SMBJ5.0A; D_SMB; MPN SMBJ5.0A; LCSC Part C78423
J2: Battery (ext.); AMASS_XT30UPB-M_1x02_P5.0mm_Vertical; MPN XT30UPB-M; LCSC Part C428721
J3: USB_C_Receptacle_USB2.0_16P; USB_C_Receptacle_HRO_TYPE-C-31-M-12; MPN TYPE-C-31-M-12; LCSC Part C165948
L1: 0.47u; L_Coilcraft_XxL4020; Tolerance 20%; MPN XFL4015-471MEC; LCSC Part C18221164
Q1: DMP2022LSS-13; SOIC-8_3.9x4.9mm_P1.27mm; MPN DMP2022LSS-13; LCSC Part C154919
R5, R6: 5k1; R_0402_1005Metric; Tolerance 1%; Voltage 50V; MPN 0402WGF5101TCE; LCSC Part C25905
R7: 0R; R_0603_1608Metric; Voltage 75V; Tolerance 1%; MPN 0603WAF0000T5E; LCSC Part C21189
R8: 100k; R_0402_1005Metric; Voltage 50V; Tolerance 1%; MPN 0402WGF1003TCE; LCSC Part C25741
R9: 10k; R_0402_1005Metric; Tolerance 1%; Voltage 50V; MPN 0402WGF1002TCE; LCSC Part C25744
R10: 22k; R_0402_1005Metric; Tolerance 1%; Voltage 50V; MPN 0402WGF2202TCE; LCSC Part C25768
R11: 33k; R_0402_1005Metric; Voltage 50V; Tolerance 1%; MPN 0402WGF3302TCE; LCSC Part C25779
R12, R15: 10k; R_0402_1005Metric; Voltage 50V; Tolerance 1%; MPN 0402WGF1002TCE; LCSC Part C25744
R13: 511k; R_0402_1005Metric; Tolerance 1%; Voltage 50V; MPN 0402WGF5113TCE; LCSC Part C64042
R14: 91k; R_0402_1005Metric; Tolerance 1%; Voltage 50V; MPN 0402WGF9102TCE; LCSC Part C4147
SW3: ARM_SW; JST_XH_B2B-XH-A_1x02_P2.50mm_Vertical; MPN B2B-XH-A(LF)(SN); LCSC Part C158012
TP1: +BATT; TestPoint_Plated_Hole_D2.0mm
TP2: +VBAT; TestPoint_Plated_Hole_D2.0mm
TP3: +3V3; TestPoint_Plated_Hole_D2.0mm
TP4: VOLT_SENSE; TestPoint_Plated_Hole_D2.0mm
TP5: VSYS; TestPoint_Plated_Hole_D2.0mm
U2: USBLC6-2P6; SOT-666; MPN USBLC6-2P6; LCSC Part C15999
U3: TPS63802DLAR; TI_VSON-HR-10_2x3mm_P0.5mm_DLA0010A; MPN TPS63802DLAR; LCSC Part C2845237
U4: TPS2116DRL; SOT-583-8; MPN TPS2116DRLR; LCSC Part C3235557

Connections:
+3V3: C22.1, C23.1, R13.1, R15.1, TP3.1 (1_1), U3.6 (VOUT); also elsewhere on the board
+5V: R7.1; also elsewhere on the board
+BATT: J2.2, Q1.5 (D), Q1.6 (D), Q1.7 (D), Q1.8 (D), TP1.1 (1_1)
+VBAT: C21.1, D1.1, Q1.1 (S), Q1.2 (S), Q1.3 (S), R9.1, SW3.1 (A), TP2.1 (1_1), U4.6 (VIN2)
+VBAT_ARM: SW3.2 (B); also elsewhere on the board
/MCU/PWR_STS: R15.2, U4.8 (ST); also elsewhere on the board
/MCU/USB_D+: U2.4 (I/O2); also elsewhere on the board
/MCU/USB_D-: U2.6 (I/O1); also elsewhere on the board
/Power/BB_FB: R13.2, R14.1, U3.4 (FB)
/Power/BB_SW1: L1.1, U3.9 (L1)
/Power/BB_SW2: L1.2, U3.7 (L2)
/Power/PMUX_PR1: R11.2, R12.1, U4.4 (PR1)
/Power/P_VBUS: C18.1, C20.1, J3.A4 (VBUS), J3.A9 (VBUS), J3.B4 (VBUS), J3.B9 (VBUS), R7.2, R11.1, U2.5 (VBUS), U4.3 (VIN1), U4.5 (MODE)
/Power/RPP_GATE: Q1.4 (G), R8.1
/Power/USB_CC1: J3.A5 (CC1), R5.1
/Power/USB_CC2: J3.B5 (CC2), R6.1
/Power/USB_DM: J3.A7 (D-), J3.B7 (D-), U2.1 (I/O1)
/Power/USB_DP: J3.A6 (D+), J3.B6 (D+), U2.3 (I/O2)
/Power/VOLT_SENSE: R9.2, R10.1, TP4.1 (1_1); also elsewhere on the board
/Power/VSYS: C19.1, C24.1, TP5.1 (1_1), U3.1 (EN), U3.2 (MODE), U3.10 (VIN), U4.2 (VOUT), U4.7 (VOUT)
GND: C18.2, C19.2, C20.2, C21.2, C22.2, C23.2, C24.2, D1.2, J2.1, J3.A1 (GND), J3.A12 (GND), J3.B1 (GND), J3.B12 (GND), J3.SH (SHIELD), R5.2, R6.2, R8.2, R10.2, R12.2, R14.2, U2.2 (GND), U3.3 (AGND), U3.8 (GND), U4.1 (GND); also elsewhere on the board

Notes on the sheet:
1S buck-boost: VSYS (3.0-5.25V) -> +3V3, TPS63802, 2A. Forced-PWM (MODE high) for low ripple.
3.3V Supply for MCU
power mux
USB has priority: VIN1 = VBUS is used while PR1 = VBUS x 10k/43k > 1.0V (VBUS > 4.3V). Otherwise VIN2 = +VBAT (1S Li-ion, 3.0-4.2V). VOUT = VSYS.
Reverse Polarity Protection
USB D+/D- 90 ohm, non-coplanar, L1 ref L2 GND Stackup: JLC04161H-7628 (7628 prepreg 0.2104 mm, er~4.4) Width: 0.291 mm (11.44 mil), pair gap 0.203 mm (8 mil)
