stanford-ssi/Aerolotl_AV/pre-silk-backup/aerolotl_av.kicad_pcb

## KiCad design pre-silk-backup/aerolotl_av.kicad_pcb (continued)

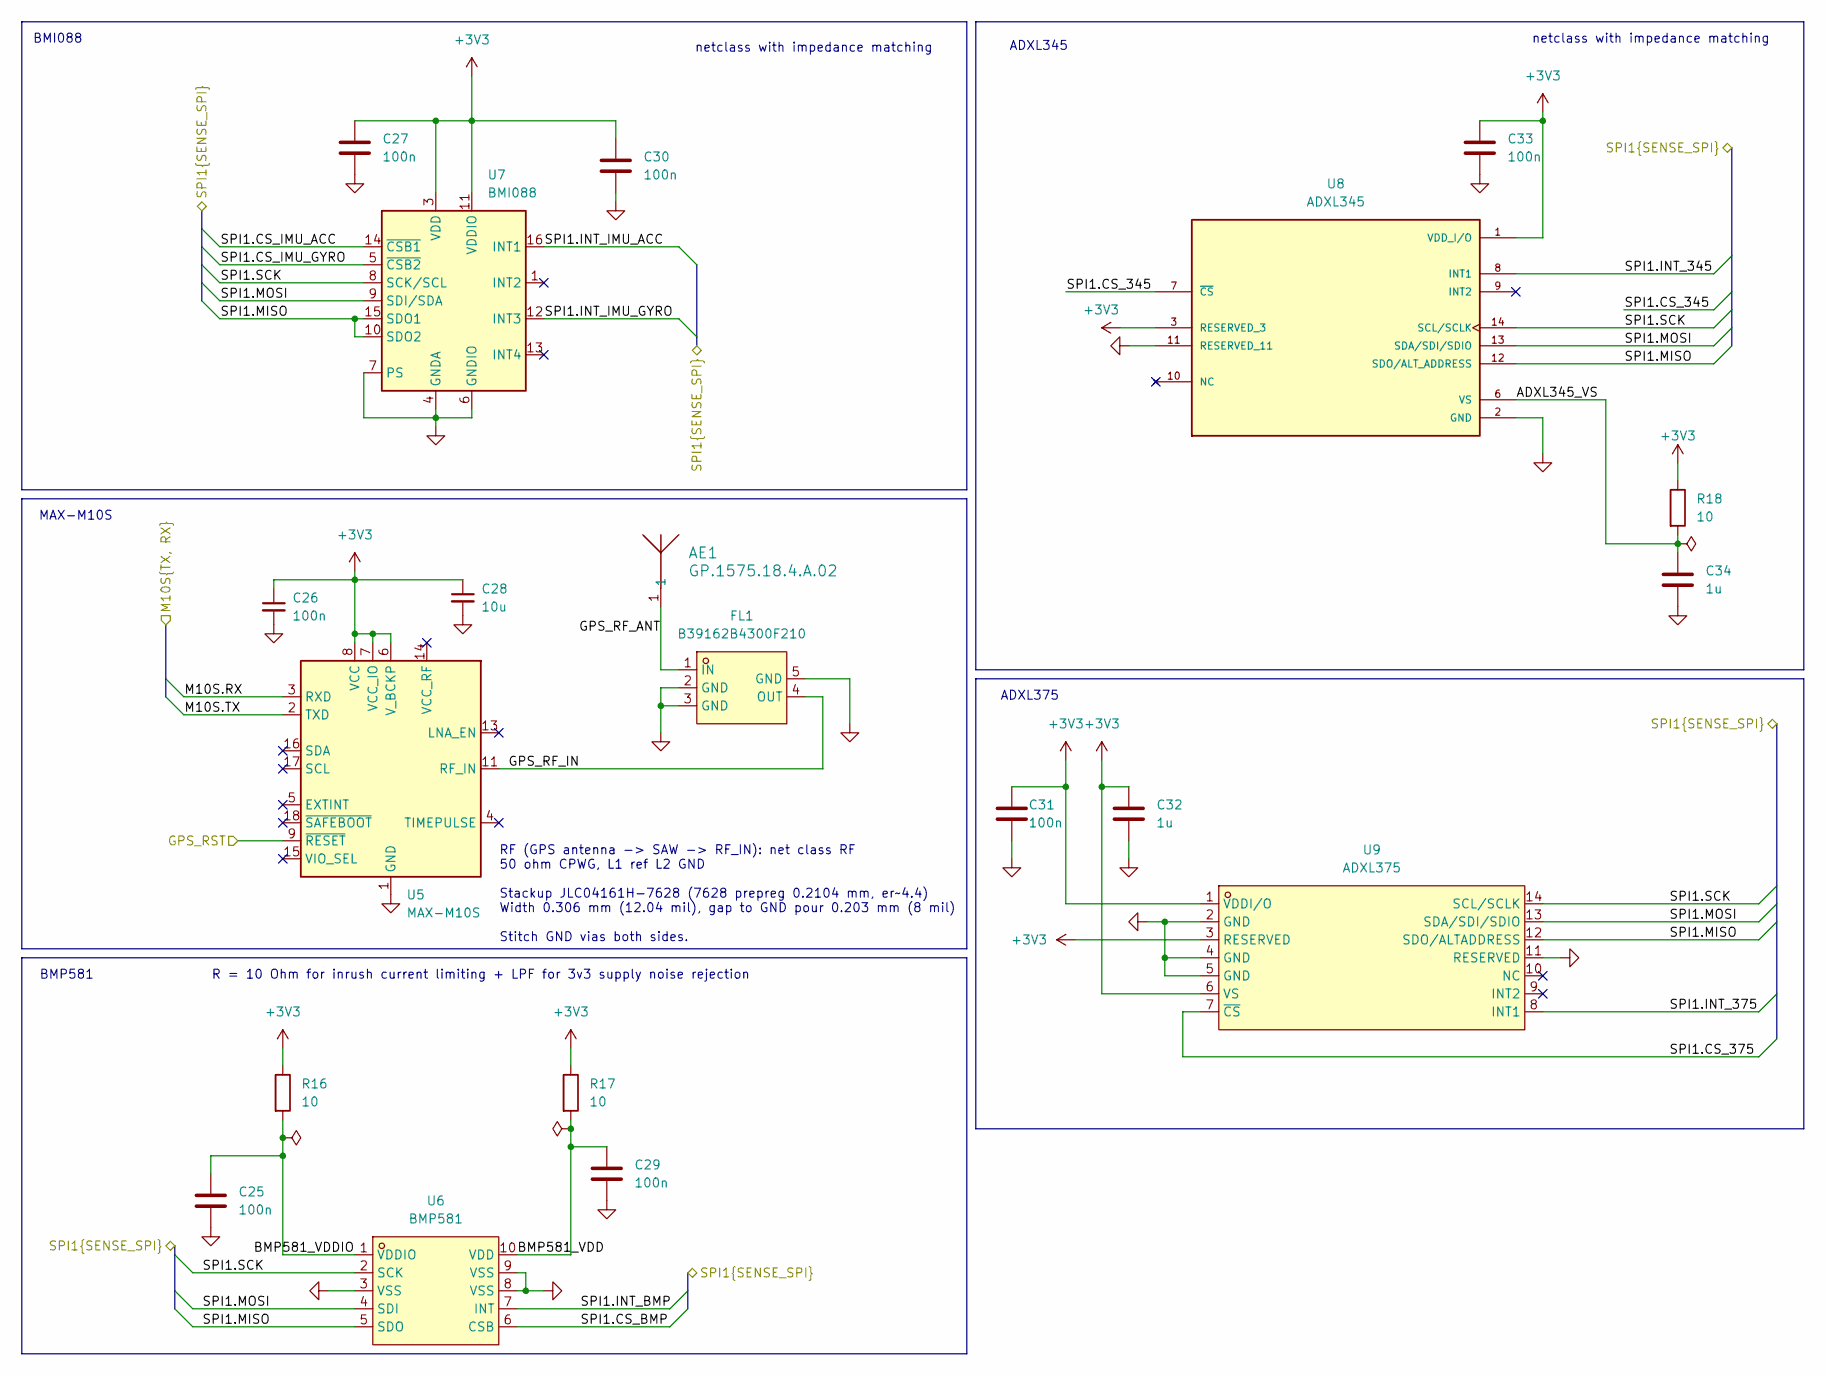
[picture p14: schematic sensors.kicad_sch]

Parts:
AE1: GP.1575.18.4.A.02; ANT_GP.1575.18.4.A.02_TAL; MPN GP.1575.18.4.A.02; LCSC Part C7281913
C25, C27, C29, C30, C31, C33: 100n; C_0402_1005Metric; Tolerance 10%; Voltage 16V; MPN CL05B104KO5NNNC; LCSC Part C1525
C26: 100n; C_0402_1005Metric; Voltage 16V; Tolerance 10%; MPN CL05B104KO5NNNC; LCSC Part C1525
C28: 10u; C_0603_1608Metric; Voltage 10V; Tolerance 10%; MPN CL10A106KP8NNNC; LCSC Part C19702
C32, C34: 1u; CP_EIA-2012-12_Kemet-R; Tolerance 10%; Voltage 10V; MPN TAJR105K010RNJ; LCSC Part C444768
FL1: B39162B4300F210; FILTER-SMD_5P-L1.4-W1.1_RSFPXXXXD; MPN B39162B4300F210; LCSC Part C2650962
R16, R17, R18: 10; R_0402_1005Metric; Tolerance 1%; Voltage 50V; MPN 0402WGF100JTCE; LCSC Part C25077
U5: MAX-M10S; ublox_MAX; MPN MAX-M10S-00B; LCSC Part C4153167
U6: BMP581; LGA-10_L2.0-W2.0-P0.50-TL_BMP581; MPN BMP581; LCSC Part C5362283
U7: BMI088; Bosch_LGA-16_4.5x3mm_P0.5mm_LayoutBorder7x1y_ClockwisePinNu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; MPN BMI088; LCSC Part C194919
U8: ADXL345; ADI_LGA-14_3x5mm_P0.8mm; PARTREV B; LCSC Part C9667
U9: ADXL375; ADI_LGA-14_3x5mm_P0.8mm; MPN ADXL375BCCZ-RL7; LCSC Part C481898

Connections:
+3V3: C26.1, C27.1, C28.1, C30.1, C31.1, C32.1, C33.1, R16.1, R17.1, R18.1, U5.6 (V_BCKP), U5.7 (VCC_IO), U5.8 (VCC), U7.3 (VDD), U7.11 (VDDIO), U8.1 (VDD_I/O), U8.3 (RESERVED_3), U9.1 (VDDI/O), U9.3 (RESERVED), U9.6 (VS); also elsewhere on the board
/MCU/GPS_RST: U5.9 (~RESET); also elsewhere on the board
/MCU/SPI1.CS_345: U8.7 (~CS); also elsewhere on the board
/MCU/SPI1.CS_375: U9.7 (~CS); also elsewhere on the board
/MCU/SPI1.CS_BMP: U6.6 (CSB); also elsewhere on the board
/MCU/SPI1.CS_IMU_ACC: U7.14 (~CSB1); also elsewhere on the board
/MCU/SPI1.CS_IMU_GYRO: U7.5 (~CSB2); also elsewhere on the board
/MCU/SPI1.INT_345: U8.8 (INT1); also elsewhere on the board
/MCU/SPI1.INT_375: U9.8 (INT1); also elsewhere on the board
/MCU/SPI1.INT_BMP: U6.7 (INT); also elsewhere on the board
/MCU/SPI1.INT_IMU_ACC: U7.16 (INT1); also elsewhere on the board
/MCU/SPI1.INT_IMU_GYRO: U7.12 (INT3); also elsewhere on the board
/MCU/SPI1.MISO: U6.5 (SDO), U7.10 (SDO2), U7.15 (SDO1), U8.12 (SDO/ALT_ADDRESS), U9.12 (SDO/ALTADDRESS); also elsewhere on the board
/MCU/SPI1.MOSI: U6.4 (SDI), U7.9 (SDI/SDA), U8.13 (SDA/SDI/SDIO), U9.13 (SDA/SDI/SDIO); also elsewhere on the board
/MCU/SPI1.SCK: U6.2 (SCK), U7.8 (SCK/SCL), U8.14 (SCL/SCLK), U9.14 (SCL/SCLK); also elsewhere on the board
/Sensors/ADXL345_VS: C34.1, R18.2, U8.6 (VS)
/Sensors/BMP581_VDD: C29.1, R17.2, U6.10 (VDD)
/Sensors/BMP581_VDDIO: C25.1, R16.2, U6.1 (VDDIO)
/Sensors/GPS_RF_ANT: AE1.1 (1_1), FL1.1 (IN)
/Sensors/GPS_RF_IN: FL1.4 (OUT), U5.11 (RF_IN)
/Sensors/M10S.RX: U5.3 (RXD); also elsewhere on the board
/Sensors/M10S.TX: U5.2 (TXD); also elsewhere on the board
GND: C25.2, C26.2, C27.2, C28.2, C29.2, C30.2, C31.2, C32.2, C33.2, C34.2, FL1.2 (GND), FL1.3 (GND), FL1.5 (GND), U5.1 (GND), U5.10 (GND), U5.12 (GND), U6.3 (VSS), U6.8 (VSS), U6.9 (VSS), U7.2 (GNDA), U7.4 (GNDA), U7.6 (GNDIO), U7.7 (PS), U8.2 (GND), U8.4 (GND), U8.5 (GND), U8.11 (RESERVED_11), U9.2 (GND), U9.4 (GND), U9.5 (GND), U9.11 (RESERVED); also elsewhere on the board

Notes on the sheet:
MAX-M10S
RF (GPS antenna -> SAW -> RF_IN): net class RF 50 ohm CPWG, L1 ref L2 GND Stackup JLC04161H-7628 (7628 prepreg 0.2104 mm, er~4.4) Width 0.306 mm (12.04 mil), gap to GND pour 0.203 mm (8 mil) Stitch GND vias both sides.
ADXL375
R = 10 Ohm for inrush current limiting + LPF for 3v3 supply noise rejection
BMI088
netclass with impedance matching
ADXL345
BMP581

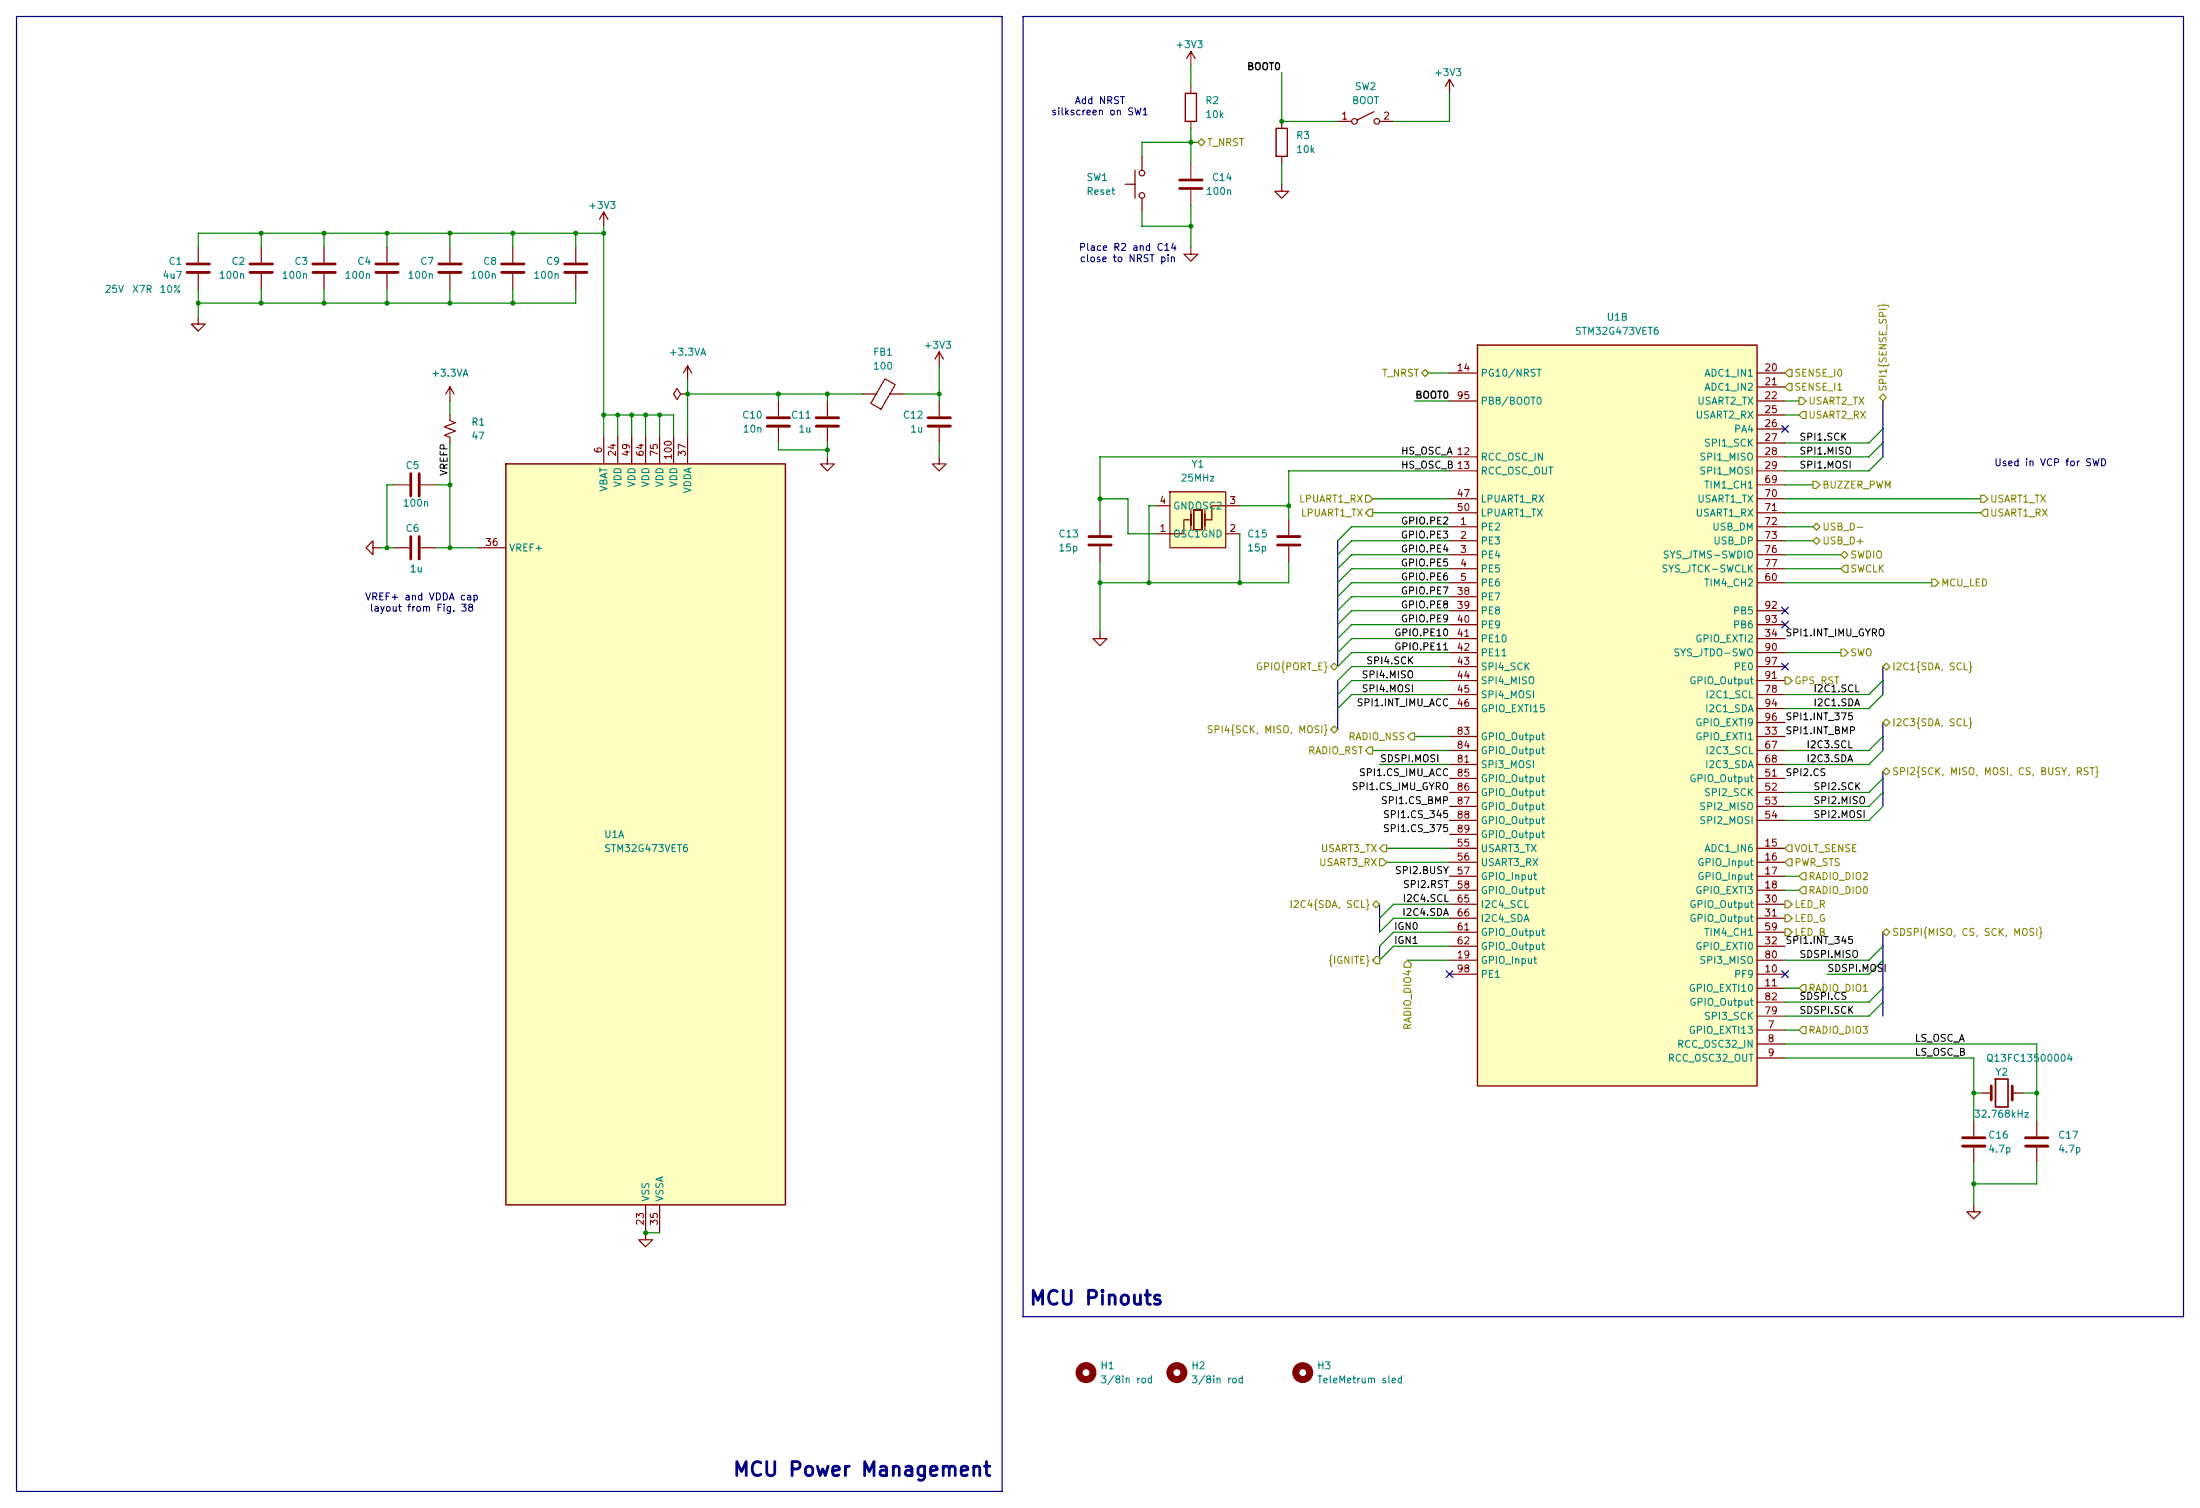
[picture p15: schematic mcu.kicad_sch, AEROLOTL NEW COLLINS FLIGHT COMPUTER]

Parts:
C1: 4u7; C_0805_2012Metric; Tolerance 10%; Voltage 25V; MPN CL21B475KAFNNNE; LCSC Part C98195
C2, C3, C4, C5, C7, C8, C9: 100n; C_0402_1005Metric; Tolerance 10%; Voltage 16V; MPN CL05B104KO5NNNC; LCSC Part C1525
C6, C11, C12: 1u; C_0603_1608Metric; Tolerance 10%; Voltage 25V; MPN CL10B105KA8NNNC; LCSC Part C29936
C10: 10n; C_0402_1005Metric; Tolerance 10%; Voltage 50V; MPN CL05B103KB5NNNC; LCSC Part C15195
C13, C15: 15p; C_0402_1005Metric; Tolerance 5%; Voltage 50V; MPN 0402CG150J500NT; LCSC Part C1548
C14: 100n; C_0603_1608Metric; Tolerance 10%; Voltage 50V; MPN CC0603KRX7R9BB104; LCSC Part C14663
C16, C17: 4.7p; C_0402_1005Metric; Tolerance 0.25pF; Voltage 50V; MPN 0402CG4R7C500NT; LCSC Part C1569
FB1: 100; L_0805_2012Metric; MPN GZ2012D101TF; LCSC Part C1015
H1, H2: 3/8in rod; MountingHole_3-8in_Grommet_Heyco_G1123_D14.3mm
H3: TeleMetrum sled; TeleMetrum_Sled_Mount_2xM4
R1: 47; R_0402_1005Metric; Voltage 50V; Tolerance 1%; MPN 0402WGF470JTCE; LCSC Part C25118
R2, R3: 10k; R_0603_1608Metric; Tolerance 1%; Voltage 75V; MPN 0603WAF1002T5E; LCSC Part C25804
SW1: Reset; SW_SPST_TL3342; MPN TL3342F160QG; LCSC Part C2886898
SW2: BOOT; SW_SPST_TL3342; MPN TL3342F160QG; LCSC Part C2886898
U1: STM32G473VET6; LQFP-100_14x14mm_P0.5mm; MPN STM32G473VET6; LCSC Part C730122
Y1: 25MHz; Crystal_SMD_3225-4Pin_3.2x2.5mm; MPN X322525MOB4SI; LCSC Part C9006
Y2: 32.768kHz; Crystal_SMD_3215-2Pin_3.2x1.5mm; mfr. part no. Q13FC13500004; LCSC Part C20340322

Connections:
+3.3VA: C10.1, C11.1, FB1.1, R1.1, U1.37 (VDDA)
+3V3: C1.1, C2.1, C3.1, C4.1, C7.1, C8.1, C9.1, C12.1, FB1.2, R2.1, SW2.2 (B), U1.6 (VBAT), U1.24 (VDD), U1.49 (VDD), U1.64 (VDD), U1.75 (VDD), U1.100 (VDD); also elsewhere on the board
/Debugger/T_NRST: C14.1, R2.2, SW1.2, U1.14 (PG10/NRST); also elsewhere on the board
/Debugger/T_SWCLK: U1.77 (SYS_JTCK-SWCLK); also elsewhere on the board
/Debugger/T_SWDIO: U1.76 (SYS_JTMS-SWDIO); also elsewhere on the board
/Debugger/T_SWO: U1.90 (SYS_JTDO-SWO); also elsewhere on the board
/Debugger/T_VCP_RX: U1.70 (USART1_TX); also elsewhere on the board
/Debugger/T_VCP_TX: U1.71 (USART1_RX); also elsewhere on the board
/External/GPIO.PE2: U1.1 (PE2); also elsewhere on the board
/External/GPIO.PE3: U1.2 (PE3); also elsewhere on the board
/External/GPIO.PE4: U1.3 (PE4); also elsewhere on the board
/External/GPIO.PE5: U1.4 (PE5); also elsewhere on the board
/External/GPIO.PE6: U1.5 (PE6); also elsewhere on the board
/External/GPIO.PE7: U1.38 (PE7); also elsewhere on the board
/External/GPIO.PE8: U1.39 (PE8); also elsewhere on the board
/External/GPIO.PE9: U1.40 (PE9); also elsewhere on the board
/External/GPIO.PE10: U1.41 (PE10); also elsewhere on the board
/External/GPIO.PE11: U1.42 (PE11); also elsewhere on the board
/External/I2C1.SCL: U1.78 (I2C1_SCL); also elsewhere on the board
/External/I2C1.SDA: U1.94 (I2C1_SDA); also elsewhere on the board
/External/I2C3.SCL: U1.67 (I2C3_SCL); also elsewhere on the board
/External/I2C3.SDA: U1.68 (I2C3_SDA); also elsewhere on the board
/External/I2C4.SCL: U1.65 (I2C4_SCL); also elsewhere on the board
/External/I2C4.SDA: U1.66 (I2C4_SDA); also elsewhere on the board
/External/LPUART1_TARGET_RX: U1.47 (LPUART1_RX); also elsewhere on the board
/External/LPUART1_TARGET_TX: U1.50 (LPUART1_TX); also elsewhere on the board
/External/USART3_TARGET_RX: U1.56 (USART3_RX); also elsewhere on the board
/External/USART3_TARGET_TX: U1.55 (USART3_TX); also elsewhere on the board
/Igniter/IGN0: U1.61 (GPIO_Output); also elsewhere on the board
/Igniter/IGN1: U1.62 (GPIO_Output); also elsewhere on the board
/Igniter/SENSE_I0: U1.20 (ADC1_IN1); also elsewhere on the board
/Igniter/SENSE_I1: U1.21 (ADC1_IN2); also elsewhere on the board
/Indicators/BUZZER: U1.69 (TIM1_CH1); also elsewhere on the board
/Indicators/LED.B: U1.59 (TIM4_CH1); also elsewhere on the board
/Indicators/LED.G: U1.31 (GPIO_Output); also elsewhere on the board
/Indicators/LED.R: U1.30 (GPIO_Output); also elsewhere on the board
/MCU/BOOT0: R3.1, SW2.1 (A), U1.95 (PB8/BOOT0)
/MCU/GPS_RST: U1.91 (GPIO_Output); also elsewhere on the board
/MCU/HS_OSC_A: C13.1, U1.12 (RCC_OSC_IN), Y1.1 (OSC1)
/MCU/HS_OSC_B: C15.1, U1.13 (RCC_OSC_OUT), Y1.3 (OSC2)
/MCU/LS_OSC_A: C17.1, U1.8 (RCC_OSC32_IN), Y2.2
/MCU/LS_OSC_B: C16.1, U1.9 (RCC_OSC32_OUT), Y2.1
/MCU/MCU_LED: U1.60 (TIM4_CH2)
/MCU/PWR_STS: U1.16 (GPIO_Input); also elsewhere on the board
/MCU/RADIO_DIO0: U1.18 (GPIO_EXTI3); also elsewhere on the board
/MCU/RADIO_DIO1: U1.11 (GPIO_EXTI10); also elsewhere on the board
/MCU/RADIO_DIO2: U1.17 (GPIO_Input); also elsewhere on the board
/MCU/RADIO_DIO3: U1.7 (GPIO_EXTI13); also elsewhere on the board
/MCU/RADIO_DIO4: U1.19 (GPIO_Input); also elsewhere on the board
/MCU/RADIO_NSS: U1.83 (GPIO_Output); also elsewhere on the board
/MCU/RADIO_RST: U1.84 (GPIO_Output); also elsewhere on the board
/MCU/SDSPI.CS: U1.82 (GPIO_Output); also elsewhere on the board
/MCU/SDSPI.MISO: U1.80 (SPI3_MISO); also elsewhere on the board
/MCU/SDSPI.MOSI: U1.81 (SPI3_MOSI); also elsewhere on the board
/MCU/SDSPI.SCK: U1.79 (SPI3_SCK); also elsewhere on the board
/MCU/SPI1.CS_345: U1.88 (GPIO_Output); also elsewhere on the board
/MCU/SPI1.CS_375: U1.89 (GPIO_Output); also elsewhere on the board
/MCU/SPI1.CS_BMP: U1.87 (GPIO_Output); also elsewhere on the board
/MCU/SPI1.CS_IMU_ACC: U1.85 (GPIO_Output); also elsewhere on the board
/MCU/SPI1.CS_IMU_GYRO: U1.86 (GPIO_Output); also elsewhere on the board
/MCU/SPI1.INT_345: U1.32 (GPIO_EXTI0); also elsewhere on the board
/MCU/SPI1.INT_375: U1.96 (GPIO_EXTI9); also elsewhere on the board
/MCU/SPI1.INT_BMP: U1.33 (GPIO_EXTI1); also elsewhere on the board
/MCU/SPI1.INT_IMU_ACC: U1.46 (GPIO_EXTI15); also elsewhere on the board
/MCU/SPI1.INT_IMU_GYRO: U1.34 (GPIO_EXTI2); also elsewhere on the board
/MCU/SPI1.MISO: U1.28 (SPI1_MISO); also elsewhere on the board
/MCU/SPI1.MOSI: U1.29 (SPI1_MOSI); also elsewhere on the board
/MCU/SPI1.SCK: U1.27 (SPI1_SCK); also elsewhere on the board
/MCU/SPI2.BUSY: U1.57 (GPIO_Input); also elsewhere on the board
/MCU/SPI2.CS: U1.51 (GPIO_Output); also elsewhere on the board
/MCU/SPI2.MISO: U1.53 (SPI2_MISO); also elsewhere on the board
/MCU/SPI2.MOSI: U1.54 (SPI2_MOSI); also elsewhere on the board
/MCU/SPI2.RST: U1.58 (GPIO_Output); also elsewhere on the board
/MCU/SPI2.SCK: U1.52 (SPI2_SCK); also elsewhere on the board
/MCU/SPI4.MISO: U1.44 (SPI4_MISO); also elsewhere on the board
/MCU/SPI4.MOSI: U1.45 (SPI4_MOSI); also elsewhere on the board
/MCU/SPI4.SCK: U1.43 (SPI4_SCK); also elsewhere on the board
/MCU/USB_D+: U1.73 (USB_DP); also elsewhere on the board
/MCU/USB_D-: U1.72 (USB_DM); also elsewhere on the board
/MCU/VREFP: C5.1, C6.1, R1.2, U1.36 (VREF+)
/Power/VOLT_SENSE: U1.15 (ADC1_IN6); also elsewhere on the board
/Sensors/M10S.RX: U1.22 (USART2_TX); also elsewhere on the board
/Sensors/M10S.TX: U1.25 (USART2_RX); also elsewhere on the board
GND: C1.2, C2.2, C3.2, C4.2, C5.2, C6.2, C7.2, C8.2, C9.2, C10.2, C11.2, C12.2, C13.2, C14.2, C15.2, C16.2, C17.2, R3.2, SW1.1, U1.23 (VSS), U1.35 (VSSA), U1.48 (VSS), U1.63 (VSS), U1.74 (VSS), U1.99 (VSS), Y1.2 (GND), Y1.4 (GND); also elsewhere on the board

Notes on the sheet:
Used in VCP for SWD
MCU Power Management
Place R2 and C14 close to NRST pin
VREF+ and VDDA cap layout from Fig. 38
Add NRST silkscreen on SW1
MCU Pinouts

Board: 4 copper layers, 166 parts (2 on the bottom side), 134 nets, no tracks yet.
