stanford-ssi/Aerolotl_AV/pre-audit-backup/aerolotl_av.kicad_pcb

## KiCad design pre-audit-backup/aerolotl_av.kicad_pcb (2026-10-07, an earlier design)

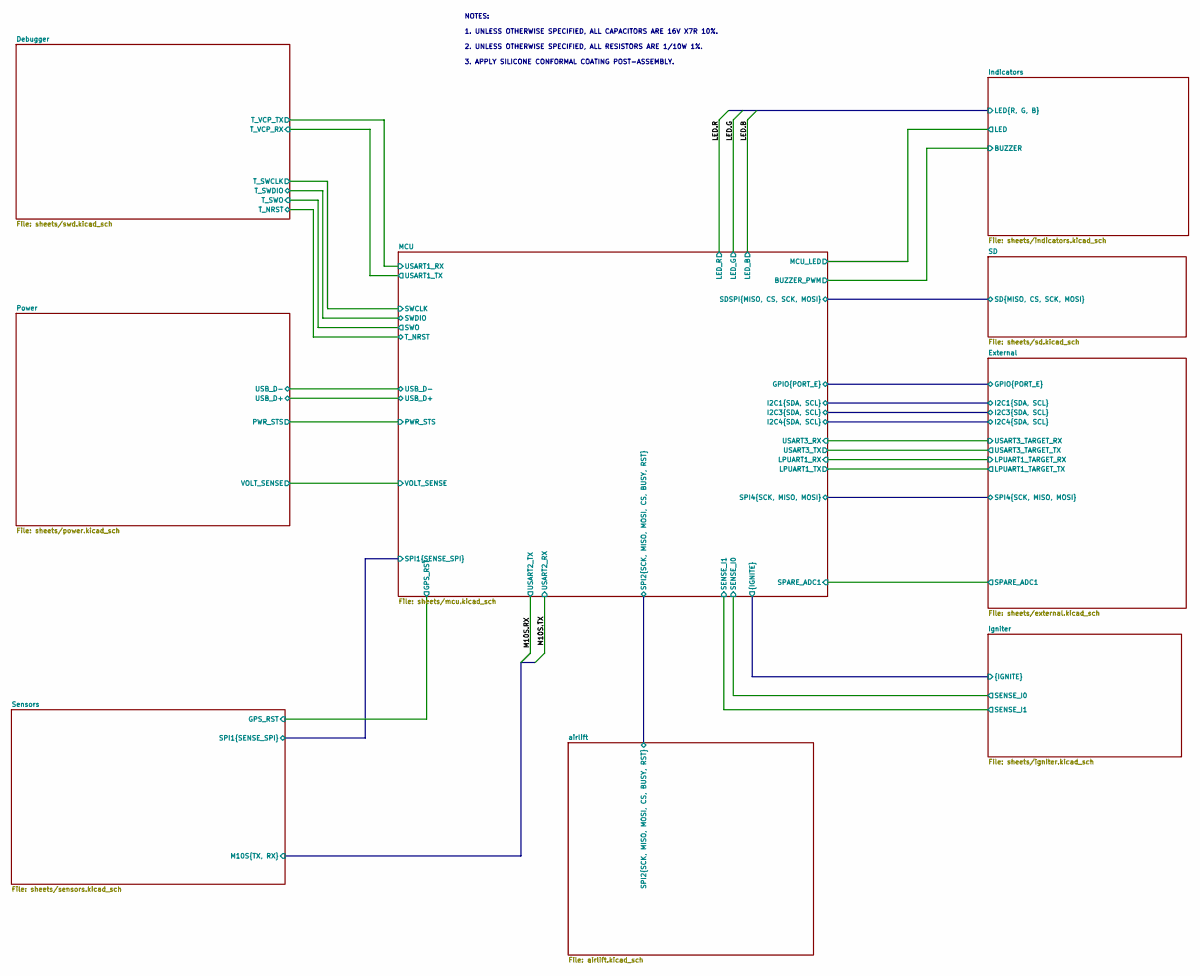
[picture p16: schematic aerolotl_av.kicad_sch, AEROLOTL AVIONICS FLIGHT COMPUTER]

Notes on the sheet:
NOTES: 1. UNLESS OTHERWISE SPECIFIED, ALL CAPACITORS ARE 16V X7R 10%. 2. UNLESS OTHERWISE SPECIFIED, ALL RESISTORS ARE 1/10W 1%. 3. APPLY SILICONE CONFORMAL COATING POST-ASSEMBLY.


Parts:
J1: FTSH-107-STDC14; STDC14_SAMTEC_FTSH-107-01-L-DV-K-A; PARTREV H
R4: 100; R_0402_1005Metric

Connections:
+3V3: J1.03; also elsewhere on the board
/Debugger/GNDDetect: J1.11, R4.2
/Debugger/T_NRST: J1.12; also elsewhere on the board
/Debugger/T_SWCLK: J1.06; also elsewhere on the board
/Debugger/T_SWDIO: J1.04; also elsewhere on the board
/Debugger/T_SWO: J1.08; also elsewhere on the board
/Debugger/T_VCP_RX: J1.14; also elsewhere on the board
/Debugger/T_VCP_TX: J1.13; also elsewhere on the board

Notes on the sheet:
possibly swd termination

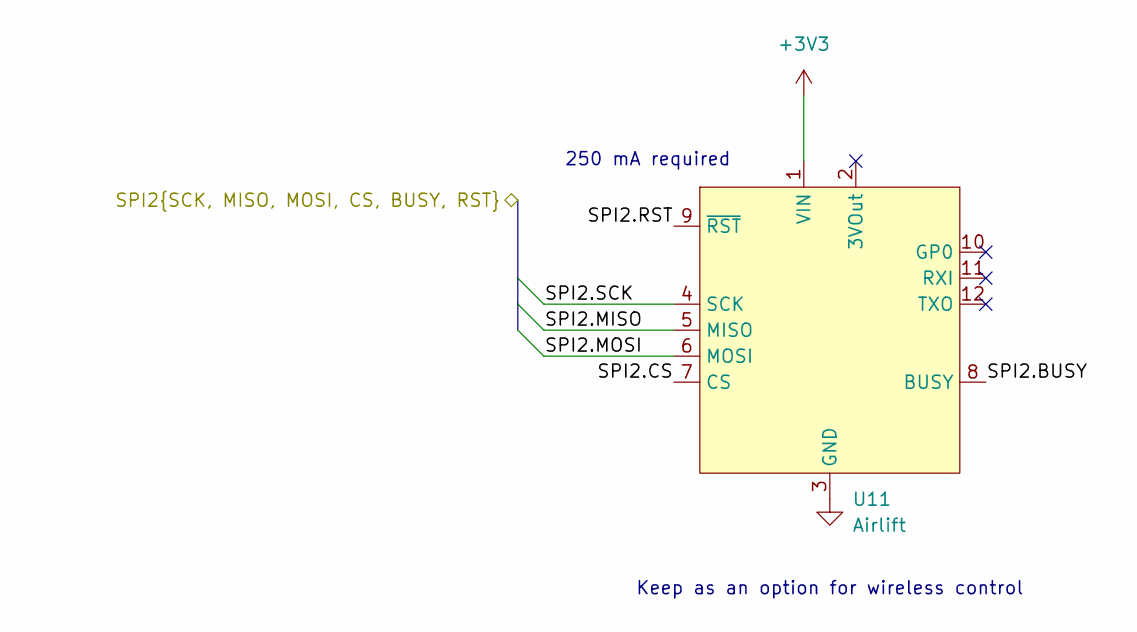
[picture p17: schematic airlift.kicad_sch]

Parts:
U11: Airlift; PinSocket_1x12_P2.54mm_Vertical; Mfr. Part No. 4201

Connections:
+3V3: U11.1 (VIN); also elsewhere on the board
/MCU/SPI2.BUSY: U11.8 (BUSY); also elsewhere on the board
/MCU/SPI2.CS: U11.7 (CS); also elsewhere on the board
/MCU/SPI2.MISO: U11.5 (MISO); also elsewhere on the board
/MCU/SPI2.MOSI: U11.6 (MOSI); also elsewhere on the board
/MCU/SPI2.RST: U11.9 (~RST); also elsewhere on the board
/MCU/SPI2.SCK: U11.4 (SCK); also elsewhere on the board

Notes on the sheet:
250 mA required
Keep as an option for wireless control

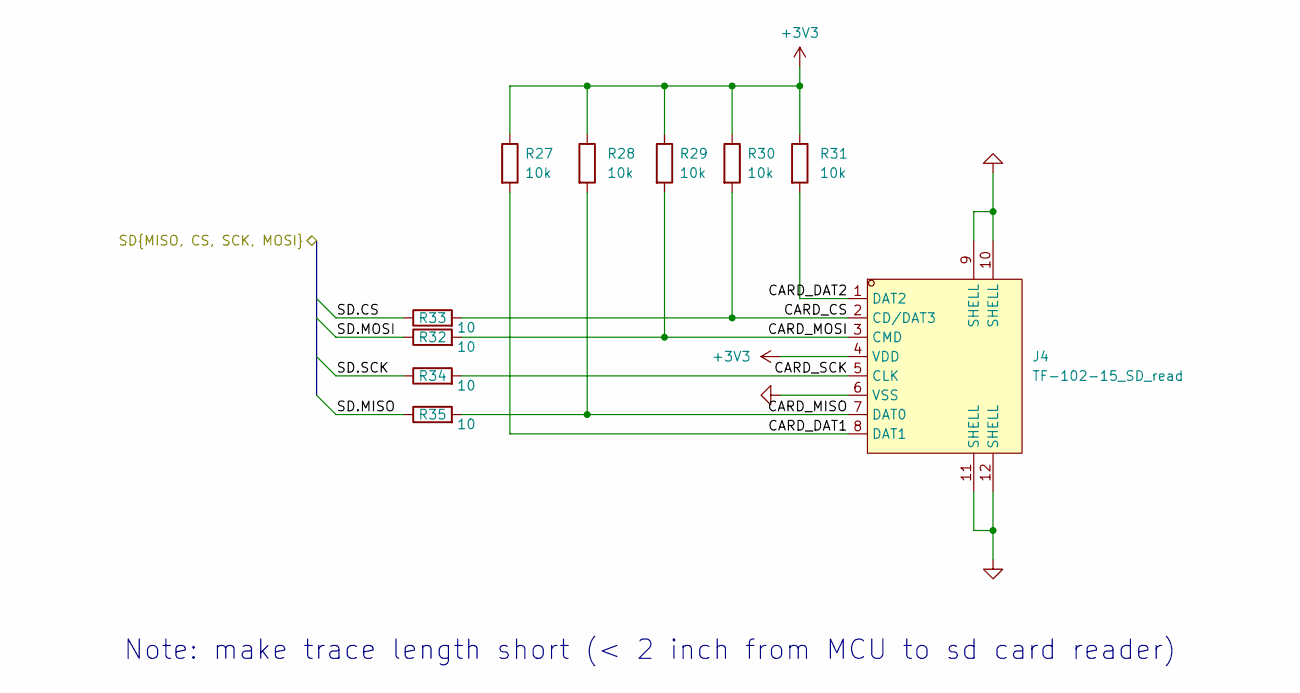
[picture p18: schematic sd.kicad_sch]

Parts:
J4: TF-102-15_SD_read; TF-SMD_TF-102-15; LCSC Part C266609
R27, R28, R29, R30, R31: 10k; R_0402_1005Metric; LCSC Part C25744
R32, R33, R34, R35: 10; R_0402_1005Metric

Connections:
+3V3: J4.4 (VDD), R27.1, R28.1, R29.1, R30.1, R31.1; also elsewhere on the board
/MCU/SDSPI.CS: R33.1; also elsewhere on the board
/MCU/SDSPI.MISO: R35.1; also elsewhere on the board
/MCU/SDSPI.MOSI: R32.1; also elsewhere on the board
/MCU/SDSPI.SCK: R34.1; also elsewhere on the board
/SD/CARD_CS: J4.2 (CD/DAT3), R30.2, R33.2
/SD/CARD_DAT1: J4.8 (DAT1), R27.2
/SD/CARD_DAT2: J4.1 (DAT2), R31.2
/SD/CARD_MISO: J4.7 (DAT0), R28.2, R35.2
/SD/CARD_MOSI: J4.3 (CMD), R29.2, R32.2
/SD/CARD_SCK: J4.5 (CLK), R34.2

Notes on the sheet:
Note: make trace length short (< 2 inch from MCU to sd card reader)

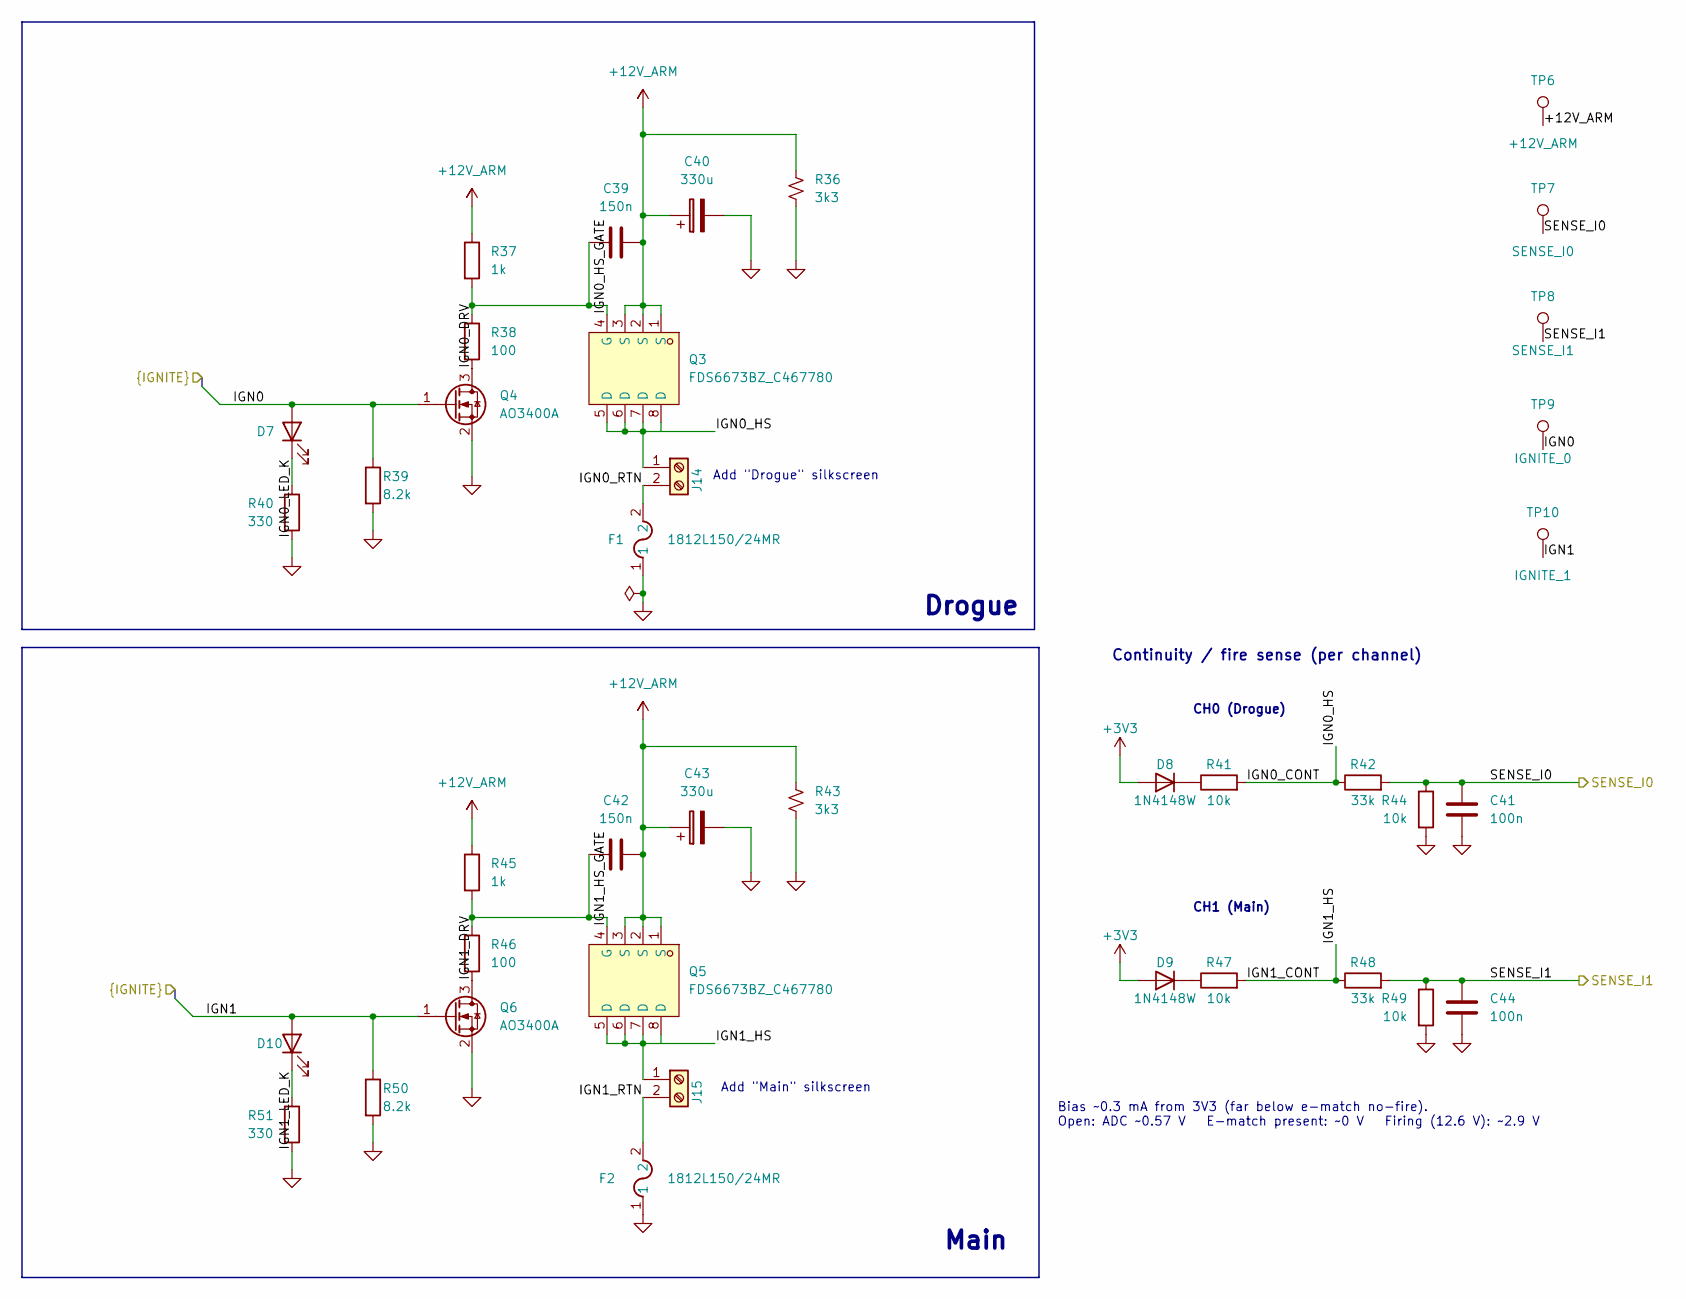
[picture p19: schematic igniter.kicad_sch]

Parts:
C39, C42: 150n; C_0603_1608Metric
C40, C43: 330u; CP_Elec_8x10
C41, C44: 100n; C_0402_1005Metric; LCSC Part C1525
D7, D10: LED; LED_0603_1608Metric
D8, D9: 1N4148W; D_SOD-123; LCSC Part C81598
F1, F2: 1812L150/24MR; FUSE_1812L150&slash_24_LTF
J14, J15: Screw_Terminal_01x02; TerminalBlock_Phoenix_MKDS-1,5-2-5.08_1x02_P5.08mm_Horizont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; LCSC Part C8465
Q3, Q5: FDS6673BZ_C467780; SOIC-8_L4.9-W3.9-P1.27-LS6.0-BL; LCSC Part C467780
Q4, Q6: AO3400A; SOT-23
R36, R43: 3k3; R_0603_1608Metric
R37, R45: 1k; R_1206_3216Metric
R38, R46: 100; R_0402_1005Metric
R39, R50: 8.2k; R_0402_1005Metric
R40, R51: 330; R_0402_1005Metric
R41, R44, R47, R49: 10k; R_0402_1005Metric; LCSC Part C25744
R42, R48: 33k; R_0402_1005Metric
TP6: +12V_ARM; TestPoint_Plated_Hole_D2.0mm
TP7: SENSE_I0; TestPoint_Plated_Hole_D2.0mm
TP8: SENSE_I1; TestPoint_Plated_Hole_D2.0mm
TP9: IGNITE_0; TestPoint_Plated_Hole_D2.0mm
TP10: IGNITE_1; TestPoint_Plated_Hole_D2.0mm

Connections:
+3V3: D8.2 (A), D9.2 (A); also elsewhere on the board
+12V_ARM: C39.1, C40.1, C42.1, C43.1, Q3.1 (S), Q3.2 (S), Q3.3 (S), Q5.1 (S), Q5.2 (S), Q5.3 (S), R36.2, R37.1, R43.2, R45.1, TP6.1 (1_1); also elsewhere on the board
/Igniter/IGN0: D7.2 (A), Q4.1 (G), R39.1, TP9.1 (1_1); also elsewhere on the board
/Igniter/IGN0_CONT: J14.1, Q3.5 (D), Q3.6 (D), Q3.7 (D), Q3.8 (D), R41.2, R42.1
/Igniter/IGN0_DRV: Q4.3 (D), R38.2
/Igniter/IGN0_HS_GATE: C39.2, Q3.4 (G), R37.2, R38.1
/Igniter/IGN0_LED_K: D7.1 (K), R40.1
/Igniter/IGN0_RTN: F1.2, J14.2
/Igniter/IGN1: D10.2 (A), Q6.1 (G), R50.1, TP10.1 (1_1); also elsewhere on the board
/Igniter/IGN1_CONT: J15.1, Q5.5 (D), Q5.6 (D), Q5.7 (D), Q5.8 (D), R47.2, R48.1; also elsewhere on the board
/Igniter/IGN1_DRV: Q6.3 (D), R46.2
/Igniter/IGN1_HS_GATE: C42.2, Q5.4 (G), R45.2, R46.1
/Igniter/IGN1_LED_K: D10.1 (K), R51.1
/Igniter/IGN1_RTN: F2.2, J15.2
/Igniter/SENSE_I0: C41.1, R42.2, R44.1, TP7.1 (1_1); also elsewhere on the board
/Igniter/SENSE_I1: C44.1, R48.2, R49.1, TP8.1 (1_1); also elsewhere on the board
unnamed: D8.1 (K), R41.1
unnamed: D9.1 (K), R47.1

Notes on the sheet:
CH1 (Main)
Bias ~0.3 mA from 3V3 (far below e-match no-fire). Open: ADC ~0.57 V E-match present: ~0 V Firing (12.6 V): ~2.9 V
Add "Drogue" silkscreen
Add "Main" silkscreen
Continuity / fire sense (per channel)
Drogue
Main
CH0 (Drogue)

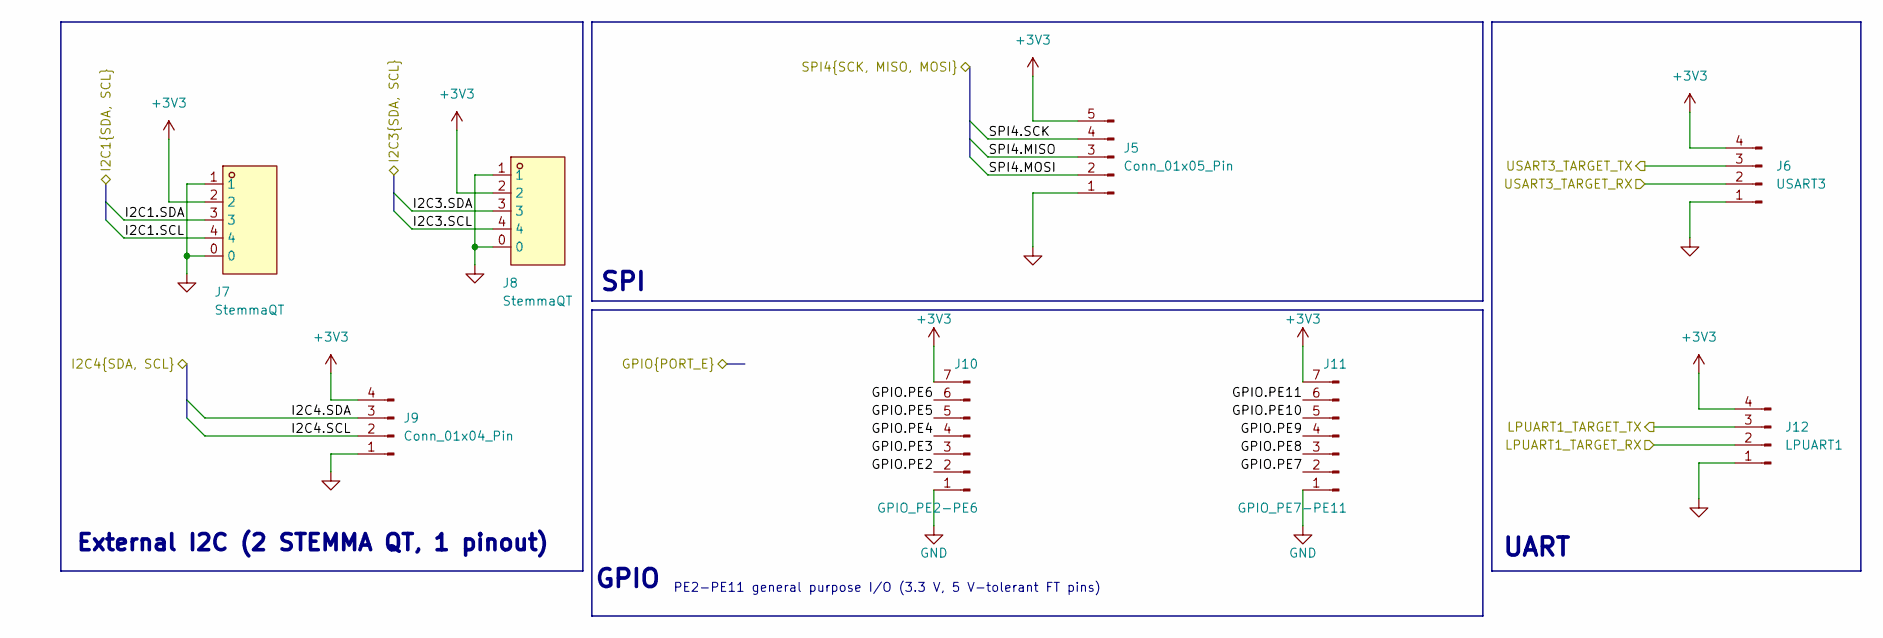
[picture p20: schematic external.kicad_sch]

Parts:
J5: Conn_01x05_Pin; JST_GH_BM05B-GHS-TBT_1x05-1MP_P1.25mm_Vertical
J6: USART3; JST_GH_BM04B-GHS-TBT_1x04-1MP_P1.25mm_Vertical
J7, J8: StemmaQT; LCSC Part C160390
J9: Conn_01x04_Pin; JST_GH_BM04B-GHS-TBT_1x04-1MP_P1.25mm_Vertical
J10: GPIO_PE2-PE6; JST_GH_BM07B-GHS-TBT_1x07-1MP_P1.25mm_Vertical; MPN SM07B-GHS-TB
J11: GPIO_PE7-PE11; JST_GH_BM07B-GHS-TBT_1x07-1MP_P1.25mm_Vertical; MPN SM07B-GHS-TB
J12: LPUART1; JST_GH_BM04B-GHS-TBT_1x04-1MP_P1.25mm_Vertical

Connections:
+3V3: J5.5, J6.4, J7.2, J8.2, J9.4, J10.7, J11.7, J12.4; also elsewhere on the board
/External/GPIO.PE2: J10.2; also elsewhere on the board
/External/GPIO.PE3: J10.3; also elsewhere on the board
/External/GPIO.PE4: J10.4; also elsewhere on the board
/External/GPIO.PE5: J10.5; also elsewhere on the board
/External/GPIO.PE6: J10.6; also elsewhere on the board
/External/GPIO.PE7: J11.2; also elsewhere on the board
/External/GPIO.PE8: J11.3; also elsewhere on the board
/External/GPIO.PE9: J11.4; also elsewhere on the board
/External/GPIO.PE10: J11.5; also elsewhere on the board
/External/GPIO.PE11: J11.6; also elsewhere on the board
/External/I2C1.SCL: J7.4; also elsewhere on the board
/External/I2C1.SDA: J7.3; also elsewhere on the board
/External/I2C3.SCL: J8.4; also elsewhere on the board
/External/I2C3.SDA: J8.3; also elsewhere on the board
/External/I2C4.SCL: J9.2; also elsewhere on the board
/External/I2C4.SDA: J9.3; also elsewhere on the board
/External/LPUART1_TARGET_RX: J12.2; also elsewhere on the board
/External/LPUART1_TARGET_TX: J12.3; also elsewhere on the board
/External/SPI4.MISO: J5.3; also elsewhere on the board
/External/SPI4.MOSI: J5.2; also elsewhere on the board
/External/SPI4.SCK: J5.4; also elsewhere on the board
/External/USART3_TARGET_RX: J6.2; also elsewhere on the board
/External/USART3_TARGET_TX: J6.3; also elsewhere on the board

Notes on the sheet:
External I2C (2 STEMMA QT, 1 pinout)
SPI
PE2-PE11 general purpose I/O (3.3 V, 5 V-tolerant FT pins)
GPIO
UART
