stanford-ssi/Aerolotl_AV/pre-audit-backup/aerolotl_av.kicad_pcb

## KiCad design pre-audit-backup/aerolotl_av.kicad_pcb (continued)

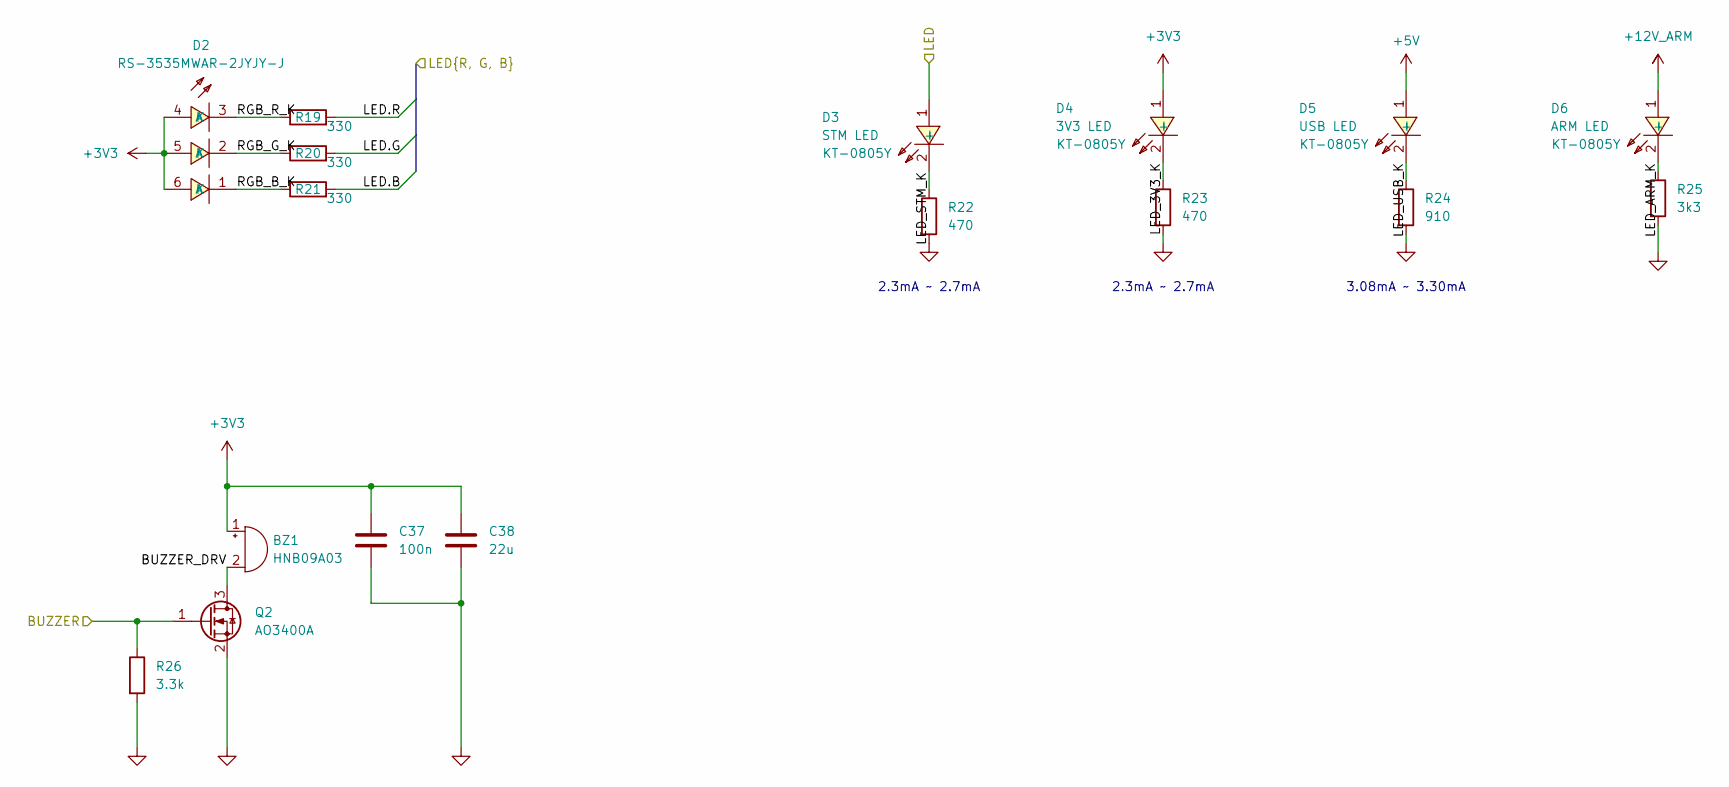
[picture p21: schematic indicators.kicad_sch, AEROLOTL NEW COLLINS FLIGHT COMPUTER]

Parts:
BZ1: HNB09A03; BUZ-TH_BD9.0-P5.00-D0.6-FD
C37: 100n; C_0402_1005Metric; LCSC Part C1525
C38: 22u; C_0805_2012Metric; LCSC Part C45783
D2: RS-3535MWAR-2JYJY-J; LED-SMD_RS-3535MWAR-2JYJY-J; MPN RS-3535MWAR; LCSC Part C110402
D3: STM LED; LED0805-R-RD; LCSC Part C2296
D4: 3V3 LED; LED0805-R-RD; LCSC Part C2296
D5: USB LED; LED0805-R-RD; LCSC Part C2296
D6: ARM LED; LED0805-R-RD; LCSC Part C2296
Q2: AO3400A; SOT-23
R19, R20, R21: 330; R_0402_1005Metric
R22, R23: 470; R_0402_1005Metric
R24: 910; R_0402_1005Metric
R25: 3k3; R_0603_1608Metric
R26: 3.3k; R_0402_1005Metric

Connections:
+3V3: BZ1.1 (+), C37.1, C38.1, D2.4 (A), D2.5 (A), D2.6 (A), D4.1 (+); also elsewhere on the board
+5V: D5.1 (+); also elsewhere on the board
+12V_ARM: D6.1 (+); also elsewhere on the board
/Indicators/BUZZER: Q2.1 (G), R26.1; also elsewhere on the board
/Indicators/BUZZER_DRV: BZ1.2 (-), Q2.3 (D)
/Indicators/LED: D3.1 (+); also elsewhere on the board
/Indicators/LED.B: R21.2; also elsewhere on the board
/Indicators/LED.G: R20.2; also elsewhere on the board
/Indicators/LED.R: R19.2; also elsewhere on the board
/Indicators/LED_3V3_K: D4.2 (-), R23.1
/Indicators/LED_ARM_K: D6.2 (-), R25.1
/Indicators/LED_STM_K: D3.2 (-), R22.1
/Indicators/LED_USB_K: D5.2 (-), R24.1
/Indicators/RGB_B_K: D2.1 (K), R21.1
/Indicators/RGB_G_K: D2.2 (K), R20.1
/Indicators/RGB_R_K: D2.3 (K), R19.1

Notes on the sheet:
2.3mA ~ 2.7mA
3.08mA ~ 3.30mA

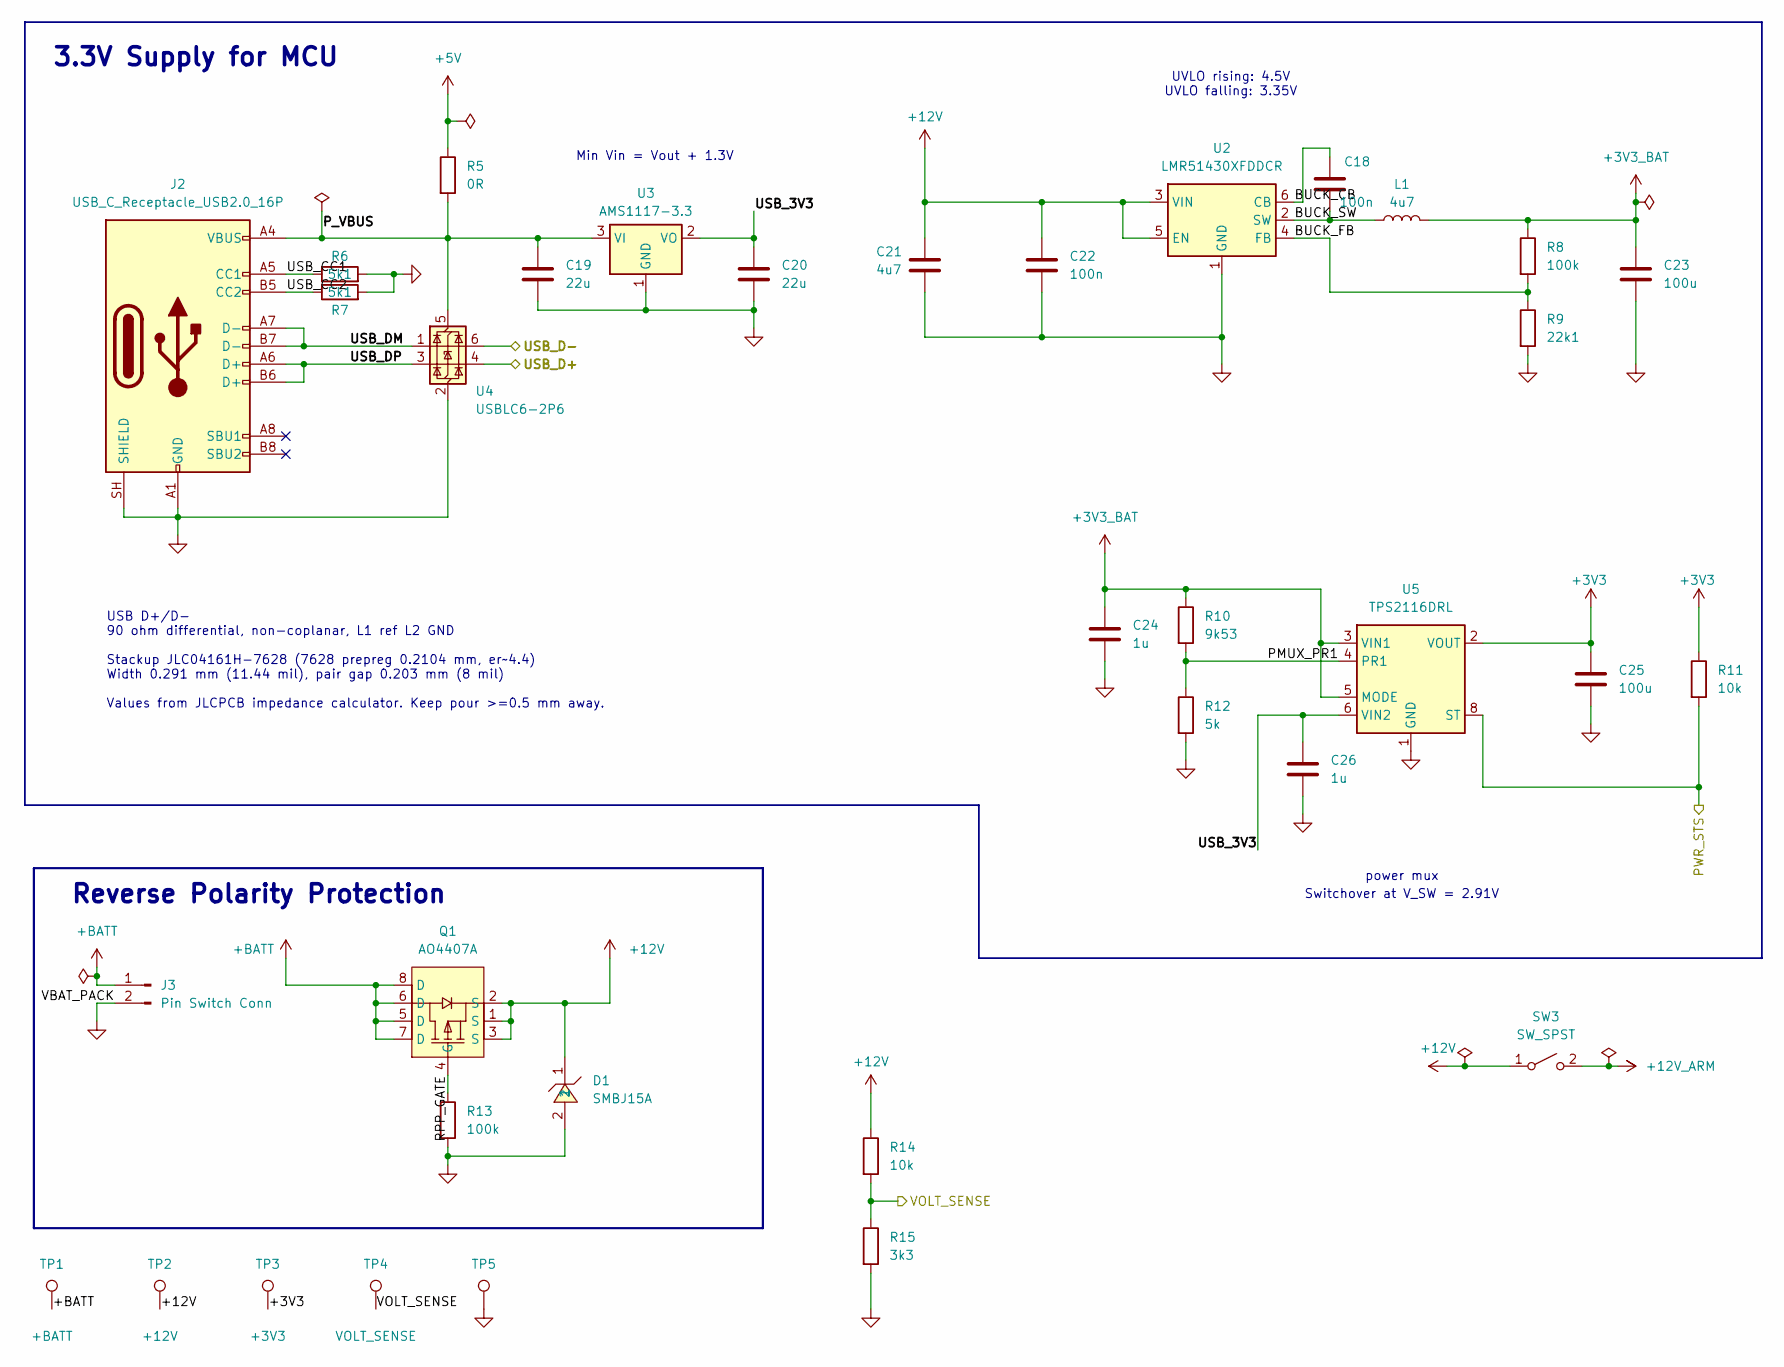
[picture p22: schematic power.kicad_sch]

Parts:
C18, C22: 100n; C_0603_1608Metric; LCSC Part C14663
C19, C20: 22u; C_0805_2012Metric; LCSC Part C45783
C21: 4u7; C_0805_2012Metric; Voltage 50V
C23, C25: 100u; C_1206_3216Metric
C24, C26: 1u; C_0402_1005Metric
D1: SMBJ15A; SMB_L4.6-W3.6-LS5.3-RD; LCSC Part C83846
J2: USB_C_Receptacle_USB2.0_16P; USB_C_Receptacle_HRO_TYPE-C-31-M-12
J3: Pin Switch Conn; AMASS_XT30PW-M_1x02_P2.50mm_Horizontal
L1: 4u7; L_Sunlord_SWPA4030S
Q1: AO4407A; SOIC-8_L4.9-W3.9-P1.27-LS6.0-BL; LCSC Part C16072
R5: 0R; R_0603_1608Metric
R6, R7: 5k1; R_0402_1005Metric
R8, R13: 100k; R_0402_1005Metric
R9: 22k1; R_0402_1005Metric
R10: 9k53; R_0402_1005Metric
R11, R14: 10k; R_0402_1005Metric; LCSC Part C25744
R12: 5k; R_0402_1005Metric
R15: 3k3; R_0402_1005Metric
SW3: SW_SPST; JST_XH_B2B-XH-A_1x02_P2.50mm_Vertical
TP1: +BATT; TestPoint_Plated_Hole_D2.0mm
TP2: +12V; TestPoint_Plated_Hole_D2.0mm
TP3: +3V3; TestPoint_Plated_Hole_D2.0mm
TP4: VOLT_SENSE; TestPoint_Plated_Hole_D2.0mm
TP5: GND; TestPoint_Plated_Hole_D2.0mm
U2: LMR51430XFDDCR; SOT-23-6
U3: AMS1117-3.3; SOT-223-3_TabPin2
U4: USBLC6-2P6; SOT-666
U5: TPS2116DRL; SOT-583-8; LCSC C3235557

Connections:
+3V3: C25.1, R11.1, TP3.1 (1_1), U5.2 (VOUT), U5.7 (VOUT); also elsewhere on the board
+3V3_BAT: C23.1, C24.1, L1.2, R8.1, R10.1, U5.3 (VIN1), U5.5 (MODE)
+5V: R5.1; also elsewhere on the board
+12V: C21.1, C22.1, D1.1, Q1.1 (S), Q1.2 (S), Q1.3 (S), R14.1, SW3.1 (A), TP2.1 (1_1), U2.3 (VIN), U2.5 (EN)
+12V_ARM: SW3.2 (B); also elsewhere on the board
+BATT: J3.1, Q1.5 (D), Q1.6 (D), Q1.7 (D), Q1.8 (D), TP1.1 (1_1)
/MCU/PWR_STS: R11.2, U5.8 (ST); also elsewhere on the board
/MCU/USB_D+: U4.4 (I/O2); also elsewhere on the board
/MCU/USB_D-: U4.6 (I/O1); also elsewhere on the board
/Power/BUCK_CB: C18.1, U2.6 (CB)
/Power/BUCK_FB: R8.2, R9.1, U2.4 (FB)
/Power/BUCK_SW: C18.2, L1.1, U2.2 (SW)
/Power/PMUX_PR1: R10.2, R12.1, U5.4 (PR1)
/Power/P_VBUS: C19.1, J2.A4 (VBUS), J2.A9 (VBUS), J2.B4 (VBUS), J2.B9 (VBUS), R5.2, U3.3 (VI), U4.5 (VBUS)
/Power/RPP_GATE: Q1.4 (G), R13.1
/Power/USB_3V3: C20.1, C26.1, U3.2 (VO), U5.6 (VIN2)
/Power/USB_CC1: J2.A5 (CC1), R6.1
/Power/USB_CC2: J2.B5 (CC2), R7.1
/Power/USB_DM: J2.A7 (D-), J2.B7 (D-), U4.1 (I/O1)
/Power/USB_DP: J2.A6 (D+), J2.B6 (D+), U4.3 (I/O2)
/Power/VOLT_SENSE: R14.2, R15.1, TP4.1 (1_1); also elsewhere on the board

Notes on the sheet:
3.3V Supply for MCU
power mux
Switchover at V_SW = 2.91V
Reverse Polarity Protection
UVLO rising: 4.5V UVLO falling: 3.35V
Min Vin = Vout + 1.3V
USB D+/D- 90 ohm differential, non-coplanar, L1 ref L2 GND Stackup JLC04161H-7628 (7628 prepreg 0.2104 mm, er~4.4) Width 0.291 mm (11.44 mil), pair gap 0.203 mm (8 mil) Values from JLCPCB impedance calculator. Keep pour >=0.5 mm away.

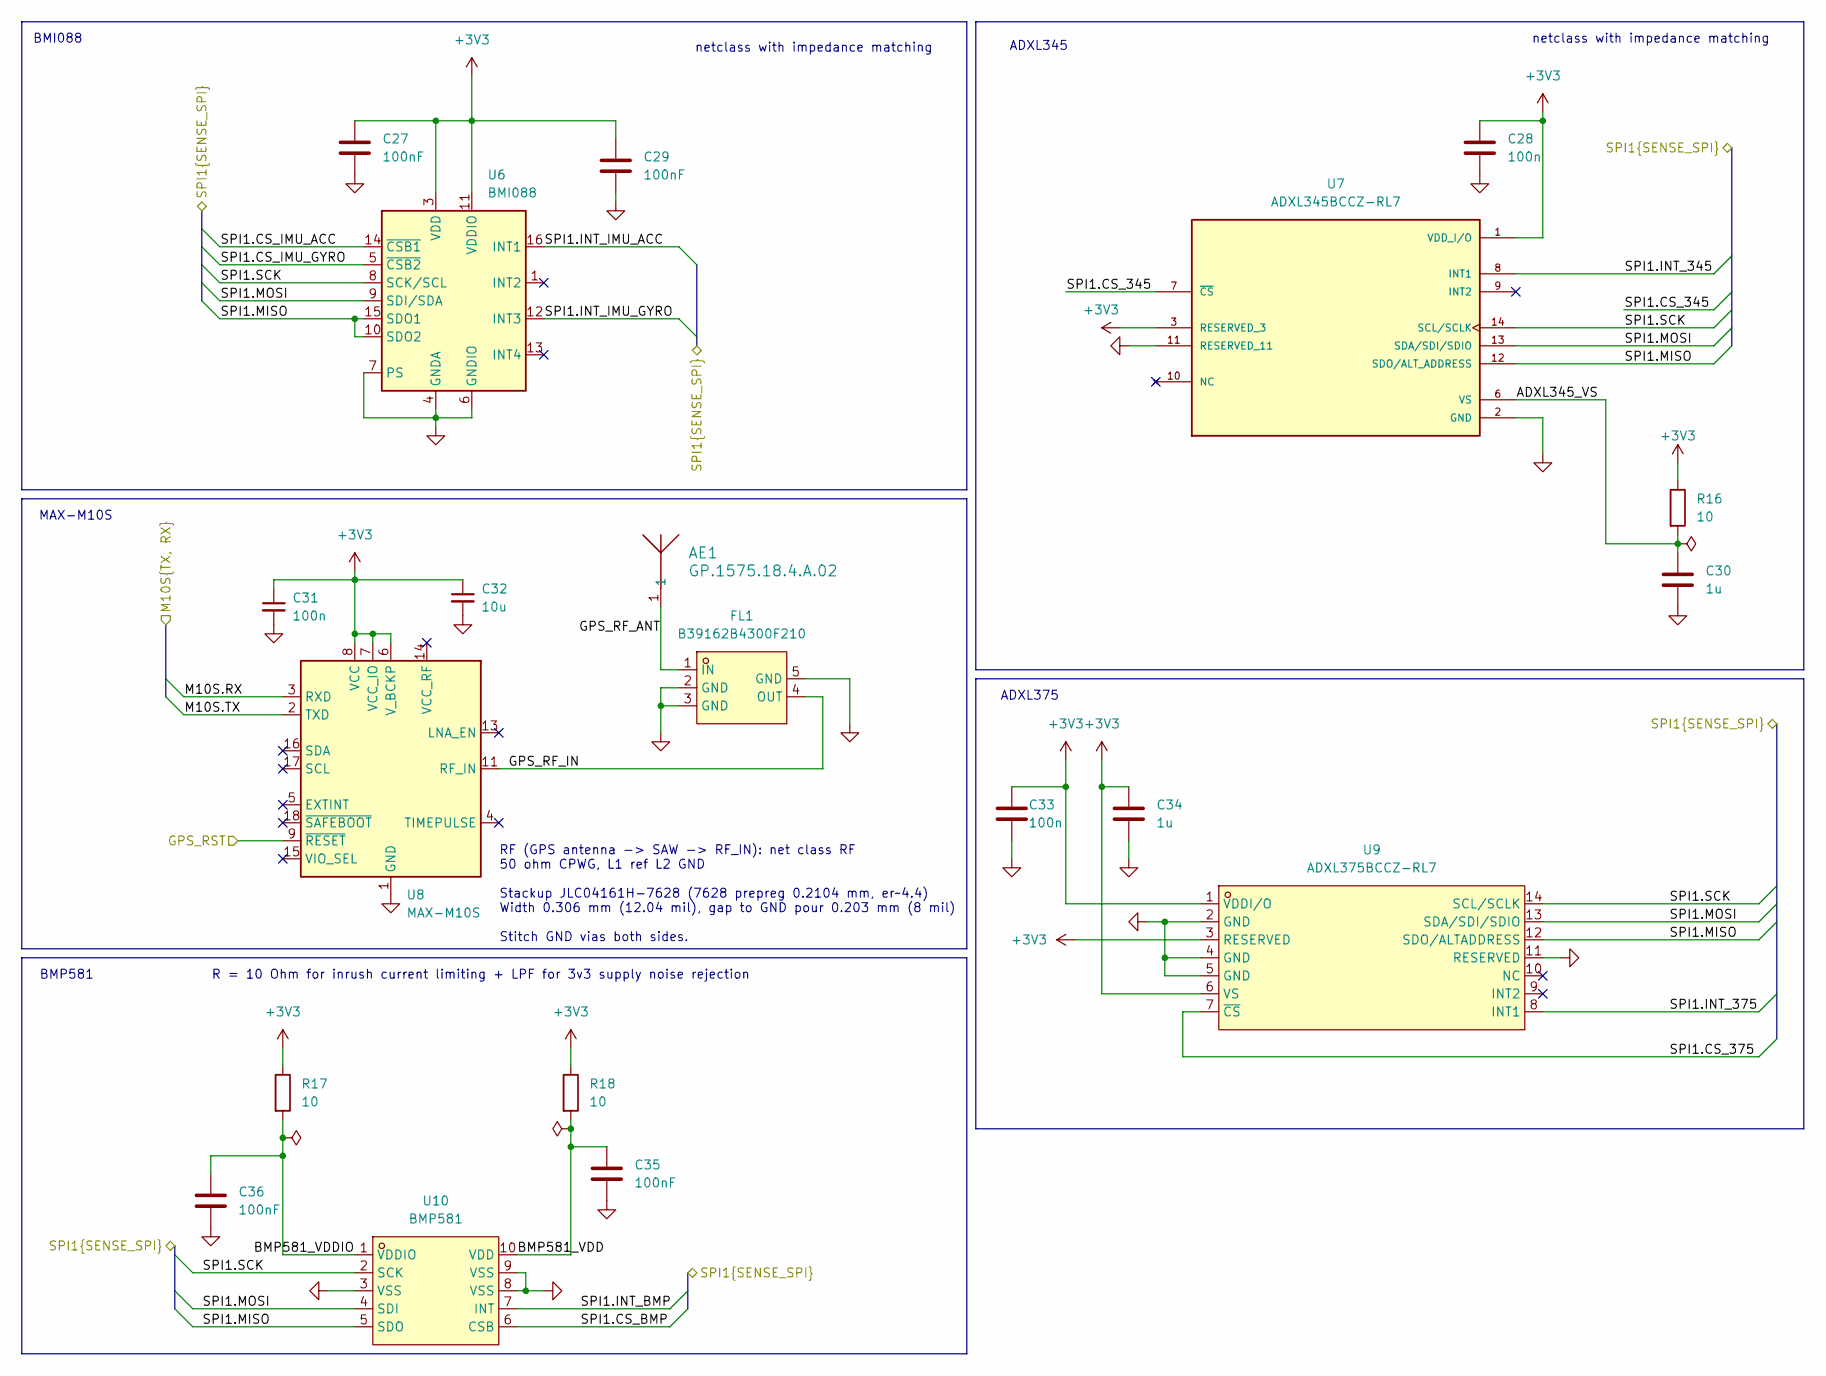
[picture p23: schematic sensors.kicad_sch]

Parts:
AE1: GP.1575.18.4.A.02; ANT_GP.1575.18.4.A.02_TAL
C27, C29, C35, C36: 100nF; C_0402_1005Metric; LCSC Part C1525
C28, C31, C33: 100n; C_0402_1005Metric; LCSC Part C1525
C30, C34: 1u; C_0402_1005Metric
C32: 10u; C_0603_1608Metric; LCSC Part C19702
FL1: B39162B4300F210; FILTER-SMD_5P-L1.4-W1.1_RSFPXXXXD; LCSC Part C2650962
R16, R17, R18: 10; R_0402_1005Metric
U6: BMI088; Bosch_LGA-16_4.5x3mm_P0.5mm_LayoutBorder7x1y_ClockwisePinNu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
U7: ADXL345BCCZ-RL7; ADXL345; PARTREV B
U8: MAX-M10S; ublox_MAX
U9: ADXL375BCCZ-RL7; ADXL375_LGA-14_L5.0-W3.0-P0.80-BL; LCSC Part C481898
U10: BMP581; LGA-10_L2.0-W2.0-P0.50-TL_BMP581; LCSC Part C5362283

Connections:
+3V3: C27.1, C28.1, C29.1, C31.1, C32.1, C33.1, C34.1, R16.1, R17.1, R18.1, U6.3 (VDD), U6.11 (VDDIO), U7.1 (VDD_I/O), U7.3 (RESERVED_3), U8.6 (V_BCKP), U8.7 (VCC_IO), U8.8 (VCC), U9.1 (VDDI/O), U9.3 (RESERVED), U9.6 (VS); also elsewhere on the board
/MCU/GPS_RST: U8.9 (~RESET); also elsewhere on the board
/MCU/SPI1.CS_345: U7.7 (~CS); also elsewhere on the board
/MCU/SPI1.CS_375: U9.7 (~CS); also elsewhere on the board
/MCU/SPI1.CS_BMP: U10.6 (CSB); also elsewhere on the board
/MCU/SPI1.CS_IMU_ACC: U6.14 (~CSB1); also elsewhere on the board
/MCU/SPI1.CS_IMU_GYRO: U6.5 (~CSB2); also elsewhere on the board
/MCU/SPI1.INT_345: U7.8 (INT1); also elsewhere on the board
/MCU/SPI1.INT_375: U9.8 (INT1); also elsewhere on the board
/MCU/SPI1.INT_BMP: U10.7 (INT); also elsewhere on the board
/MCU/SPI1.INT_IMU_ACC: U6.16 (INT1); also elsewhere on the board
/MCU/SPI1.INT_IMU_GYRO: U6.12 (INT3); also elsewhere on the board
/MCU/SPI1.MISO: U6.10 (SDO2), U6.15 (SDO1), U7.12 (SDO/ALT_ADDRESS), U9.12 (SDO/ALTADDRESS), U10.5 (SDO); also elsewhere on the board
/MCU/SPI1.MOSI: U6.9 (SDI/SDA), U7.13 (SDA/SDI/SDIO), U9.13 (SDA/SDI/SDIO), U10.4 (SDI); also elsewhere on the board
/MCU/SPI1.SCK: U6.8 (SCK/SCL), U7.14 (SCL/SCLK), U9.14 (SCL/SCLK), U10.2 (SCK); also elsewhere on the board
/Sensors/ADXL345_VS: C30.1, R16.2, U7.6 (VS)
/Sensors/BMP581_VDD: C35.1, R18.2, U10.10 (VDD)
/Sensors/BMP581_VDDIO: C36.1, R17.2, U10.1 (VDDIO)
/Sensors/GPS_RF_ANT: AE1.1 (1_1), FL1.1 (IN)
/Sensors/GPS_RF_IN: FL1.4 (OUT), U8.11 (RF_IN)
/Sensors/M10S.RX: U8.3 (RXD); also elsewhere on the board
/Sensors/M10S.TX: U8.2 (TXD); also elsewhere on the board

Notes on the sheet:
MAX-M10S
RF (GPS antenna -> SAW -> RF_IN): net class RF 50 ohm CPWG, L1 ref L2 GND Stackup JLC04161H-7628 (7628 prepreg 0.2104 mm, er~4.4) Width 0.306 mm (12.04 mil), gap to GND pour 0.203 mm (8 mil) Stitch GND vias both sides.
ADXL375
R = 10 Ohm for inrush current limiting + LPF for 3v3 supply noise rejection
BMI088
netclass with impedance matching
ADXL345
BMP581

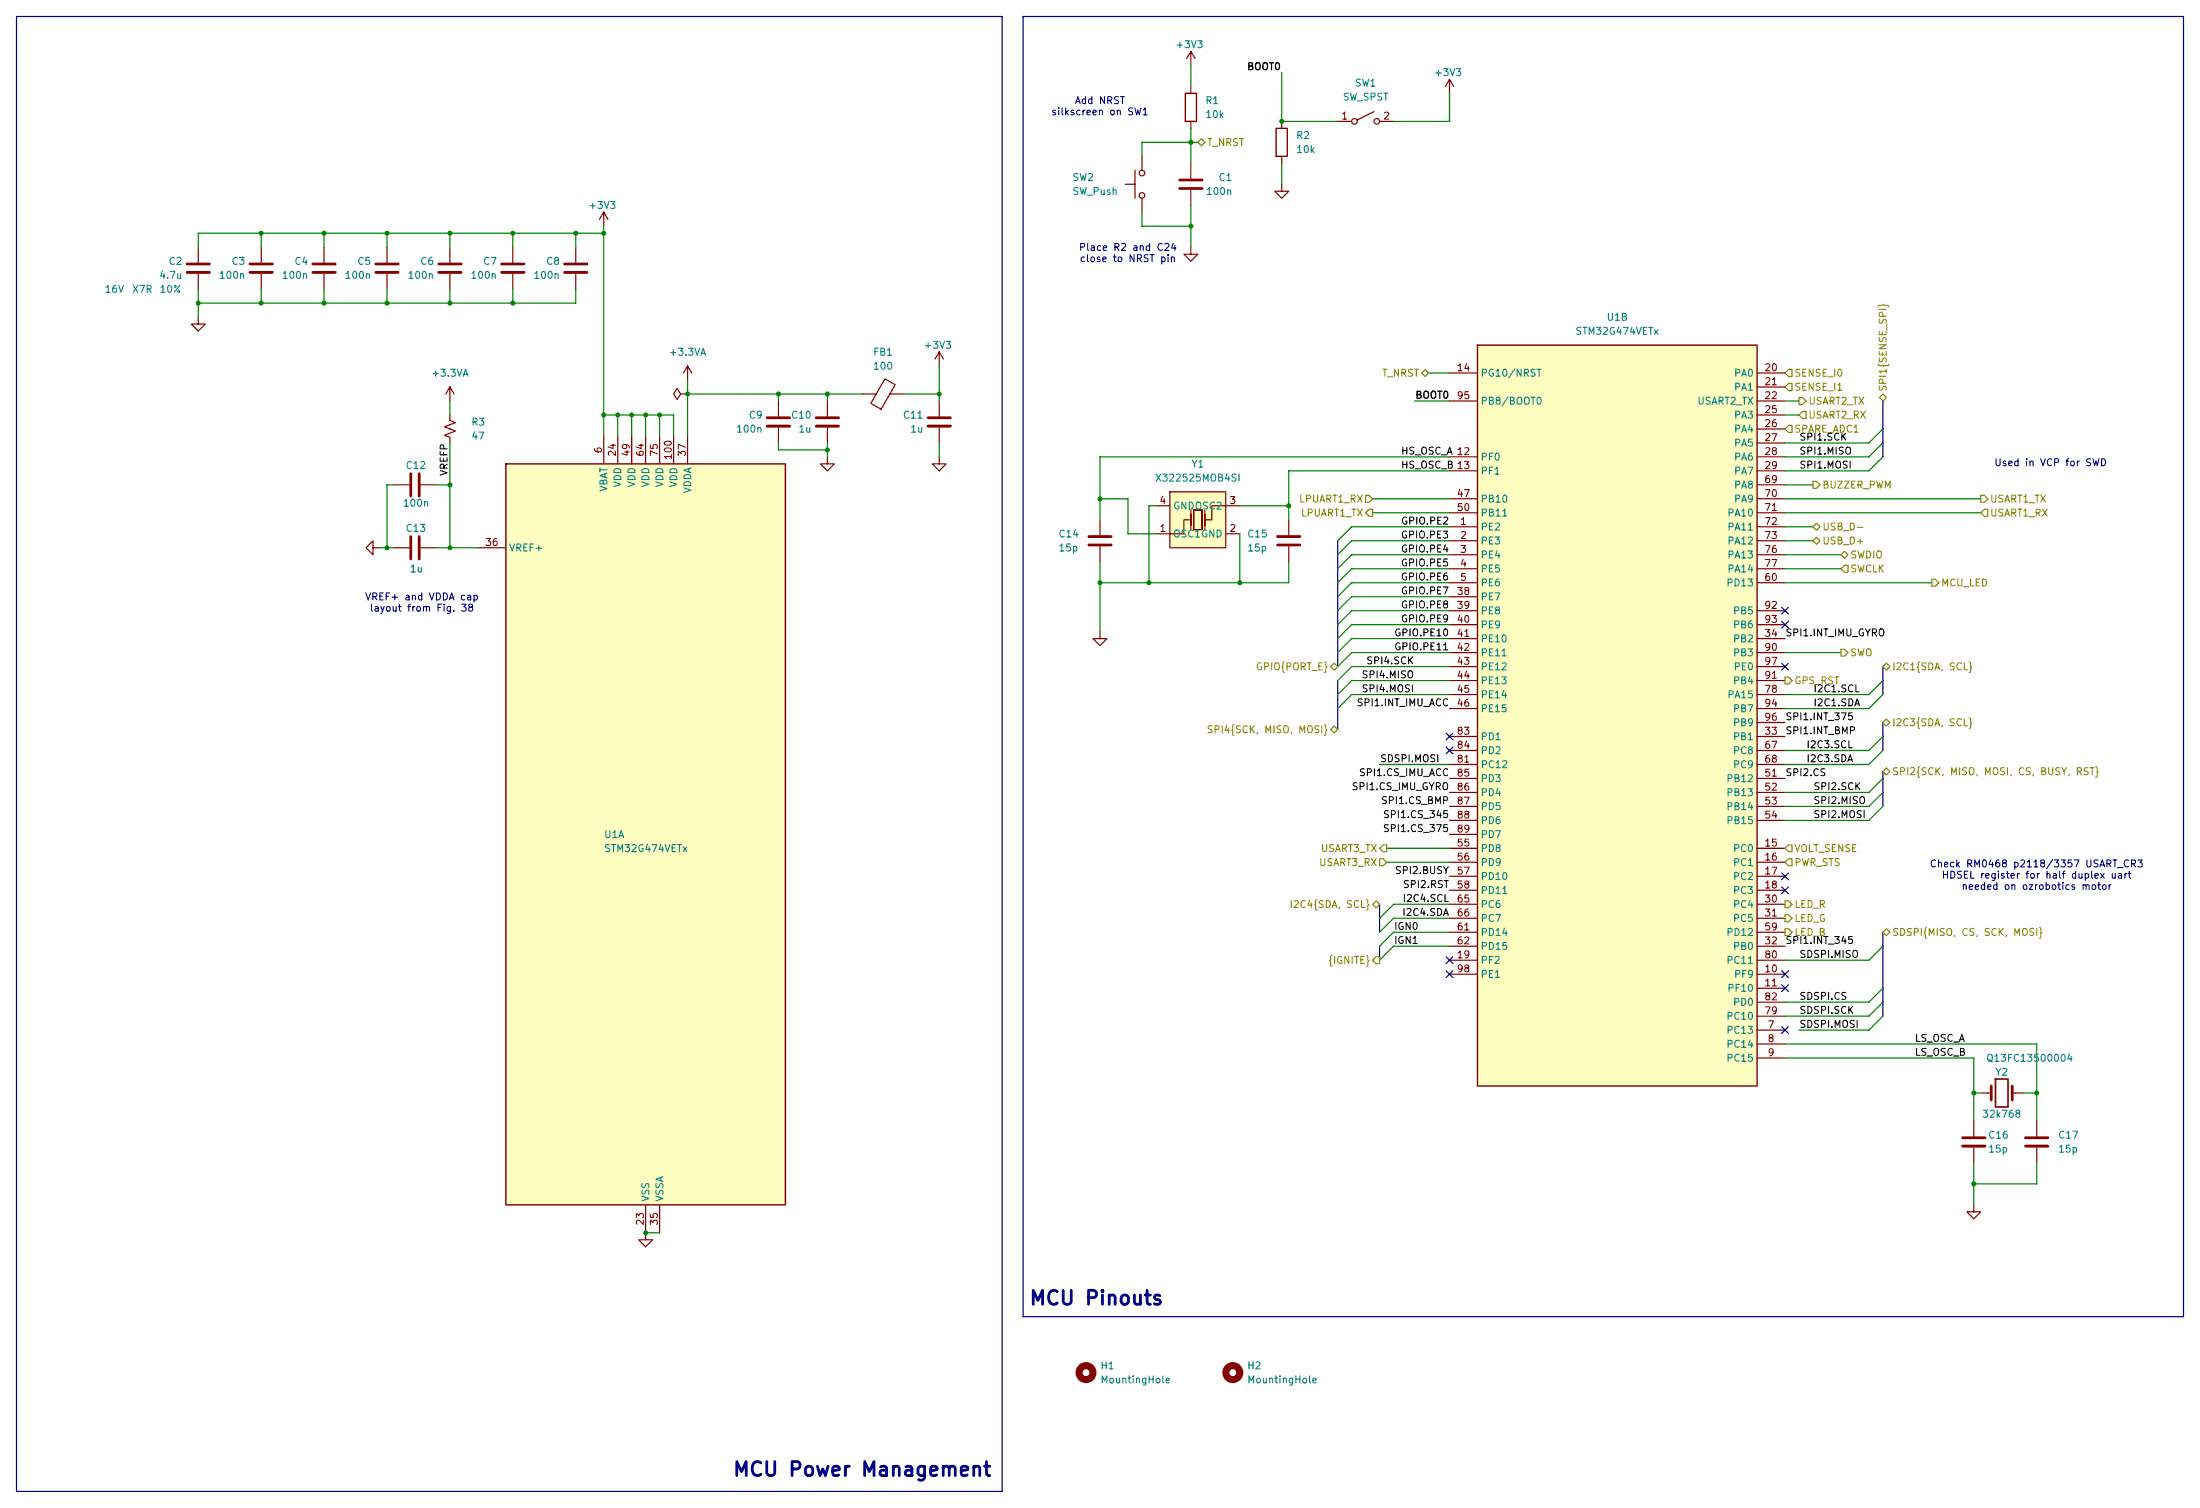
[picture p24: schematic mcu.kicad_sch, AEROLOTL NEW COLLINS FLIGHT COMPUTER]

Parts:
C1: 100n; C_0603_1608Metric
C2: 4.7u; C_0805_2012Metric; Tolerance 10%; Voltage 16V
C3, C4, C5, C6, C7, C8, C9, C12: 100n; C_0402_1005Metric
C10, C11, C13: 1u; C_0603_1608Metric
C14, C15, C16, C17: 15p; C_0402_1005Metric
FB1: 100; L_0805_2012Metric
H1, H2: MountingHole; MountingHole_6.4mm_M6_ISO7380
R1, R2: 10k; R_0603_1608Metric
R3: 47; R_0402_1005Metric
SW1: SW_SPST; SW_SPST_TL3342
SW2: SW_Push; SW_SPST_TL3342
U1: STM32G474VETx; LQFP-100_14x14mm_P0.5mm
Y1: X322525MOB4SI; CRYSTAL-SMD_4P-L3.2-W2.5-BL; LCSC Part C9006
Y2: 32k768; Crystal_SMD_3215-2Pin_3.2x1.5mm; mfr. part no. Q13FC13500004

Connections:
+3.3VA: C9.1, C10.1, FB1.1, R3.1, U1.37 (VDDA)
+3V3: C2.1, C3.1, C4.1, C5.1, C6.1, C7.1, C8.1, C11.1, FB1.2, R1.1, SW1.2 (B), U1.6 (VBAT), U1.24 (VDD), U1.49 (VDD), U1.64 (VDD), U1.75 (VDD), U1.100 (VDD); also elsewhere on the board
/Debugger/T_NRST: C1.1, R1.2, SW2.2, U1.14 (PG10/NRST); also elsewhere on the board
/Debugger/T_SWCLK: U1.77 (PA14); also elsewhere on the board
/Debugger/T_SWDIO: U1.76 (PA13); also elsewhere on the board
/Debugger/T_SWO: U1.90 (PB3); also elsewhere on the board
/Debugger/T_VCP_RX: U1.70 (PA9); also elsewhere on the board
/Debugger/T_VCP_TX: U1.71 (PA10); also elsewhere on the board
/External/GPIO.PE2: U1.1 (PE2); also elsewhere on the board
/External/GPIO.PE3: U1.2 (PE3); also elsewhere on the board
/External/GPIO.PE4: U1.3 (PE4); also elsewhere on the board
/External/GPIO.PE5: U1.4 (PE5); also elsewhere on the board
/External/GPIO.PE6: U1.5 (PE6); also elsewhere on the board
/External/GPIO.PE7: U1.38 (PE7); also elsewhere on the board
/External/GPIO.PE8: U1.39 (PE8); also elsewhere on the board
/External/GPIO.PE9: U1.40 (PE9); also elsewhere on the board
/External/GPIO.PE10: U1.41 (PE10); also elsewhere on the board
/External/GPIO.PE11: U1.42 (PE11); also elsewhere on the board
/External/I2C1.SCL: U1.78 (PA15); also elsewhere on the board
/External/I2C1.SDA: U1.94 (PB7); also elsewhere on the board
/External/I2C3.SCL: U1.67 (PC8); also elsewhere on the board
/External/I2C3.SDA: U1.68 (PC9); also elsewhere on the board
/External/I2C4.SCL: U1.65 (PC6); also elsewhere on the board
/External/I2C4.SDA: U1.66 (PC7); also elsewhere on the board
/External/LPUART1_TARGET_RX: U1.47 (PB10); also elsewhere on the board
/External/LPUART1_TARGET_TX: U1.50 (PB11); also elsewhere on the board
/External/SPARE_ADC1: U1.26 (PA4); also elsewhere on the board
/External/SPI4.MISO: U1.44 (PE13); also elsewhere on the board
/External/SPI4.MOSI: U1.45 (PE14); also elsewhere on the board
/External/SPI4.SCK: U1.43 (PE12); also elsewhere on the board
/External/USART3_TARGET_RX: U1.56 (PD9); also elsewhere on the board
/External/USART3_TARGET_TX: U1.55 (PD8); also elsewhere on the board
/Igniter/IGN0: U1.61 (PD14); also elsewhere on the board
/Igniter/IGN1: U1.62 (PD15); also elsewhere on the board
/Igniter/SENSE_I0: U1.20 (PA0); also elsewhere on the board
/Igniter/SENSE_I1: U1.21 (PA1); also elsewhere on the board
/Indicators/BUZZER: U1.69 (PA8); also elsewhere on the board
/Indicators/LED: U1.60 (PD13); also elsewhere on the board
/Indicators/LED.B: U1.59 (PD12); also elsewhere on the board
/Indicators/LED.G: U1.31 (PC5); also elsewhere on the board
/Indicators/LED.R: U1.30 (PC4); also elsewhere on the board
/MCU/BOOT0: R2.1, SW1.1 (A), U1.95 (PB8/BOOT0)
/MCU/GPS_RST: U1.91 (PB4); also elsewhere on the board
/MCU/HS_OSC_A: C14.1, U1.12 (PF0), Y1.1 (OSC1)
/MCU/HS_OSC_B: C15.1, U1.13 (PF1), Y1.3 (OSC2)
/MCU/LS_OSC_A: C17.1, U1.8 (PC14), Y2.2
/MCU/LS_OSC_B: C16.1, U1.9 (PC15), Y2.1
/MCU/PWR_STS: U1.16 (PC1); also elsewhere on the board
/MCU/SDSPI.CS: U1.82 (PD0); also elsewhere on the board
/MCU/SDSPI.MISO: U1.80 (PC11); also elsewhere on the board
/MCU/SDSPI.MOSI: U1.81 (PC12); also elsewhere on the board
/MCU/SDSPI.SCK: U1.79 (PC10); also elsewhere on the board
/MCU/SPI1.CS_345: U1.88 (PD6); also elsewhere on the board
/MCU/SPI1.CS_375: U1.89 (PD7); also elsewhere on the board
/MCU/SPI1.CS_BMP: U1.87 (PD5); also elsewhere on the board
/MCU/SPI1.CS_IMU_ACC: U1.85 (PD3); also elsewhere on the board
/MCU/SPI1.CS_IMU_GYRO: U1.86 (PD4); also elsewhere on the board
/MCU/SPI1.INT_345: U1.32 (PB0); also elsewhere on the board
/MCU/SPI1.INT_375: U1.96 (PB9); also elsewhere on the board
/MCU/SPI1.INT_BMP: U1.33 (PB1); also elsewhere on the board
/MCU/SPI1.INT_IMU_ACC: U1.46 (PE15); also elsewhere on the board
/MCU/SPI1.INT_IMU_GYRO: U1.34 (PB2); also elsewhere on the board
/MCU/SPI1.MISO: U1.28 (PA6); also elsewhere on the board
/MCU/SPI1.MOSI: U1.29 (PA7); also elsewhere on the board
/MCU/SPI1.SCK: U1.27 (PA5); also elsewhere on the board
/MCU/SPI2.BUSY: U1.57 (PD10); also elsewhere on the board
/MCU/SPI2.CS: U1.51 (PB12); also elsewhere on the board
/MCU/SPI2.MISO: U1.53 (PB14); also elsewhere on the board
/MCU/SPI2.MOSI: U1.54 (PB15); also elsewhere on the board
/MCU/SPI2.RST: U1.58 (PD11); also elsewhere on the board
/MCU/SPI2.SCK: U1.52 (PB13); also elsewhere on the board
/MCU/USB_D+: U1.73 (PA12); also elsewhere on the board
/MCU/USB_D-: U1.72 (PA11); also elsewhere on the board
/MCU/VREFP: C12.1, C13.1, R3.2, U1.36 (VREF+)
/Power/VOLT_SENSE: U1.15 (PC0); also elsewhere on the board
/Sensors/M10S.RX: U1.22 (PA2); also elsewhere on the board
/Sensors/M10S.TX: U1.25 (PA3); also elsewhere on the board

Notes on the sheet:
Used in VCP for SWD
MCU Power Management
Place R2 and C24 close to NRST pin
VREF+ and VDDA cap layout from Fig. 38
Check RM0468 p2118/3357 USART_CR3 HDSEL register for half duplex uart needed on ozrobotics motor
Add NRST silkscreen on SW1
MCU Pinouts

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
Board: 4 copper layers, 165 parts (3 on the bottom side), 129 nets, no tracks yet.

Other parts of the board:
BT1, BT2, BT3: Battery_Cell; BatteryHolder_Keystone_1042_1x18650
D9#2: 1N4148W; D_SOD-123
J13: SPARE_ADC1; JST_GH_BM03B-GHS-TBT_1x03-1MP_P1.25mm_Vertical

Their connections:
+3V3: D9#2.2 (A), J13.2; also elsewhere on the board
/External/SPARE_ADC1: J13.1; also elsewhere on the board
/Igniter/IGN1_CONT: D9#2.1 (K); also elsewhere on the board
/Power/BAT_TAP_1S: BT2.2 (-), BT3.1 (+)
/Power/BAT_TAP_2S: BT1.2 (-), BT2.1 (+)
