stanford-ssi/Aerolotl_AV/(commit log)

2026-10-07 forked into avionics pcb, trace routing needed
    [aerolotl_av.kicad_pcb, aerolotl_av.kicad_sch, aerolotl_av_BOM.xlsx, airlift.kicad_sch, external.kicad_sch, igniter.kicad_sch, indicators.kicad_sch, lora.kicad_sch]
2026-10-09 most trace routing done
    [aerolotl_av.kicad_pcb, aerolotl_av.kicad_sch, airlift.kicad_sch, external.kicad_sch, igniter.kicad_sch, indicators.kicad_sch, lora.kicad_sch, mcu.kicad_sch]
2026-10-09 cleared drc errors, routing done, warnings left
    [Heyco_G1123_grommet.step, aerolotl_av.kicad_pcb, aerolotl_av.step]
2026-10-10 all warnings and errors cleared. next step: order board
    [aerolotl_av.pre_libfix.kicad_pcb, aerolotl_av.pre_parityfix.kicad_pcb]
